trailcurrentoss/TrailCurrentCapstan/CAD/back.jpg

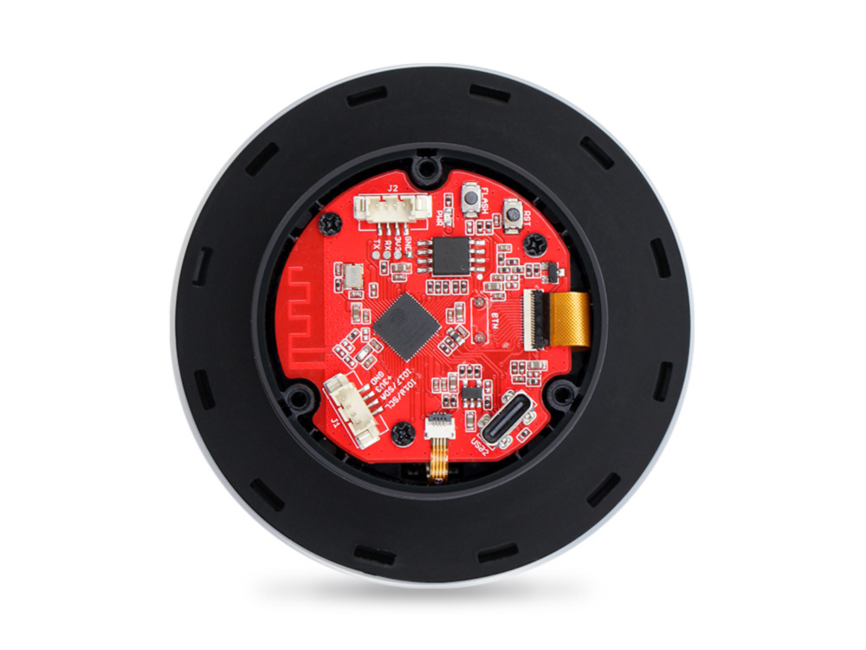
CAD/back.jpg
