trailcurrentoss/TrailCurrentCapstan/CAD/front.jpg

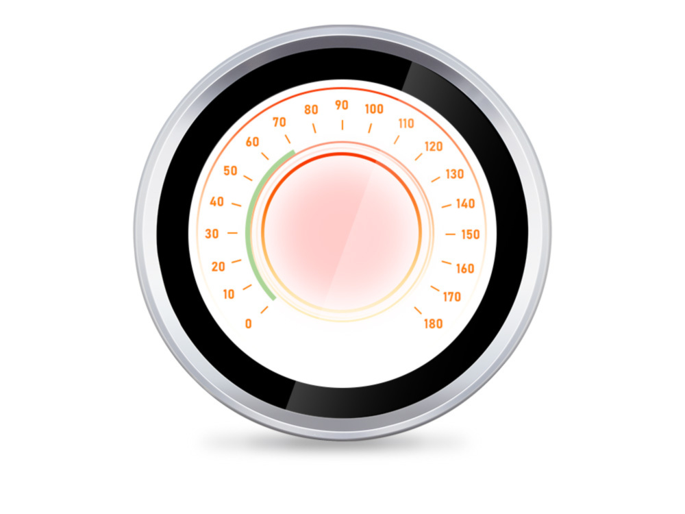
CAD/front.jpg
