trailcurrentoss/TrailCurrentCapstan/CAD/side.jpg

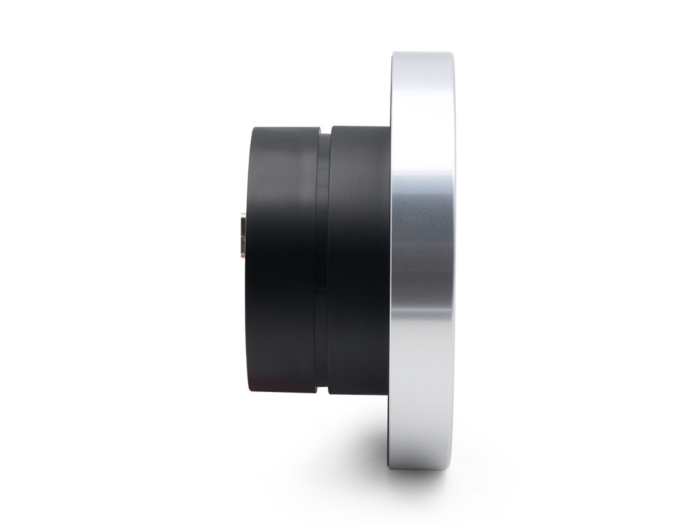
CAD/side.jpg
