trailcurrentoss/TrailCurrentCapstan/DOCS/CrowPanel1_46_in/1.46_Rotary_Display_asm_1_asm.stp

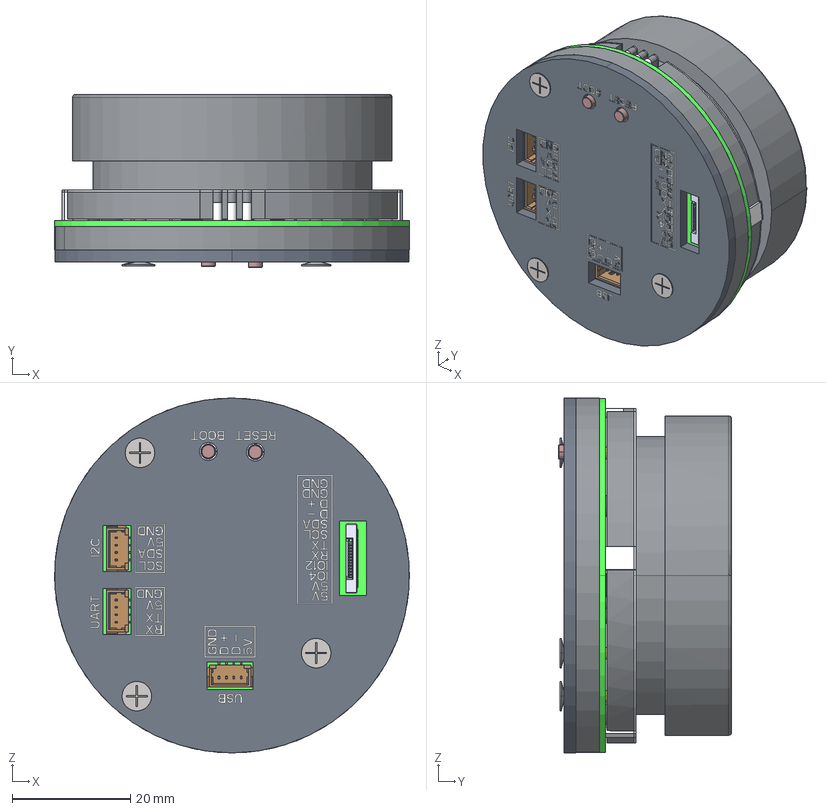
[picture p4: CAD file, 2026-09-28]
DOCS/CrowPanel1_46_in/1.46_Rotary_Display_asm_1_asm.stp
60.0 x 29.3 x 60.0 mm
DIGAI-001_1
LED-SMD_WS2812B-4020_LED-SMD_WS x 8
SW-SMD_HX-4_5X4_5X5_0H-B3JTP__1 x 2
SW-SMD_HX-4_5X4_5X5_0H-B3JTP__2 x 2
FPC-SMD_12P-P0_50_X05C2012TZ__1
FPC-SMD_12P-P0_50_X05C2012TZ__2
FPC-SMD_12P-P0_50_X05C2012TZ__3
FPC-SMD_12P-P0_50_X05C2012TZ__4
FPC-SMD_12P-P0_50_X05C2012TZ__5
FPC-SMD_12P-P0_50_X05C2012TZ__6
FPC-SMD_12P-P0_50_X05C2012TZ__7
FPC-SMD_12P-P0_50_X05C2012TZ__8
FPC-SMD_12P-P0_50_X05C2012TZ__9
FPC-SMD_12P-P0_50_X05C2012TZ_10
FPC-SMD_12P-P0_50_X05C2012TZ_11
FPC-SMD_12P-P0_50_X05C2012TZ_13
FPC-SMD_12P-P0_50_X05C2012TZ_14
FPC-SMD_12P-P0_50_X05C2012TZ_12
CONN-SMD_4P-P1_25_MEGASTAR_ZX_1 x 2
CONN-SMD_4P-P1_25_MEGASTAR_ZX_2 x 2
CONN-SMD_4P-P1_25_MEGASTAR_ZX_3 x 2
P146B001-IPS_1
PRT0008_1_1
PRT0008_1_2
PRT0008_1_3
PRT0008_1_4
PRT0012_1
PRT0013_1
FPC-SMD_14P-P0_50_HC-FPC-05-2_1
FPC-SMD_14P-P0_50_HC-FPC-05-2_2
FPC-SMD_14P-P0_50_HC-FPC-05-2_3
FPC-SMD_14P-P0_50_HC-FPC-05-2_4
FPC-SMD_14P-P0_50_HC-FPC-05-2_5
FPC-SMD_14P-P0_50_HC-FPC-05-2_6
FPC-SMD_14P-P0_50_HC-FPC-05-2_7
FPC-SMD_14P-P0_50_HC-FPC-05-2_8
FPC-SMD_14P-P0_50_HC-FPC-05-2_9
FPC-SMD_14P-P0_50_HC-FPC-05-_10
FPC-SMD_14P-P0_50_HC-FPC-05-_11
FPC-SMD_14P-P0_50_HC-FPC-05-_12
FPC-SMD_14P-P0_50_HC-FPC-05-_13
FPC-SMD_14P-P0_50_HC-FPC-05-_14
FPC-SMD_14P-P0_50_HC-FPC-05-_15
FPC-SMD_14P-P0_50_HC-FPC-05-_16
FPC-SMD_14P-P0_50_HC-FPC-05-_17
FPC-SMD_14P-P0_50_HC-FPC-05-_18
FPC-SMD_14P-P0_50_HC-FPC-05-_19
FPC-SMD_14P-P0_50_HC-FPC-05-_20
FPC-SMD_14P-P0_50_HC-FPC-05-_21
FPC-SMD_14P-P0_50_HC-FPC-05-_22
FPC-SMD_14P-P0_50_HC-FPC-05-_23
FPC-SMD_14P-P0_50_HC-FPC-05-_24
FPC-SMD_14P-P0_50_HC-FPC-05-_25
FPC-SMD_14P-P0_50_HC-FPC-05-_26
FPC-SMD_14P-P0_50_HC-FPC-05-_27
FPC-SMD_14P-P0_50_HC-FPC-05-_28
FPC-SMD_14P-P0_50_HC-FPC-05-_29
FPC-SMD_14P-P0_50_HC-FPC-05-_30
FPC-SMD_14P-P0_50_HC-FPC-05-_31
ABF24D66-D606-482B-91E4-7AD95_1 x 3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
