trailcurrentoss/TrailCurrentCapstan/CAD/elecrow-crowpanel-1_28-case.FCStd

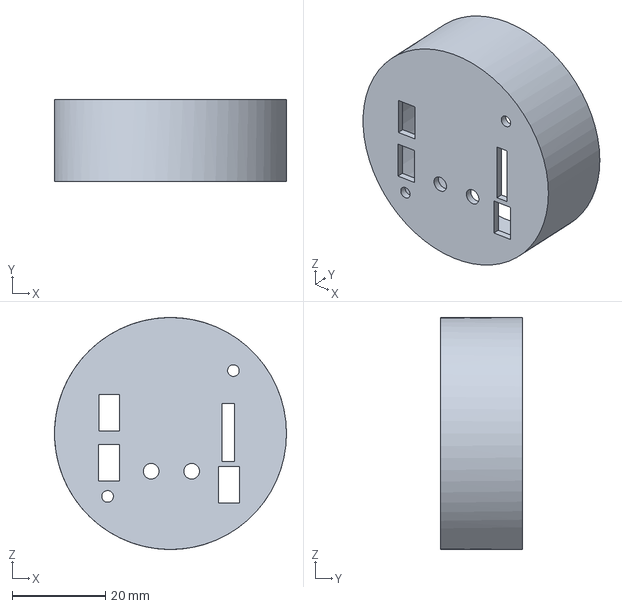
[picture p5: CAD file, 2026-10-01]
CAD/elecrow-crowpanel-1_28-case.FCStd
49.8 x 17.7 x 49.8 mm
