trailcurrentoss/TrailCurrentCapstan/CAD/makerfabs-matouch-2_1-case-desktop.FCStd

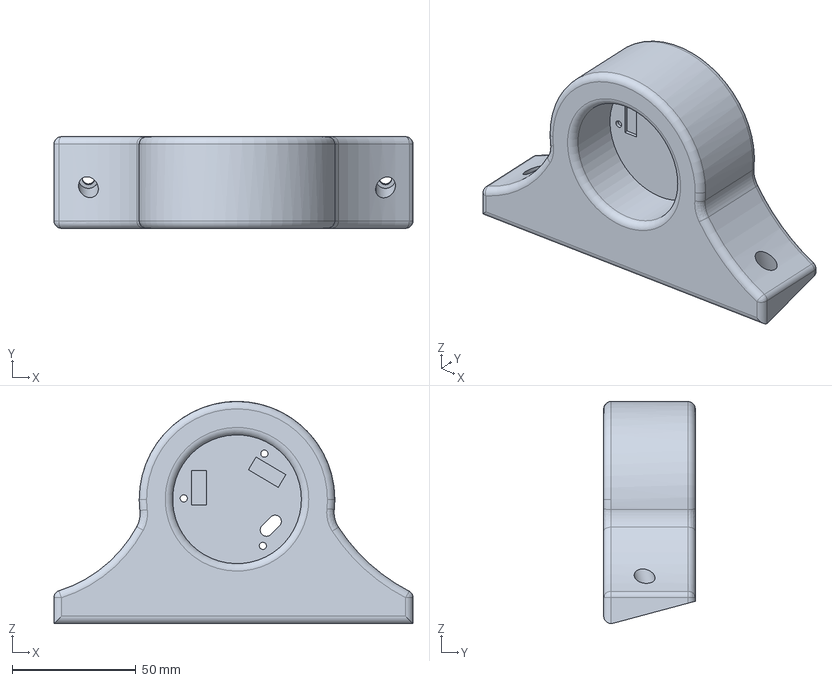
[picture p7: CAD file, 2026-10-01]
CAD/makerfabs-matouch-2_1-case-desktop.FCStd
145.0 x 37.0 x 89.7 mm
