trailcurrentoss/TrailCurrentCapstan/CAD/makerfabs-matouch-2_1-case.FCStd

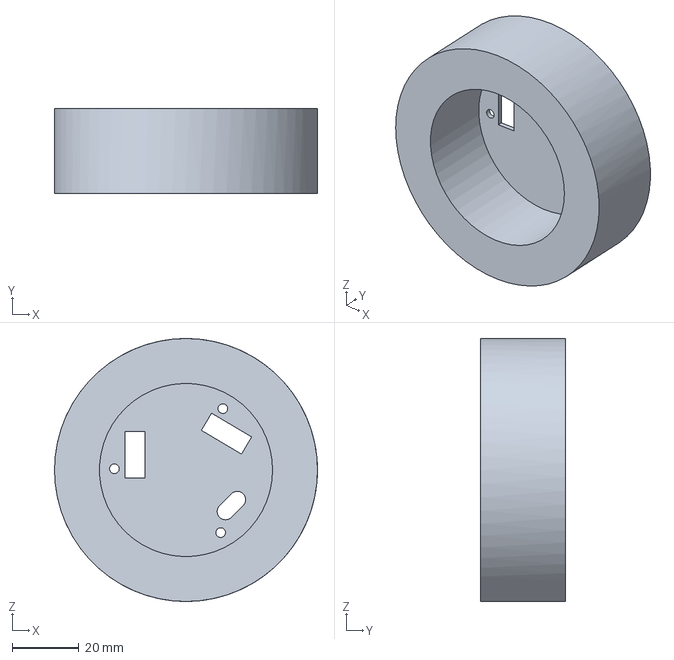
[picture p8: CAD file, 2026-10-01]
CAD/makerfabs-matouch-2_1-case.FCStd
79.0 x 25.5 x 79.0 mm
