trailcurrentoss/TrailCurrentCapstan/main/ui/240/screens.c

#include <string.h>

#include "screens.h"
#include "images.h"
#include "fonts.h"
#include "actions.h"
#include "vars.h"
#include "styles.h"
#include "ui.h"

#include <string.h>

objects_t objects;

screen_page_idle_state_t screen_page_idle_state;
screen_page_climate_state_t screen_page_climate_state;
screen_page_clock_face_state_t screen_page_clock_face_state;

//
// Event handlers
//

lv_obj_t *tick_value_change_obj;

//
// Screens
//

void create_screen_page_idle() {
    screen_page_idle_state_t *state = &screen_page_idle_state;
    (void)state;
    lv_obj_t *obj = lv_obj_create(0);
    objects.page_idle = obj;
    lv_obj_set_pos(obj, 0, 0);
    lv_obj_set_size(obj, 240, 240);
    add_style_screen_root(obj);
    {
        lv_obj_t *parent_obj = obj;
        {
            // idle_cl
            lv_obj_t *obj = lv_obj_create(parent_obj);
            objects.idle_cl = obj;
            lv_obj_set_pos(obj, LV_PCT(0), LV_PCT(0));
            lv_obj_set_size(obj, LV_PCT(100), LV_PCT(100));
            add_style_plain(obj);
            {
                lv_obj_t *parent_obj = obj;
                {
                    // idle_cl_ticks
                    lv_obj_t *obj = lv_scale_create(parent_obj);
                    objects.idle_cl_ticks = obj;
                    lv_obj_set_pos(obj, 5, 5);
                    lv_obj_set_size(obj, 230, 230);
                    lv_scale_set_mode(obj, LV_SCALE_MODE_ROUND_INNER);
                    lv_scale_set_range(obj, 0, 59);
                    lv_scale_set_angle_range(obj, 354);
                    lv_scale_set_rotation(obj, 270);
                    lv_scale_set_total_tick_count(obj, 60);
                    lv_scale_set_major_tick_every(obj, 5);
                    lv_scale_set_label_show(obj, false);
                    add_style_face_ticks(obj);
                }
                {
                    // idle_cl_day
                    lv_obj_t *obj = lv_label_create(parent_obj);
                    objects.idle_cl_day = obj;
                    lv_obj_set_pos(obj, LV_PCT(15), LV_PCT(16));
                    lv_obj_set_size(obj, LV_PCT(70), LV_SIZE_CONTENT);
                    lv_label_set_long_mode(obj, LV_LABEL_LONG_DOT);
                    add_style_face_text_lg(obj);
                    lv_obj_set_style_text_align(obj, LV_TEXT_ALIGN_CENTER, LV_PART_MAIN | LV_STATE_DEFAULT);
                    lv_label_set_text(obj, "Tuesday");
                }
                {
                    // idle_cl_date
                    lv_obj_t *obj = lv_label_create(parent_obj);
                    objects.idle_cl_date = obj;
                    lv_obj_set_pos(obj, LV_PCT(15), LV_PCT(24));
                    lv_obj_set_size(obj, LV_PCT(70), LV_SIZE_CONTENT);
                    lv_label_set_long_mode(obj, LV_LABEL_LONG_DOT);
                    add_style_face_text_md(obj);
                    lv_obj_set_style_text_align(obj, LV_TEXT_ALIGN_CENTER, LV_PART_MAIN | LV_STATE_DEFAULT);
                    lv_label_set_text(obj, "September 29, 2026");
                }
                {
                    // idle_cl_inside
                    lv_obj_t *obj = lv_label_create(parent_obj);
                    objects.idle_cl_inside = obj;
                    lv_obj_set_pos(obj, LV_PCT(15), LV_PCT(59));
                    lv_obj_set_size(obj, LV_PCT(70), LV_SIZE_CONTENT);
                    lv_label_set_long_mode(obj, LV_LABEL_LONG_DOT);
                    add_style_face_text_lg(obj);
                    lv_obj_set_style_text_align(obj, LV_TEXT_ALIGN_CENTER, LV_PART_MAIN | LV_STATE_DEFAULT);
                    lv_label_set_text(obj, "Inside 67°");
                }
                {
                    // idle_cl_moderow
                    lv_obj_t *obj = lv_obj_create(parent_obj);
                    objects.idle_cl_moderow = obj;
                    lv_obj_set_pos(obj, LV_PCT(10), LV_PCT(68));
                    lv_obj_set_size(obj, LV_PCT(80), LV_SIZE_CONTENT);
                    add_style_plain(obj);
                    lv_obj_set_style_layout(obj, LV_LAYOUT_FLEX, LV_PART_MAIN | LV_STATE_DEFAULT);
                    lv_obj_set_style_flex_flow(obj, LV_FLEX_FLOW_ROW, LV_PART_MAIN | LV_STATE_DEFAULT);
                    lv_obj_set_style_flex_main_place(obj, LV_FLEX_ALIGN_CENTER, LV_PART_MAIN | LV_STATE_DEFAULT);
                    lv_obj_set_style_flex_cross_place(obj, LV_FLEX_ALIGN_CENTER, LV_PART_MAIN | LV_STATE_DEFAULT);
                    lv_obj_set_style_flex_track_place(obj, LV_FLEX_ALIGN_CENTER, LV_PART_MAIN | LV_STATE_DEFAULT);
                    lv_obj_set_style_pad_column(obj, 0, LV_PART_MAIN | LV_STATE_DEFAULT);
                    {
                        lv_obj_t *parent_obj = obj;
                        {
                            // idle_cl_mode
                            lv_obj_t *obj = lv_obj_create(parent_obj);
                            objects.idle_cl_mode = obj;
                            lv_obj_set_pos(obj, LV_PCT(0), LV_PCT(0));
                            lv_obj_set_size(obj, LV_SIZE_CONTENT, LV_SIZE_CONTENT);
                            add_style_plain(obj);
                            lv_obj_set_style_layout(obj, LV_LAYOUT_FLEX, LV_PART_MAIN | LV_STATE_DEFAULT);
                            lv_obj_set_style_flex_flow(obj, LV_FLEX_FLOW_ROW, LV_PART_MAIN | LV_STATE_DEFAULT);
                            lv_obj_set_style_flex_main_place(obj, LV_FLEX_ALIGN_CENTER, LV_PART_MAIN | LV_STATE_DEFAULT);
                            lv_obj_set_style_flex_cross_place(obj, LV_FLEX_ALIGN_CENTER, LV_PART_MAIN | LV_STATE_DEFAULT);
                            lv_obj_set_style_flex_track_place(obj, LV_FLEX_ALIGN_CENTER, LV_PART_MAIN | LV_STATE_DEFAULT);
                            lv_obj_set_style_pad_column(obj, 4, LV_PART_MAIN | LV_STATE_DEFAULT);
                            {
                                lv_obj_t *parent_obj = obj;
                                {
                                    // idle_cl_mode_icon
                                    lv_obj_t *obj = lv_label_create(parent_obj);
                                    objects.idle_cl_mode_icon = obj;
                                    lv_obj_set_pos(obj, LV_PCT(0), LV_PCT(0));
                                    lv_obj_set_size(obj, LV_SIZE_CONTENT, LV_SIZE_CONTENT);
                                    lv_label_set_long_mode(obj, LV_LABEL_LONG_CLIP);
                                    add_style_face_mode_icon(obj);
                                    lv_label_set_text_static(obj, "");
                                }
                                {
                                    // idle_cl_mode_text
                                    lv_obj_t *obj = lv_label_create(parent_obj);
                                    objects.idle_cl_mode_text = obj;
                                    lv_obj_set_pos(obj, LV_PCT(0), LV_PCT(0));
                                    lv_obj_set_size(obj, LV_SIZE_CONTENT, LV_SIZE_CONTENT);
                                    lv_label_set_long_mode(obj, LV_LABEL_LONG_DOT);
                                    add_style_face_mode(obj);
                                    lv_label_set_text(obj, "Heating to 72°");
                                }
                            }
                        }
                    }
                }
                {
                    // idle_cl_stats
                    lv_obj_t *obj = lv_obj_create(parent_obj);
                    objects.idle_cl_stats = obj;
                    lv_obj_set_pos(obj, LV_PCT(10), LV_PCT(78));
                    lv_obj_set_size(obj, LV_PCT(80), LV_SIZE_CONTENT);
                    add_style_plain(obj);
                    lv_obj_set_style_layout(obj, LV_LAYOUT_FLEX, LV_PART_MAIN | LV_STATE_DEFAULT);
                    lv_obj_set_style_flex_flow(obj, LV_FLEX_FLOW_ROW, LV_PART_MAIN | LV_STATE_DEFAULT);
                    lv_obj_set_style_flex_main_place(obj, LV_FLEX_ALIGN_CENTER, LV_PART_MAIN | LV_STATE_DEFAULT);
                    lv_obj_set_style_flex_cross_place(obj, LV_FLEX_ALIGN_CENTER, LV_PART_MAIN | LV_STATE_DEFAULT);
                    lv_obj_set_style_flex_track_place(obj, LV_FLEX_ALIGN_CENTER, LV_PART_MAIN | LV_STATE_DEFAULT);
                    lv_obj_set_style_pad_column(obj, 10, LV_PART_MAIN | LV_STATE_DEFAULT);
                    {
                        lv_obj_t *parent_obj = obj;
                        {
                            // idle_cl_batt
                            lv_obj_t *obj = lv_obj_create(parent_obj);
                            objects.idle_cl_batt = obj;
                            lv_obj_set_pos(obj, LV_PCT(0), LV_PCT(0));
                            lv_obj_set_size(obj, LV_SIZE_CONTENT, LV_SIZE_CONTENT);
                            add_style_plain(obj);
                            lv_obj_set_style_layout(obj, LV_LAYOUT_FLEX, LV_PART_MAIN | LV_STATE_DEFAULT);
                            lv_obj_set_style_flex_flow(obj, LV_FLEX_FLOW_ROW, LV_PART_MAIN | LV_STATE_DEFAULT);
                            lv_obj_set_style_flex_main_place(obj, LV_FLEX_ALIGN_CENTER, LV_PART_MAIN | LV_STATE_DEFAULT);
                            lv_obj_set_style_flex_cross_place(obj, LV_FLEX_ALIGN_CENTER, LV_PART_MAIN | LV_STATE_DEFAULT);
                            lv_obj_set_style_flex_track_place(obj, LV_FLEX_ALIGN_CENTER, LV_PART_MAIN | LV_STATE_DEFAULT);
                            lv_obj_set_style_pad_column(obj, 3, LV_PART_MAIN | LV_STATE_DEFAULT);
                            {
                                lv_obj_t *parent_obj = obj;
                                {
                                    // idle_cl_batt_icon
                                    lv_obj_t *obj = lv_label_create(parent_obj);
                                    objects.idle_cl_batt_icon = obj;
                                    lv_obj_set_pos(obj, LV_PCT(0), LV_PCT(0));
                                    lv_obj_set_size(obj, LV_SIZE_CONTENT, LV_SIZE_CONTENT);
                                    lv_label_set_long_mode(obj, LV_LABEL_LONG_CLIP);
                                    add_style_face_stat_icon(obj);
                                    lv_label_set_text_static(obj, "");
                                }
                                {
                                    // idle_cl_batt_value
                                    lv_obj_t *obj = lv_label_create(parent_obj);
                                    objects.idle_cl_batt_value = obj;
                                    lv_obj_set_pos(obj, LV_PCT(0), LV_PCT(0));
                                    lv_obj_set_size(obj, LV_SIZE_CONTENT, LV_SIZE_CONTENT);
                                    lv_label_set_long_mode(obj, LV_LABEL_LONG_DOT);
                                    add_style_face_stat(obj);
                                    lv_label_set_text(obj, "82%");
                                }
                            }
                        }
                        {
                            // idle_cl_water
                            lv_obj_t *obj = lv_obj_create(parent_obj);
                            objects.idle_cl_water = obj;
                            lv_obj_set_pos(obj, LV_PCT(0), LV_PCT(0));
                            lv_obj_set_size(obj, LV_SIZE_CONTENT, LV_SIZE_CONTENT);
                            add_style_plain(obj);
                            lv_obj_set_style_layout(obj, LV_LAYOUT_FLEX, LV_PART_MAIN | LV_STATE_DEFAULT);
                            lv_obj_set_style_flex_flow(obj, LV_FLEX_FLOW_ROW, LV_PART_MAIN | LV_STATE_DEFAULT);
                            lv_obj_set_style_flex_main_place(obj, LV_FLEX_ALIGN_CENTER, LV_PART_MAIN | LV_STATE_DEFAULT);
                            lv_obj_set_style_flex_cross_place(obj, LV_FLEX_ALIGN_CENTER, LV_PART_MAIN | LV_STATE_DEFAULT);
                            lv_obj_set_style_flex_track_place(obj, LV_FLEX_ALIGN_CENTER, LV_PART_MAIN | LV_STATE_DEFAULT);
                            lv_obj_set_style_pad_column(obj, 3, LV_PART_MAIN | LV_STATE_DEFAULT);
                            {
                                lv_obj_t *parent_obj = obj;
                                {
                                    // idle_cl_water_icon
                                    lv_obj_t *obj = lv_label_create(parent_obj);
                                    objects.idle_cl_water_icon = obj;
                                    lv_obj_set_pos(obj, LV_PCT(0), LV_PCT(0));
                                    lv_obj_set_size(obj, LV_SIZE_CONTENT, LV_SIZE_CONTENT);
                                    lv_label_set_long_mode(obj, LV_LABEL_LONG_CLIP);
                                    add_style_face_stat_icon(obj);
                                    lv_label_set_text_static(obj, "");
                                }
                                {
                                    // idle_cl_water_value
                                    lv_obj_t *obj = lv_label_create(parent_obj);
                                    objects.idle_cl_water_value = obj;
                                    lv_obj_set_pos(obj, LV_PCT(0), LV_PCT(0));
                                    lv_obj_set_size(obj, LV_SIZE_CONTENT, LV_SIZE_CONTENT);
                                    lv_label_set_long_mode(obj, LV_LABEL_LONG_DOT);
                                    add_style_face_stat(obj);
                                    lv_label_set_text(obj, "72%");
                                }
                            }
                        }
                    }
                }
                {
                    // idle_cl_hand_h
                    lv_obj_t *obj = lv_line_create(parent_obj);
                    objects.idle_cl_hand_h = obj;
                    lv_obj_set_pos(obj, LV_PCT(0), LV_PCT(0));
                    lv_obj_set_size(obj, LV_PCT(100), LV_PCT(100));
                    static lv_point_precise_t line_points[] = {
                        { 120, 120 },
                        { 120, 65 }
                    };
                    lv_line_set_points(obj, line_points, 2);
                    add_style_face_hand_h(obj);
                }
                {
                    // idle_cl_hand_m
                    lv_obj_t *obj = lv_line_create(parent_obj);
                    objects.idle_cl_hand_m = obj;
                    lv_obj_set_pos(obj, LV_PCT(0), LV_PCT(0));
                    lv_obj_set_size(obj, LV_PCT(100), LV_PCT(100));
                    static lv_point_precise_t line_points[] = {
                        { 120, 120 },
                        { 120, 35 }
                    };
                    lv_line_set_points(obj, line_points, 2);
                    add_style_face_hand_m(obj);
                }
                {
                    // idle_cl_hand_s
                    lv_obj_t *obj = lv_line_create(parent_obj);
                    objects.idle_cl_hand_s = obj;
                    lv_obj_set_pos(obj, LV_PCT(0), LV_PCT(0));
                    lv_obj_set_size(obj, LV_PCT(100), LV_PCT(100));
                    static lv_point_precise_t line_points[] = {
                        { 120, 135 },
                        { 120, 25 }
                    };
                    lv_line_set_points(obj, line_points, 2);
                    add_style_face_hand_s(obj);
                }
                {
                    // idle_cl_cap
                    lv_obj_t *obj = lv_obj_create(parent_obj);
                    objects.idle_cl_cap = obj;
                    lv_obj_set_pos(obj, LV_PCT(48), LV_PCT(48));
                    lv_obj_set_size(obj, LV_PCT(4), LV_PCT(4));
                    add_style_face_cap(obj);
                }
                {
                    // idle_cl_cap_in
                    lv_obj_t *obj = lv_obj_create(parent_obj);
                    objects.idle_cl_cap_in = obj;
                    lv_obj_set_pos(obj, LV_PCT(49), LV_PCT(49));
                    lv_obj_set_size(obj, LV_PCT(1), LV_PCT(1));
                    add_style_face_cap_in(obj);
                }
            }
        }
        {
            // idle_dg
            lv_obj_t *obj = lv_obj_create(parent_obj);
            objects.idle_dg = obj;
            lv_obj_set_pos(obj, LV_PCT(0), LV_PCT(0));
            lv_obj_set_size(obj, LV_PCT(100), LV_PCT(100));
            lv_obj_add_flag(obj, LV_OBJ_FLAG_HIDDEN);
            add_style_plain(obj);
            {
                lv_obj_t *parent_obj = obj;
                {
                    // idle_dg_ticks
                    lv_obj_t *obj = lv_scale_create(parent_obj);
                    objects.idle_dg_ticks = obj;
                    lv_obj_set_pos(obj, 5, 5);
                    lv_obj_set_size(obj, 230, 230);
                    lv_scale_set_mode(obj, LV_SCALE_MODE_ROUND_INNER);
                    lv_scale_set_range(obj, 0, 59);
                    lv_scale_set_angle_range(obj, 354);
                    lv_scale_set_rotation(obj, 270);
                    lv_scale_set_total_tick_count(obj, 60);
                    lv_scale_set_major_tick_every(obj, 5);
                    lv_scale_set_label_show(obj, false);
                    {
                        state->scale_section = lv_scale_add_section(obj);
                        lv_scale_section_set_style(state->scale_section, LV_PART_MAIN, get_style_face_sec_on_MAIN_DEFAULT());
                        lv_scale_section_set_style(state->scale_section, LV_PART_INDICATOR, get_style_face_sec_on_INDICATOR_DEFAULT());
                        lv_scale_section_set_style(state->scale_section, LV_PART_ITEMS, get_style_face_sec_on_ITEMS_DEFAULT());
                    }
                    add_style_face_sec_ticks(obj);
                }
                {
                    // idle_dg_date
                    lv_obj_t *obj = lv_label_create(parent_obj);
                    objects.idle_dg_date = obj;
                    lv_obj_set_pos(obj, LV_PCT(15), LV_PCT(20));
                    lv_obj_set_size(obj, LV_PCT(70), LV_SIZE_CONTENT);
                    lv_label_set_long_mode(obj, LV_LABEL_LONG_DOT);
                    add_style_face_text_lg(obj);
                    lv_obj_set_style_text_align(obj, LV_TEXT_ALIGN_CENTER, LV_PART_MAIN | LV_STATE_DEFAULT);
                    lv_label_set_text(obj, "Tuesday · September 29");
                }
                {
                    // idle_dg_timerow
                    lv_obj_t *obj = lv_obj_create(parent_obj);
                    objects.idle_dg_timerow = obj;
                    lv_obj_set_pos(obj, LV_PCT(10), LV_PCT(27));
                    lv_obj_set_size(obj, LV_PCT(80), LV_SIZE_CONTENT);
                    add_style_plain(obj);
                    lv_obj_set_style_layout(obj, LV_LAYOUT_FLEX, LV_PART_MAIN | LV_STATE_DEFAULT);
                    lv_obj_set_style_flex_flow(obj, LV_FLEX_FLOW_ROW, LV_PART_MAIN | LV_STATE_DEFAULT);
                    lv_obj_set_style_flex_main_place(obj, LV_FLEX_ALIGN_CENTER, LV_PART_MAIN | LV_STATE_DEFAULT);
                    lv_obj_set_style_flex_cross_place(obj, LV_FLEX_ALIGN_START, LV_PART_MAIN | LV_STATE_DEFAULT);
                    lv_obj_set_style_flex_track_place(obj, LV_FLEX_ALIGN_CENTER, LV_PART_MAIN | LV_STATE_DEFAULT);
                    lv_obj_set_style_pad_column(obj, 4, LV_PART_MAIN | LV_STATE_DEFAULT);
                    {
                        lv_obj_t *parent_obj = obj;
                        {
                            // idle_dg_time
                            lv_obj_t *obj = lv_label_create(parent_obj);
                            objects.idle_dg_time = obj;
                            lv_obj_set_pos(obj, LV_PCT(0), LV_PCT(0));
                            lv_obj_set_size(obj, LV_SIZE_CONTENT, LV_SIZE_CONTENT);
                            lv_label_set_long_mode(obj, LV_LABEL_LONG_DOT);
                            add_style_face_time(obj);
                            lv_label_set_text(obj, "7:42");
                        }
                        {
                            // idle_dg_ampm
                            lv_obj_t *obj = lv_label_create(parent_obj);
                            objects.idle_dg_ampm = obj;
                            lv_obj_set_pos(obj, LV_PCT(0), LV_PCT(0));
                            lv_obj_set_size(obj, LV_SIZE_CONTENT, LV_SIZE_CONTENT);
                            lv_label_set_long_mode(obj, LV_LABEL_LONG_DOT);
                            add_style_face_am_pm(obj);
                            lv_label_set_text(obj, "PM");
                        }
                    }
                }
                {
                    // idle_dg_inside
                    lv_obj_t *obj = lv_label_create(parent_obj);
                    objects.idle_dg_inside = obj;
                    lv_obj_set_pos(obj, LV_PCT(15), LV_PCT(63));
                    lv_obj_set_size(obj, LV_PCT(70), LV_SIZE_CONTENT);
                    lv_label_set_long_mode(obj, LV_LABEL_LONG_DOT);
                    add_style_face_text_lg(obj);
                    lv_obj_set_style_text_align(obj, LV_TEXT_ALIGN_CENTER, LV_PART_MAIN | LV_STATE_DEFAULT);
                    lv_label_set_text(obj, "Inside 67°");
                }
                {
                    // idle_dg_moderow
                    lv_obj_t *obj = lv_obj_create(parent_obj);
                    objects.idle_dg_moderow = obj;
                    lv_obj_set_pos(obj, LV_PCT(10), LV_PCT(71));
                    lv_obj_set_size(obj, LV_PCT(80), LV_SIZE_CONTENT);
                    add_style_plain(obj);
                    lv_obj_set_style_layout(obj, LV_LAYOUT_FLEX, LV_PART_MAIN | LV_STATE_DEFAULT);
                    lv_obj_set_style_flex_flow(obj, LV_FLEX_FLOW_ROW, LV_PART_MAIN | LV_STATE_DEFAULT);
                    lv_obj_set_style_flex_main_place(obj, LV_FLEX_ALIGN_CENTER, LV_PART_MAIN | LV_STATE_DEFAULT);
                    lv_obj_set_style_flex_cross_place(obj, LV_FLEX_ALIGN_CENTER, LV_PART_MAIN | LV_STATE_DEFAULT);
                    lv_obj_set_style_flex_track_place(obj, LV_FLEX_ALIGN_CENTER, LV_PART_MAIN | LV_STATE_DEFAULT);
                    lv_obj_set_style_pad_column(obj, 0, LV_PART_MAIN | LV_STATE_DEFAULT);
                    {
                        lv_obj_t *parent_obj = obj;
                        {
                            // idle_dg_mode
                            lv_obj_t *obj = lv_obj_create(parent_obj);
                            objects.idle_dg_mode = obj;
                            lv_obj_set_pos(obj, LV_PCT(0), LV_PCT(0));
                            lv_obj_set_size(obj, LV_SIZE_CONTENT, LV_SIZE_CONTENT);
                            add_style_plain(obj);
                            lv_obj_set_style_layout(obj, LV_LAYOUT_FLEX, LV_PART_MAIN | LV_STATE_DEFAULT);
                            lv_obj_set_style_flex_flow(obj, LV_FLEX_FLOW_ROW, LV_PART_MAIN | LV_STATE_DEFAULT);
                            lv_obj_set_style_flex_main_place(obj, LV_FLEX_ALIGN_CENTER, LV_PART_MAIN | LV_STATE_DEFAULT);
                            lv_obj_set_style_flex_cross_place(obj, LV_FLEX_ALIGN_CENTER, LV_PART_MAIN | LV_STATE_DEFAULT);
                            lv_obj_set_style_flex_track_place(obj, LV_FLEX_ALIGN_CENTER, LV_PART_MAIN | LV_STATE_DEFAULT);
                            lv_obj_set_style_pad_column(obj, 4, LV_PART_MAIN | LV_STATE_DEFAULT);
                            {
                                lv_obj_t *parent_obj = obj;
                                {
                                    // idle_dg_mode_icon
                                    lv_obj_t *obj = lv_label_create(parent_obj);
                                    objects.idle_dg_mode_icon = obj;
                                    lv_obj_set_pos(obj, LV_PCT(0), LV_PCT(0));
                                    lv_obj_set_size(obj, LV_SIZE_CONTENT, LV_SIZE_CONTENT);
                                    lv_label_set_long_mode(obj, LV_LABEL_LONG_CLIP);
                                    add_style_face_mode_icon(obj);
                                    lv_label_set_text_static(obj, "");
                                }
                                {
                                    // idle_dg_mode_text
                                    lv_obj_t *obj = lv_label_create(parent_obj);
                                    objects.idle_dg_mode_text = obj;
                                    lv_obj_set_pos(obj, LV_PCT(0), LV_PCT(0));
                                    lv_obj_set_size(obj, LV_SIZE_CONTENT, LV_SIZE_CONTENT);
                                    lv_label_set_long_mode(obj, LV_LABEL_LONG_DOT);
                                    add_style_face_mode(obj);
                                    lv_label_set_text(obj, "Heating to 72°");
                                }
                            }
                        }
                    }
                }
            }
        }
        {
            // idle_br
            lv_obj_t *obj = lv_obj_create(parent_obj);
            objects.idle_br = obj;
            lv_obj_set_pos(obj, LV_PCT(0), LV_PCT(0));
            lv_obj_set_size(obj, LV_PCT(100), LV_PCT(100));
            lv_obj_add_flag(obj, LV_OBJ_FLAG_HIDDEN);
            add_style_plain(obj);
            {
                lv_obj_t *parent_obj = obj;
                {
                    // idle_br_arc
                    lv_obj_t *obj = lv_arc_create(parent_obj);
                    objects.idle_br_arc = obj;
                    lv_obj_set_pos(obj, 5, 5);
                    lv_obj_set_size(obj, 230, 230);
                    lv_arc_set_range(obj, 0, 3600);
                    lv_arc_set_value(obj, 2520);
                    lv_arc_set_bg_start_angle(obj, 0);
                    lv_arc_set_bg_end_angle(obj, 360);
                    lv_arc_set_rotation(obj, 270);
                    lv_obj_remove_flag(obj, LV_OBJ_FLAG_CLICKABLE);
                    add_style_face_min_arc(obj);
                }
                {
                    // idle_br_logo
                    lv_obj_t *obj = lv_image_create(parent_obj);
                    objects.idle_br_logo = obj;
                    lv_obj_set_pos(obj, LV_PCT(42), LV_PCT(14));
                    lv_obj_set_size(obj, 38, 38);
                    lv_image_set_src(obj, &img_tc_logo);
                    lv_obj_remove_flag(obj, LV_OBJ_FLAG_ADV_HITTEST|LV_OBJ_FLAG_CLICK_FOCUSABLE|LV_OBJ_FLAG_GESTURE_BUBBLE|LV_OBJ_FLAG_PRESS_LOCK|LV_OBJ_FLAG_SCROLLABLE|LV_OBJ_FLAG_SCROLL_CHAIN_HOR|LV_OBJ_FLAG_SCROLL_CHAIN_VER|LV_OBJ_FLAG_SCROLL_ELASTIC|LV_OBJ_FLAG_SCROLL_MOMENTUM|LV_OBJ_FLAG_SCROLL_WITH_ARROW|LV_OBJ_FLAG_SNAPPABLE);
                }
                {
                    // idle_br_name
                    lv_obj_t *obj = lv_label_create(parent_obj);
                    objects.idle_br_name = obj;
                    lv_obj_set_pos(obj, LV_PCT(15), LV_PCT(32));
                    lv_obj_set_size(obj, LV_PCT(70), LV_SIZE_CONTENT);
                    lv_label_set_long_mode(obj, LV_LABEL_LONG_DOT);
                    add_style_face_brand_name(obj);
                    lv_obj_set_style_text_align(obj, LV_TEXT_ALIGN_CENTER, LV_PART_MAIN | LV_STATE_DEFAULT);
                    lv_label_set_text(obj, "TrailCurrent");
                }
                {
                    // idle_br_timerow
                    lv_obj_t *obj = lv_obj_create(parent_obj);
                    objects.idle_br_timerow = obj;
                    lv_obj_set_pos(obj, LV_PCT(10), LV_PCT(38));
                    lv_obj_set_size(obj, LV_PCT(80), LV_SIZE_CONTENT);
                    add_style_plain(obj);
                    lv_obj_set_style_layout(obj, LV_LAYOUT_FLEX, LV_PART_MAIN | LV_STATE_DEFAULT);
                    lv_obj_set_style_flex_flow(obj, LV_FLEX_FLOW_ROW, LV_PART_MAIN | LV_STATE_DEFAULT);
                    lv_obj_set_style_flex_main_place(obj, LV_FLEX_ALIGN_CENTER, LV_PART_MAIN | LV_STATE_DEFAULT);
                    lv_obj_set_style_flex_cross_place(obj, LV_FLEX_ALIGN_START, LV_PART_MAIN | LV_STATE_DEFAULT);
                    lv_obj_set_style_flex_track_place(obj, LV_FLEX_ALIGN_CENTER, LV_PART_MAIN | LV_STATE_DEFAULT);
                    lv_obj_set_style_pad_column(obj, 3, LV_PART_MAIN | LV_STATE_DEFAULT);
                    {
                        lv_obj_t *parent_obj = obj;
                        {
                            // idle_br_time
                            lv_obj_t *obj = lv_label_create(parent_obj);
                            objects.idle_br_time = obj;
                            lv_obj_set_pos(obj, LV_PCT(0), LV_PCT(0));
                            lv_obj_set_size(obj, LV_SIZE_CONTENT, LV_SIZE_CONTENT);
                            lv_label_set_long_mode(obj, LV_LABEL_LONG_DOT);
                            add_style_face_time_sm(obj);
                            lv_label_set_text(obj, "7:42");
                        }
                        {
                            // idle_br_ampm
                            lv_obj_t *obj = lv_label_create(parent_obj);
                            objects.idle_br_ampm = obj;
                            lv_obj_set_pos(obj, LV_PCT(0), LV_PCT(0));
                            lv_obj_set_size(obj, LV_SIZE_CONTENT, LV_SIZE_CONTENT);
                            lv_label_set_long_mode(obj, LV_LABEL_LONG_DOT);
                            add_style_face_am_pm_sm(obj);
                            lv_label_set_text(obj, "PM");
                        }
                    }
                }
                {
                    // idle_br_date
                    lv_obj_t *obj = lv_label_create(parent_obj);
                    objects.idle_br_date = obj;
                    lv_obj_set_pos(obj, LV_PCT(15), LV_PCT(65));
                    lv_obj_set_size(obj, LV_PCT(70), LV_SIZE_CONTENT);
                    lv_label_set_long_mode(obj, LV_LABEL_LONG_DOT);
                    add_style_face_text_muted(obj);
                    lv_obj_set_style_text_align(obj, LV_TEXT_ALIGN_CENTER, LV_PART_MAIN | LV_STATE_DEFAULT);
                    lv_label_set_text(obj, "Tuesday · September 29");
                }
                {
                    // idle_br_bottom
                    lv_obj_t *obj = lv_obj_create(parent_obj);
                    objects.idle_br_bottom = obj;
                    lv_obj_set_pos(obj, LV_PCT(10), LV_PCT(72));
                    lv_obj_set_size(obj, LV_PCT(80), LV_SIZE_CONTENT);
                    add_style_plain(obj);
                    lv_obj_set_style_layout(obj, LV_LAYOUT_FLEX, LV_PART_MAIN | LV_STATE_DEFAULT);
                    lv_obj_set_style_flex_flow(obj, LV_FLEX_FLOW_ROW, LV_PART_MAIN | LV_STATE_DEFAULT);
                    lv_obj_set_style_flex_main_place(obj, LV_FLEX_ALIGN_CENTER, LV_PART_MAIN | LV_STATE_DEFAULT);
                    lv_obj_set_style_flex_cross_place(obj, LV_FLEX_ALIGN_CENTER, LV_PART_MAIN | LV_STATE_DEFAULT);
                    lv_obj_set_style_flex_track_place(obj, LV_FLEX_ALIGN_CENTER, LV_PART_MAIN | LV_STATE_DEFAULT);
                    lv_obj_set_style_pad_column(obj, 5, LV_PART_MAIN | LV_STATE_DEFAULT);
                    {
                        lv_obj_t *parent_obj = obj;
                        {
                            // idle_br_inside
                            lv_obj_t *obj = lv_label_create(parent_obj);
                            objects.idle_br_inside = obj;
                            lv_obj_set_pos(obj, LV_PCT(0), LV_PCT(0));
                            lv_obj_set_size(obj, LV_SIZE_CONTENT, LV_SIZE_CONTENT);
                            lv_label_set_long_mode(obj, LV_LABEL_LONG_DOT);
                            add_style_label_body(obj);
                            lv_label_set_text(obj, "Inside 67°");
                        }
                        {
                            // idle_br_mode
                            lv_obj_t *obj = lv_obj_create(parent_obj);
                            objects.idle_br_mode = obj;
                            lv_obj_set_pos(obj, LV_PCT(0), LV_PCT(0));
                            lv_obj_set_size(obj, LV_SIZE_CONTENT, LV_SIZE_CONTENT);
                            add_style_plain(obj);
                            lv_obj_set_style_layout(obj, LV_LAYOUT_FLEX, LV_PART_MAIN | LV_STATE_DEFAULT);
                            lv_obj_set_style_flex_flow(obj, LV_FLEX_FLOW_ROW, LV_PART_MAIN | LV_STATE_DEFAULT);
                            lv_obj_set_style_flex_main_place(obj, LV_FLEX_ALIGN_CENTER, LV_PART_MAIN | LV_STATE_DEFAULT);
                            lv_obj_set_style_flex_cross_place(obj, LV_FLEX_ALIGN_CENTER, LV_PART_MAIN | LV_STATE_DEFAULT);
                            lv_obj_set_style_flex_track_place(obj, LV_FLEX_ALIGN_CENTER, LV_PART_MAIN | LV_STATE_DEFAULT);
                            lv_obj_set_style_pad_column(obj, 4, LV_PART_MAIN | LV_STATE_DEFAULT);
                            {
                                lv_obj_t *parent_obj = obj;
                                {
                                    // idle_br_mode_icon
                                    lv_obj_t *obj = lv_label_create(parent_obj);
                                    objects.idle_br_mode_icon = obj;
                                    lv_obj_set_pos(obj, LV_PCT(0), LV_PCT(0));
                                    lv_obj_set_size(obj, LV_SIZE_CONTENT, LV_SIZE_CONTENT);
                                    lv_label_set_long_mode(obj, LV_LABEL_LONG_CLIP);
                                    add_style_face_mode_icon(obj);
                                    lv_label_set_text_static(obj, "");
                                }
                                {
                                    // idle_br_mode_text
                                    lv_obj_t *obj = lv_label_create(parent_obj);
                                    objects.idle_br_mode_text = obj;
                                    lv_obj_set_pos(obj, LV_PCT(0), LV_PCT(0));
                                    lv_obj_set_size(obj, LV_SIZE_CONTENT, LV_SIZE_CONTENT);
                                    lv_label_set_long_mode(obj, LV_LABEL_LONG_DOT);
                                    add_style_face_mode(obj);
                                    lv_label_set_text(obj, "Heating to 72°");
                                }
                            }
                        }
                    }
                }
            }
        }
        {
            // idle_rg
            lv_obj_t *obj = lv_obj_create(parent_obj);
            objects.idle_rg = obj;
            lv_obj_set_pos(obj, LV_PCT(0), LV_PCT(0));
            lv_obj_set_size(obj, LV_PCT(100), LV_PCT(100));
            lv_obj_add_flag(obj, LV_OBJ_FLAG_HIDDEN);
            add_style_plain(obj);
            {
                lv_obj_t *parent_obj = obj;
                {
                    // idle_rg_arc
                    lv_obj_t *obj = lv_arc_create(parent_obj);
                    objects.idle_rg_arc = obj;
                    lv_obj_set_pos(obj, 5, 5);
                    lv_obj_set_size(obj, 230, 230);
                    lv_arc_set_range(obj, 0, 3600);
                    lv_arc_set_value(obj, 2520);
                    lv_arc_set_bg_start_angle(obj, 0);
                    lv_arc_set_bg_end_angle(obj, 360);
                    lv_arc_set_rotation(obj, 270);
                    lv_obj_remove_flag(obj, LV_OBJ_FLAG_CLICKABLE);
                    add_style_face_ring_arc(obj);
                }
                {
                    // idle_rg_h1
                    lv_obj_t *obj = lv_label_create(parent_obj);
                    objects.idle_rg_h1 = obj;
                    lv_obj_set_pos(obj, LV_PCT(64), LV_PCT(13));
                    lv_obj_set_size(obj, LV_PCT(10), LV_SIZE_CONTENT);
                    lv_label_set_long_mode(obj, LV_LABEL_LONG_CLIP);
                    add_style_face_hour_num(obj);
                    lv_obj_set_style_text_align(obj, LV_TEXT_ALIGN_CENTER, LV_PART_MAIN | LV_STATE_DEFAULT);
                    lv_label_set_text_static(obj, "1");
                }
                {
                    // idle_rg_h2
                    lv_obj_t *obj = lv_label_create(parent_obj);
                    objects.idle_rg_h2 = obj;
                    lv_obj_set_pos(obj, LV_PCT(79), LV_PCT(27));
                    lv_obj_set_size(obj, LV_PCT(10), LV_SIZE_CONTENT);
                    lv_label_set_long_mode(obj, LV_LABEL_LONG_CLIP);
                    add_style_face_hour_num(obj);
                    lv_obj_set_style_text_align(obj, LV_TEXT_ALIGN_CENTER, LV_PART_MAIN | LV_STATE_DEFAULT);
                    lv_label_set_text_static(obj, "2");
                }
                {
                    // idle_rg_h3
                    lv_obj_t *obj = lv_label_create(parent_obj);
                    objects.idle_rg_h3 = obj;
                    lv_obj_set_pos(obj, LV_PCT(84), LV_PCT(46));
                    lv_obj_set_size(obj, LV_PCT(10), LV_SIZE_CONTENT);
                    lv_label_set_long_mode(obj, LV_LABEL_LONG_CLIP);
                    add_style_face_hour_num(obj);
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
                    add_style_face_hour_num(obj);
                    lv_obj_set_style_text_align(obj, LV_TEXT_ALIGN_CENTER, LV_PART_MAIN | LV_STATE_DEFAULT);
                    lv_label_set_text_static(obj, "10");
                }
                {
                    // idle_rg_h11
                    lv_obj_t *obj = lv_label_create(parent_obj);
                    objects.idle_rg_h11 = obj;
                    lv_obj_set_pos(obj, LV_PCT(26), LV_PCT(13));
                    lv_obj_set_size(obj, LV_PCT(10), LV_SIZE_CONTENT);
                    lv_label_set_long_mode(obj, LV_LABEL_LONG_CLIP);
                    add_style_face_hour_num(obj);
                    lv_obj_set_style_text_align(obj, LV_TEXT_ALIGN_CENTER, LV_PART_MAIN | LV_STATE_DEFAULT);
                    lv_label_set_text_static(obj, "11");
                }
                {
                    // idle_rg_h12
                    lv_obj_t *obj = lv_label_create(parent_obj);
                    objects.idle_rg_h12 = obj;
                    lv_obj_set_pos(obj, LV_PCT(45), LV_PCT(8));
                    lv_obj_set_size(obj, LV_PCT(10), LV_SIZE_CONTENT);
                    lv_label_set_long_mode(obj, LV_LABEL_LONG_CLIP);
                    add_style_face_hour_num(obj);
                    lv_obj_set_style_text_align(obj, LV_TEXT_ALIGN_CENTER, LV_PART_MAIN | LV_STATE_DEFAULT);
                    lv_label_set_text_static(obj, "12");
                }
                {
                    // idle_rg_col
                    lv_obj_t *obj = lv_obj_create(parent_obj);
                    objects.idle_rg_col = obj;
                    lv_obj_set_pos(obj, LV_PCT(0), LV_PCT(0));
                    lv_obj_set_size(obj, LV_PCT(100), LV_PCT(100));
                    add_style_plain(obj);
                    lv_obj_set_style_layout(obj, LV_LAYOUT_FLEX, LV_PART_MAIN | LV_STATE_DEFAULT);
                    lv_obj_set_style_flex_flow(obj, LV_FLEX_FLOW_COLUMN, LV_PART_MAIN | LV_STATE_DEFAULT);
                    lv_obj_set_style_flex_main_place(obj, LV_FLEX_ALIGN_CENTER, LV_PART_MAIN | LV_STATE_DEFAULT);
                    lv_obj_set_style_flex_cross_place(obj, LV_FLEX_ALIGN_CENTER, LV_PART_MAIN | LV_STATE_DEFAULT);
                    lv_obj_set_style_flex_track_place(obj, LV_FLEX_ALIGN_CENTER, LV_PART_MAIN | LV_STATE_DEFAULT);
                    lv_obj_set_style_pad_row(obj, 2, LV_PART_MAIN | LV_STATE_DEFAULT);
                    {
                        lv_obj_t *parent_obj = obj;
                        {
                            // idle_rg_eyebrow
                            lv_obj_t *obj = lv_label_create(parent_obj);
                            objects.idle_rg_eyebrow = obj;
                            lv_obj_set_pos(obj, LV_PCT(0), LV_PCT(0));
                            lv_obj_set_size(obj, LV_SIZE_CONTENT, LV_SIZE_CONTENT);
                            lv_label_set_long_mode(obj, LV_LABEL_LONG_DOT);
                            add_style_label_eyebrow(obj);
                            lv_label_set_text(obj, "INSIDE");
                        }
                        {
                            // idle_rg_temp
                            lv_obj_t *obj = lv_label_create(parent_obj);
                            objects.idle_rg_temp = obj;
                            lv_obj_set_pos(obj, LV_PCT(0), LV_PCT(0));
                            lv_obj_set_size(obj, LV_SIZE_CONTENT, LV_SIZE_CONTENT);
                            lv_label_set_long_mode(obj, LV_LABEL_LONG_DOT);
                            add_style_face_time_sm(obj);
                            lv_label_set_text(obj, "67°");
                        }
                        {
                            // idle_rg_time
                            lv_obj_t *obj = lv_label_create(parent_obj);
                            objects.idle_rg_time = obj;
                            lv_obj_set_pos(obj, LV_PCT(0), LV_PCT(0));
                            lv_obj_set_size(obj, LV_SIZE_CONTENT, LV_SIZE_CONTENT);
                            lv_label_set_long_mode(obj, LV_LABEL_LONG_DOT);
                            add_style_face_ring_time(obj);
                            lv_label_set_text(obj, "7:42 PM");
                        }
                        {
                            // idle_rg_mode
                            lv_obj_t *obj = lv_obj_create(parent_obj);
                            objects.idle_rg_mode = obj;
                            lv_obj_set_pos(obj, LV_PCT(0), LV_PCT(0));
                            lv_obj_set_size(obj, LV_SIZE_CONTENT, LV_SIZE_CONTENT);
                            add_style_plain(obj);
                            lv_obj_set_style_layout(obj, LV_LAYOUT_FLEX, LV_PART_MAIN | LV_STATE_DEFAULT);
                            lv_obj_set_style_flex_flow(obj, LV_FLEX_FLOW_ROW, LV_PART_MAIN | LV_STATE_DEFAULT);
                            lv_obj_set_style_flex_main_place(obj, LV_FLEX_ALIGN_CENTER, LV_PART_MAIN | LV_STATE_DEFAULT);
                            lv_obj_set_style_flex_cross_place(obj, LV_FLEX_ALIGN_CENTER, LV_PART_MAIN | LV_STATE_DEFAULT);
                            lv_obj_set_style_flex_track_place(obj, LV_FLEX_ALIGN_CENTER, LV_PART_MAIN | LV_STATE_DEFAULT);
                            lv_obj_set_style_pad_column(obj, 4, LV_PART_MAIN | LV_STATE_DEFAULT);
                            {
                                lv_obj_t *parent_obj = obj;
                                {
                                    // idle_rg_mode_icon
                                    lv_obj_t *obj = lv_label_create(parent_obj);
                                    objects.idle_rg_mode_icon = obj;
                                    lv_obj_set_pos(obj, LV_PCT(0), LV_PCT(0));
                                    lv_obj_set_size(obj, LV_SIZE_CONTENT, LV_SIZE_CONTENT);
                                    lv_label_set_long_mode(obj, LV_LABEL_LONG_CLIP);
                                    add_style_face_mode_icon(obj);
                                    lv_label_set_text_static(obj, "");
                                }
                                {
                                    // idle_rg_mode_text
                                    lv_obj_t *obj = lv_label_create(parent_obj);
                                    objects.idle_rg_mode_text = obj;
                                    lv_obj_set_pos(obj, LV_PCT(0), LV_PCT(0));
                                    lv_obj_set_size(obj, LV_SIZE_CONTENT, LV_SIZE_CONTENT);
                                    lv_label_set_long_mode(obj, LV_LABEL_LONG_DOT);
                                    add_style_face_mode(obj);
                                    lv_label_set_text(obj, "Heating to 72°");
                                }
                            }
                        }
                    }
                }
            }
        }
    }
    
    tick_screen_page_idle();
}

void tick_screen_page_idle() {
    screen_page_idle_state_t *state = &screen_page_idle_state;
    (void)state;
    {
        int32_t new_min_val = get_var_clock_sec_min();
        int32_t new_max_val = get_var_clock_sec_max();
        lv_scale_section_set_range(state->scale_section, new_min_val, new_max_val);
    }
}

void create_screen_page_menu() {
    lv_obj_t *obj = lv_obj_create(0);
    objects.page_menu = obj;
    lv_obj_set_pos(obj, 0, 0);
    lv_obj_set_size(obj, 240, 240);
    add_style_screen_root(obj);
    {
        lv_obj_t *parent_obj = obj;
        {
            // menu_hero
            lv_obj_t *obj = lv_obj_create(parent_obj);
            objects.menu_hero = obj;
            lv_obj_set_pos(obj, LV_PCT(36), LV_PCT(26));
            lv_obj_set_size(obj, LV_PCT(29), LV_PCT(29));
            add_style_hero_tile(obj);
            lv_obj_set_style_radius(obj, 1000, LV_PART_MAIN | LV_STATE_DEFAULT);
            {
                lv_obj_t *parent_obj = obj;
                {
                    // menu_hero_icon
                    lv_obj_t *obj = lv_label_create(parent_obj);
                    objects.menu_hero_icon = obj;
                    lv_obj_set_pos(obj, LV_PCT(0), LV_PCT(0));
                    lv_obj_set_size(obj, LV_SIZE_CONTENT, LV_SIZE_CONTENT);
                    lv_label_set_long_mode(obj, LV_LABEL_LONG_CLIP);
                    add_style_hero_icon(obj);
                    lv_obj_set_style_align(obj, LV_ALIGN_CENTER, LV_PART_MAIN | LV_STATE_DEFAULT);
                    lv_label_set_text_static(obj, "");
                }
            }
        }
        {
            // menu_prev
            lv_obj_t *obj = lv_obj_create(parent_obj);
            objects.menu_prev = obj;
            lv_obj_set_pos(obj, LV_PCT(5), LV_PCT(42));
            lv_obj_set_size(obj, LV_PCT(14), LV_PCT(14));
            add_style_plain(obj);
            {
                lv_obj_t *parent_obj = obj;
                {
                    // menu_prev_icon
                    lv_obj_t *obj = lv_label_create(parent_obj);
                    objects.menu_prev_icon = obj;
                    lv_obj_set_pos(obj, LV_PCT(0), LV_PCT(0));
                    lv_obj_set_size(obj, LV_SIZE_CONTENT, LV_SIZE_CONTENT);
                    lv_label_set_long_mode(obj, LV_LABEL_LONG_CLIP);
                    add_style_neighbour_icon(obj);
                    lv_obj_set_style_align(obj, LV_ALIGN_CENTER, LV_PART_MAIN | LV_STATE_DEFAULT);
                    lv_label_set_text_static(obj, "");
                }
            }
        }
        {
            // menu_next
            lv_obj_t *obj = lv_obj_create(parent_obj);
            objects.menu_next = obj;
            lv_obj_set_pos(obj, LV_PCT(81), LV_PCT(42));
            lv_obj_set_size(obj, LV_PCT(14), LV_PCT(14));
            add_style_plain(obj);
            {
                lv_obj_t *parent_obj = obj;
                {
                    // menu_next_icon
                    lv_obj_t *obj = lv_label_create(parent_obj);
                    objects.menu_next_icon = obj;
                    lv_obj_set_pos(obj, LV_PCT(0), LV_PCT(0));
                    lv_obj_set_size(obj, LV_SIZE_CONTENT, LV_SIZE_CONTENT);
                    lv_label_set_long_mode(obj, LV_LABEL_LONG_CLIP);
                    add_style_neighbour_icon(obj);
                    lv_obj_set_style_align(obj, LV_ALIGN_CENTER, LV_PART_MAIN | LV_STATE_DEFAULT);
                    lv_label_set_text_static(obj, "");
                }
            }
        }
        {
            // menu_title
            lv_obj_t *obj = lv_label_create(parent_obj);
            objects.menu_title = obj;
            lv_obj_set_pos(obj, LV_PCT(22), LV_PCT(59));
            lv_obj_set_size(obj, LV_PCT(56), LV_SIZE_CONTENT);
            lv_label_set_long_mode(obj, LV_LABEL_LONG_DOT);
            add_style_menu_name(obj);
            lv_obj_set_style_text_align(obj, LV_TEXT_ALIGN_CENTER, LV_PART_MAIN | LV_STATE_DEFAULT);
            lv_label_set_text(obj, "Climate");
        }
        {
            // menu_summary
            lv_obj_t *obj = lv_label_create(parent_obj);
            objects.menu_summary = obj;
            lv_obj_set_pos(obj, LV_PCT(22), LV_PCT(69));
            lv_obj_set_size(obj, LV_PCT(56), LV_SIZE_CONTENT);
            lv_label_set_long_mode(obj, LV_LABEL_LONG_DOT);
            add_style_menu_summary(obj);
            lv_obj_set_style_text_align(obj, LV_TEXT_ALIGN_CENTER, LV_PART_MAIN | LV_STATE_DEFAULT);
            lv_label_set_text(obj, "Heating · 72°");
        }
        {
            // menu_dot0
            lv_obj_t *obj = lv_obj_create(parent_obj);
            objects.menu_dot0 = obj;
            lv_obj_set_pos(obj, 161, 215);
            lv_obj_set_size(obj, 5, 5);
            add_style_dot(obj);
            lv_obj_set_style_radius(obj, 1000, LV_PART_MAIN | LV_STATE_DEFAULT);
        }
        {
            // menu_dot1
            lv_obj_t *obj = lv_obj_create(parent_obj);
            objects.menu_dot1 = obj;
            lv_obj_set_pos(obj, 156, 217);
            lv_obj_set_size(obj, 5, 5);
            lv_obj_add_flag(obj, LV_OBJ_FLAG_HIDDEN);
            add_style_dot(obj);
            lv_obj_set_style_radius(obj, 1000, LV_PART_MAIN | LV_STATE_DEFAULT);
        }
        {
            // menu_dot2
            lv_obj_t *obj = lv_obj_create(parent_obj);
            objects.menu_dot2 = obj;
            lv_obj_set_pos(obj, 151, 219);
            lv_obj_set_size(obj, 5, 5);
            add_style_dot(obj);
            lv_obj_set_style_radius(obj, 1000, LV_PART_MAIN | LV_STATE_DEFAULT);
        }
        {
            // menu_dot3
            lv_obj_t *obj = lv_obj_create(parent_obj);
            objects.menu_dot3 = obj;
            lv_obj_set_pos(obj, 145, 221);
            lv_obj_set_size(obj, 5, 5);
            lv_obj_add_flag(obj, LV_OBJ_FLAG_HIDDEN);
            add_style_dot(obj);
            lv_obj_set_style_radius(obj, 1000, LV_PART_MAIN | LV_STATE_DEFAULT);
        }
        {
            // menu_dot4
            lv_obj_t *obj = lv_obj_create(parent_obj);
            objects.menu_dot4 = obj;
            lv_obj_set_pos(obj, 140, 222);
            lv_obj_set_size(obj, 5, 5);
            add_style_dot(obj);
            lv_obj_set_style_radius(obj, 1000, LV_PART_MAIN | LV_STATE_DEFAULT);
        }
        {
            // menu_dot5
            lv_obj_t *obj = lv_obj_create(parent_obj);
            objects.menu_dot5 = obj;
            lv_obj_set_pos(obj, 134, 223);
            lv_obj_set_size(obj, 5, 5);
            lv_obj_add_flag(obj, LV_OBJ_FLAG_HIDDEN);
            add_style_dot(obj);
            lv_obj_set_style_radius(obj, 1000, LV_PART_MAIN | LV_STATE_DEFAULT);
        }
        {
            // menu_dot6
            lv_obj_t *obj = lv_obj_create(parent_obj);
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
            lv_obj_set_pos(obj, 74, 215);
            lv_obj_set_size(obj, 5, 5);
            add_style_dot(obj);
            lv_obj_set_style_radius(obj, 1000, LV_PART_MAIN | LV_STATE_DEFAULT);
        }
    }
    
    tick_screen_page_menu();
}

void tick_screen_page_menu() {
}

void create_screen_page_climate() {
    screen_page_climate_state_t *state = &screen_page_climate_state;
    (void)state;
    lv_obj_t *obj = lv_obj_create(0);
    objects.page_climate = obj;
    lv_obj_set_pos(obj, 0, 0);
    lv_obj_set_size(obj, 240, 240);
    add_style_screen_root(obj);
    {
        lv_obj_t *parent_obj = obj;
        {
            // climate_ticks
            lv_obj_t *obj = lv_scale_create(parent_obj);
            objects.climate_ticks = obj;
            lv_obj_set_pos(obj, 9, 9);
            lv_obj_set_size(obj, 222, 222);
            lv_scale_set_mode(obj, LV_SCALE_MODE_ROUND_INNER);
            lv_scale_set_range(obj, 0, 80);
            lv_scale_set_angle_range(obj, 270);
            lv_scale_set_rotation(obj, 135);
            lv_scale_set_total_tick_count(obj, 81);
            lv_scale_set_major_tick_every(obj, 1);
            lv_scale_set_label_show(obj, false);
            {
                state->scale_section = lv_scale_add_section(obj);
                lv_scale_section_set_style(state->scale_section, LV_PART_MAIN, get_style_climate_section_heat_MAIN_DEFAULT());
                lv_scale_section_set_style(state->scale_section, LV_PART_INDICATOR, get_style_climate_section_heat_INDICATOR_DEFAULT());
            }
            {
                state->scale_section1 = lv_scale_add_section(obj);
                lv_scale_section_set_style(state->scale_section1, LV_PART_MAIN, get_style_climate_section_cool_MAIN_DEFAULT());
                lv_scale_section_set_style(state->scale_section1, LV_PART_INDICATOR, get_style_climate_section_cool_INDICATOR_DEFAULT());
            }
            {
                state->scale_section2 = lv_scale_add_section(obj);
                lv_scale_section_set_style(state->scale_section2, LV_PART_MAIN, get_style_climate_section_hold_MAIN_DEFAULT());
                lv_scale_section_set_style(state->scale_section2, LV_PART_INDICATOR, get_style_climate_section_hold_INDICATOR_DEFAULT());
            }
            add_style_climate_ticks(obj);
        }
        {
            // climate_needle_inside
            lv_obj_t *obj = lv_line_create(parent_obj);
            objects.climate_needle_inside = obj;
            lv_obj_set_pos(obj, LV_PCT(0), LV_PCT(0));
            lv_obj_set_size(obj, LV_PCT(100), LV_PCT(100));
            static lv_point_precise_t line_points[] = {
                { 91, 29 },
                { 86, 14 }
            };
            lv_line_set_points(obj, line_points, 2);
            add_style_climate_needle_inside(obj);
        }
        {
            // climate_needle_target
            lv_obj_t *obj = lv_line_create(parent_obj);
            objects.climate_needle_target = obj;
            lv_obj_set_pos(obj, LV_PCT(0), LV_PCT(0));
            lv_obj_set_size(obj, LV_PCT(100), LV_PCT(100));
            static lv_point_precise_t line_points[] = {
                { 140, 34 },
                { 146, 10 }
            };
            lv_line_set_points(obj, line_points, 2);
            add_style_climate_needle_target(obj);
        }
        {
            // climate_mode_row
            lv_obj_t *obj = lv_obj_create(parent_obj);
            objects.climate_mode_row = obj;
            lv_obj_set_pos(obj, LV_PCT(15), LV_PCT(29));
            lv_obj_set_size(obj, LV_PCT(70), LV_PCT(8));
            add_style_plain(obj);
            lv_obj_set_style_layout(obj, LV_LAYOUT_FLEX, LV_PART_MAIN | LV_STATE_DEFAULT);
            lv_obj_set_style_flex_flow(obj, LV_FLEX_FLOW_ROW, LV_PART_MAIN | LV_STATE_DEFAULT);
            lv_obj_set_style_flex_main_place(obj, LV_FLEX_ALIGN_CENTER, LV_PART_MAIN | LV_STATE_DEFAULT);
            lv_obj_set_style_flex_cross_place(obj, LV_FLEX_ALIGN_CENTER, LV_PART_MAIN | LV_STATE_DEFAULT);
            lv_obj_set_style_flex_track_place(obj, LV_FLEX_ALIGN_CENTER, LV_PART_MAIN | LV_STATE_DEFAULT);
            lv_obj_set_style_pad_column(obj, 4, LV_PART_MAIN | LV_STATE_DEFAULT);
            {
                lv_obj_t *parent_obj = obj;
                {
                    // climate_mode_icon
                    lv_obj_t *obj = lv_label_create(parent_obj);
                    objects.climate_mode_icon = obj;
                    lv_obj_set_pos(obj, LV_PCT(0), LV_PCT(0));
                    lv_obj_set_size(obj, LV_SIZE_CONTENT, LV_SIZE_CONTENT);
                    lv_label_set_long_mode(obj, LV_LABEL_LONG_CLIP);
                    add_style_climate_mode_icon(obj);
                    lv_label_set_text_static(obj, "");
                }
                {
                    // climate_mode
                    lv_obj_t *obj = lv_label_create(parent_obj);
                    objects.climate_mode = obj;
                    lv_obj_set_pos(obj, LV_PCT(0), LV_PCT(0));
                    lv_obj_set_size(obj, LV_SIZE_CONTENT, LV_SIZE_CONTENT);
                    lv_label_set_long_mode(obj, LV_LABEL_LONG_DOT);
                    add_style_climate_mode_text(obj);
                    lv_label_set_text(obj, "HEATING");
                }
            }
        }
        {
            // climate_setpoint
            lv_obj_t *obj = lv_label_create(parent_obj);
            objects.climate_setpoint = obj;
            lv_obj_set_pos(obj, LV_PCT(10), LV_PCT(38));
            lv_obj_set_size(obj, LV_PCT(80), LV_PCT(23));
            lv_label_set_long_mode(obj, LV_LABEL_LONG_CLIP);
            add_style_climate_num(obj);
            lv_obj_set_style_text_align(obj, LV_TEXT_ALIGN_CENTER, LV_PART_MAIN | LV_STATE_DEFAULT);
            lv_label_set_text_static(obj, "72");
        }
        {
            // climate_info_row
            lv_obj_t *obj = lv_obj_create(parent_obj);
            objects.climate_info_row = obj;
            lv_obj_set_pos(obj, LV_PCT(15), LV_PCT(62));
            lv_obj_set_size(obj, LV_PCT(70), LV_PCT(8));
            add_style_plain(obj);
            lv_obj_set_style_layout(obj, LV_LAYOUT_FLEX, LV_PART_MAIN | LV_STATE_DEFAULT);
            lv_obj_set_style_flex_flow(obj, LV_FLEX_FLOW_ROW, LV_PART_MAIN | LV_STATE_DEFAULT);
            lv_obj_set_style_flex_main_place(obj, LV_FLEX_ALIGN_CENTER, LV_PART_MAIN | LV_STATE_DEFAULT);
            lv_obj_set_style_flex_cross_place(obj, LV_FLEX_ALIGN_CENTER, LV_PART_MAIN | LV_STATE_DEFAULT);
            lv_obj_set_style_flex_track_place(obj, LV_FLEX_ALIGN_CENTER, LV_PART_MAIN | LV_STATE_DEFAULT);
            lv_obj_set_style_pad_column(obj, 9, LV_PART_MAIN | LV_STATE_DEFAULT);
            {
                lv_obj_t *parent_obj = obj;
                {
                    // climate_inside
                    lv_obj_t *obj = lv_label_create(parent_obj);
                    objects.climate_inside = obj;
                    lv_obj_set_pos(obj, LV_PCT(0), LV_PCT(0));
                    lv_obj_set_size(obj, LV_SIZE_CONTENT, LV_SIZE_CONTENT);
                    lv_label_set_long_mode(obj, LV_LABEL_LONG_DOT);
                    add_style_label_body(obj);
                    lv_label_set_text(obj, "Inside 67°");
                }
                {
                    // climate_eta_group
                    lv_obj_t *obj = lv_obj_create(parent_obj);
                    objects.climate_eta_group = obj;
                    lv_obj_set_pos(obj, LV_PCT(0), LV_PCT(0));
                    lv_obj_set_size(obj, LV_SIZE_CONTENT, LV_SIZE_CONTENT);
                    add_style_plain(obj);
                    lv_obj_set_style_layout(obj, LV_LAYOUT_FLEX, LV_PART_MAIN | LV_STATE_DEFAULT);
                    lv_obj_set_style_flex_flow(obj, LV_FLEX_FLOW_ROW, LV_PART_MAIN | LV_STATE_DEFAULT);
                    lv_obj_set_style_flex_main_place(obj, LV_FLEX_ALIGN_CENTER, LV_PART_MAIN | LV_STATE_DEFAULT);
                    lv_obj_set_style_flex_cross_place(obj, LV_FLEX_ALIGN_CENTER, LV_PART_MAIN | LV_STATE_DEFAULT);
                    lv_obj_set_style_pad_column(obj, 2, LV_PART_MAIN | LV_STATE_DEFAULT);
                    {
                        lv_obj_t *parent_obj = obj;
                        {
                            // climate_eta_icon
                            lv_obj_t *obj = lv_label_create(parent_obj);
                            objects.climate_eta_icon = obj;
                            lv_obj_set_pos(obj, LV_PCT(0), LV_PCT(0));
                            lv_obj_set_size(obj, LV_SIZE_CONTENT, LV_SIZE_CONTENT);
                            lv_label_set_long_mode(obj, LV_LABEL_LONG_CLIP);
                            add_style_label_icon_sm(obj);
                            lv_label_set_text_static(obj, "");
                        }
                        {
                            // climate_eta
                            lv_obj_t *obj = lv_label_create(parent_obj);
                            objects.climate_eta = obj;
                            lv_obj_set_pos(obj, LV_PCT(0), LV_PCT(0));
                            lv_obj_set_size(obj, LV_SIZE_CONTENT, LV_SIZE_CONTENT);
                            lv_label_set_long_mode(obj, LV_LABEL_LONG_DOT);
                            add_style_label_body(obj);
                            lv_label_set_text(obj, "28 min");
                        }
                    }
                }
            }
        }
    }
    
    tick_screen_page_climate();
}

void tick_screen_page_climate() {
    screen_page_climate_state_t *state = &screen_page_climate_state;
    (void)state;
    {
        int32_t new_min_val = get_var_climate_heat_min();
        int32_t new_max_val = get_var_climate_heat_max();
        lv_scale_section_set_range(state->scale_section, new_min_val, new_max_val);
    }
    {
        int32_t new_min_val = get_var_climate_cool_min();
        int32_t new_max_val = get_var_climate_cool_max();
        lv_scale_section_set_range(state->scale_section1, new_min_val, new_max_val);
    }
    {
        int32_t new_min_val = get_var_climate_hold_min();
        int32_t new_max_val = get_var_climate_hold_max();
        lv_scale_section_set_range(state->scale_section2, new_min_val, new_max_val);
    }
}

void create_screen_page_climate_mode() {
    lv_obj_t *obj = lv_obj_create(0);
    objects.page_climate_mode = obj;
    lv_obj_set_pos(obj, 0, 0);
    lv_obj_set_size(obj, 240, 240);
    add_style_screen_root(obj);
    {
        lv_obj_t *parent_obj = obj;
        {
            // cmode_title
            lv_obj_t *obj = lv_label_create(parent_obj);
            objects.cmode_title = obj;
            lv_obj_set_pos(obj, LV_PCT(20), LV_PCT(18));
            lv_obj_set_size(obj, LV_PCT(60), LV_PCT(8));
            lv_label_set_long_mode(obj, LV_LABEL_LONG_DOT);
            add_style_label_eyebrow(obj);
            lv_obj_set_style_text_align(obj, LV_TEXT_ALIGN_CENTER, LV_PART_MAIN | LV_STATE_DEFAULT);
            lv_label_set_text(obj, "MODE");
        }
        {
            // cmode_list
            lv_obj_t *obj = lv_obj_create(parent_obj);
            objects.cmode_list = obj;
            lv_obj_set_pos(obj, LV_PCT(25), LV_PCT(25));
            lv_obj_set_size(obj, LV_PCT(50), LV_PCT(56));
            add_style_plain(obj);
            {
                lv_obj_t *parent_obj = obj;
                {
                    // cmode_item0
                    lv_obj_t *obj = lv_obj_create(parent_obj);
                    objects.cmode_item0 = obj;
                    lv_obj_set_pos(obj, LV_PCT(0), LV_PCT(0));
                    lv_obj_set_size(obj, LV_PCT(100), LV_PCT(22));
                    add_style_mode_row_heat(obj);
                    {
                        lv_obj_t *parent_obj = obj;
                        {
                            // cmode_item0_icon
                            lv_obj_t *obj = lv_label_create(parent_obj);
                            objects.cmode_item0_icon = obj;
                            lv_obj_set_pos(obj, LV_PCT(8), LV_PCT(0));
                            lv_obj_set_size(obj, LV_PCT(10), LV_SIZE_CONTENT);
                            lv_label_set_long_mode(obj, LV_LABEL_LONG_CLIP);
                            add_style_mode_row_icon(obj);
                            lv_obj_set_style_align(obj, LV_ALIGN_LEFT_MID, LV_PART_MAIN | LV_STATE_DEFAULT);
                            lv_obj_set_style_text_align(obj, LV_TEXT_ALIGN_CENTER, LV_PART_MAIN | LV_STATE_DEFAULT);
                            lv_label_set_text_static(obj, "");
                        }
                        {
                            // cmode_item0_title
                            lv_obj_t *obj = lv_label_create(parent_obj);
                            objects.cmode_item0_title = obj;
                            lv_obj_set_pos(obj, LV_PCT(24), LV_PCT(0));
                            lv_obj_set_size(obj, LV_PCT(68), LV_SIZE_CONTENT);
                            lv_label_set_long_mode(obj, LV_LABEL_LONG_DOT);
                            add_style_mode_row_text(obj);
                            lv_obj_set_style_align(obj, LV_ALIGN_LEFT_MID, LV_PART_MAIN | LV_STATE_DEFAULT);
                            lv_obj_set_style_text_align(obj, LV_TEXT_ALIGN_LEFT, LV_PART_MAIN | LV_STATE_DEFAULT);
                            lv_label_set_text(obj, "Heat");
                        }
                    }
                }
                {
                    // cmode_item1
                    lv_obj_t *obj = lv_obj_create(parent_obj);
                    objects.cmode_item1 = obj;
                    lv_obj_set_pos(obj, LV_PCT(0), LV_PCT(26));
                    lv_obj_set_size(obj, LV_PCT(100), LV_PCT(22));
                    add_style_mode_row_cool(obj);
                    {
                        lv_obj_t *parent_obj = obj;
                        {
                            // cmode_item1_icon
                            lv_obj_t *obj = lv_label_create(parent_obj);
                            objects.cmode_item1_icon = obj;
                            lv_obj_set_pos(obj, LV_PCT(8), LV_PCT(0));
                            lv_obj_set_size(obj, LV_PCT(10), LV_SIZE_CONTENT);
                            lv_label_set_long_mode(obj, LV_LABEL_LONG_CLIP);
                            add_style_mode_row_icon(obj);
                            lv_obj_set_style_align(obj, LV_ALIGN_LEFT_MID, LV_PART_MAIN | LV_STATE_DEFAULT);
                            lv_obj_set_style_text_align(obj, LV_TEXT_ALIGN_CENTER, LV_PART_MAIN | LV_STATE_DEFAULT);
                            lv_label_set_text_static(obj, "");
                        }
                        {
                            // cmode_item1_title
                            lv_obj_t *obj = lv_label_create(parent_obj);
                            objects.cmode_item1_title = obj;
                            lv_obj_set_pos(obj, LV_PCT(24), LV_PCT(0));
                            lv_obj_set_size(obj, LV_PCT(68), LV_SIZE_CONTENT);
                            lv_label_set_long_mode(obj, LV_LABEL_LONG_DOT);
                            add_style_mode_row_text(obj);
                            lv_obj_set_style_align(obj, LV_ALIGN_LEFT_MID, LV_PART_MAIN | LV_STATE_DEFAULT);
                            lv_obj_set_style_text_align(obj, LV_TEXT_ALIGN_LEFT, LV_PART_MAIN | LV_STATE_DEFAULT);
                            lv_label_set_text(obj, "Cool");
                        }
                    }
                }
                {
                    // cmode_item2
                    lv_obj_t *obj = lv_obj_create(parent_obj);
                    objects.cmode_item2 = obj;
                    lv_obj_set_pos(obj, LV_PCT(0), LV_PCT(52));
                    lv_obj_set_size(obj, LV_PCT(100), LV_PCT(22));
                    add_style_mode_row_auto(obj);
                    {
                        lv_obj_t *parent_obj = obj;
                        {
                            // cmode_item2_icon
                            lv_obj_t *obj = lv_label_create(parent_obj);
                            objects.cmode_item2_icon = obj;
                            lv_obj_set_pos(obj, LV_PCT(8), LV_PCT(0));
                            lv_obj_set_size(obj, LV_PCT(10), LV_SIZE_CONTENT);
                            lv_label_set_long_mode(obj, LV_LABEL_LONG_CLIP);
                            add_style_mode_row_icon(obj);
                            lv_obj_set_style_align(obj, LV_ALIGN_LEFT_MID, LV_PART_MAIN | LV_STATE_DEFAULT);
                            lv_obj_set_style_text_align(obj, LV_TEXT_ALIGN_CENTER, LV_PART_MAIN | LV_STATE_DEFAULT);
                            lv_label_set_text_static(obj, "");
                        }
                        {
                            // cmode_item2_title
                            lv_obj_t *obj = lv_label_create(parent_obj);
                            objects.cmode_item2_title = obj;
                            lv_obj_set_pos(obj, LV_PCT(24), LV_PCT(0));
                            lv_obj_set_size(obj, LV_PCT(68), LV_SIZE_CONTENT);
                            lv_label_set_long_mode(obj, LV_LABEL_LONG_DOT);
                            add_style_mode_row_text(obj);
                            lv_obj_set_style_align(obj, LV_ALIGN_LEFT_MID, LV_PART_MAIN | LV_STATE_DEFAULT);
                            lv_obj_set_style_text_align(obj, LV_TEXT_ALIGN_LEFT, LV_PART_MAIN | LV_STATE_DEFAULT);
                            lv_label_set_text(obj, "Auto");
                        }
                    }
                }
                {
                    // cmode_item3
                    lv_obj_t *obj = lv_obj_create(parent_obj);
                    objects.cmode_item3 = obj;
                    lv_obj_set_pos(obj, LV_PCT(0), LV_PCT(78));
                    lv_obj_set_size(obj, LV_PCT(100), LV_PCT(22));
                    add_style_mode_row_off(obj);
                    {
                        lv_obj_t *parent_obj = obj;
                        {
                            // cmode_item3_icon
                            lv_obj_t *obj = lv_label_create(parent_obj);
                            objects.cmode_item3_icon = obj;
                            lv_obj_set_pos(obj, LV_PCT(8), LV_PCT(0));
                            lv_obj_set_size(obj, LV_PCT(10), LV_SIZE_CONTENT);
                            lv_label_set_long_mode(obj, LV_LABEL_LONG_CLIP);
                            add_style_mode_row_icon(obj);
                            lv_obj_set_style_align(obj, LV_ALIGN_LEFT_MID, LV_PART_MAIN | LV_STATE_DEFAULT);
                            lv_obj_set_style_text_align(obj, LV_TEXT_ALIGN_CENTER, LV_PART_MAIN | LV_STATE_DEFAULT);
                            lv_label_set_text_static(obj, "");
                        }
                        {
                            // cmode_item3_title
                            lv_obj_t *obj = lv_label_create(parent_obj);
                            objects.cmode_item3_title = obj;
                            lv_obj_set_pos(obj, LV_PCT(24), LV_PCT(0));
                            lv_obj_set_size(obj, LV_PCT(68), LV_SIZE_CONTENT);
                            lv_label_set_long_mode(obj, LV_LABEL_LONG_DOT);
                            add_style_mode_row_text(obj);
                            lv_obj_set_style_align(obj, LV_ALIGN_LEFT_MID, LV_PART_MAIN | LV_STATE_DEFAULT);
                            lv_obj_set_style_text_align(obj, LV_TEXT_ALIGN_LEFT, LV_PART_MAIN | LV_STATE_DEFAULT);
                            lv_label_set_text(obj, "Off");
                        }
                    }
                }
            }
        }
    }
    
    tick_screen_page_climate_mode();
}

void tick_screen_page_climate_mode() {
}

void create_screen_page_devices() {
    lv_obj_t *obj = lv_obj_create(0);
    objects.page_devices = obj;
    lv_obj_set_pos(obj, 0, 0);
    lv_obj_set_size(obj, 240, 240);
    add_style_screen_root(obj);
    {
        lv_obj_t *parent_obj = obj;
        {
            // devices_hero
            lv_obj_t *obj = lv_obj_create(parent_obj);
            objects.devices_hero = obj;
            lv_obj_set_pos(obj, LV_PCT(34), LV_PCT(25));
            lv_obj_set_size(obj, LV_PCT(31), LV_PCT(31));
            add_style_device_tile(obj);
            lv_obj_set_style_radius(obj, 1000, LV_PART_MAIN | LV_STATE_DEFAULT);
            {
                lv_obj_t *parent_obj = obj;
                {
                    // devices_hero_icon
                    lv_obj_t *obj = lv_label_create(parent_obj);
                    objects.devices_hero_icon = obj;
                    lv_obj_set_pos(obj, LV_PCT(0), LV_PCT(0));
                    lv_obj_set_size(obj, LV_SIZE_CONTENT, LV_SIZE_CONTENT);
                    lv_label_set_long_mode(obj, LV_LABEL_LONG_CLIP);
                    add_style_device_icon(obj);
                    lv_obj_set_style_align(obj, LV_ALIGN_CENTER, LV_PART_MAIN | LV_STATE_DEFAULT);
                    lv_label_set_text_static(obj, "");
                }
            }
        }
        {
            // devices_prev
            lv_obj_t *obj = lv_obj_create(parent_obj);
            objects.devices_prev = obj;
            lv_obj_set_pos(obj, LV_PCT(5), LV_PCT(42));
            lv_obj_set_size(obj, LV_PCT(14), LV_PCT(14));
            add_style_plain(obj);
            {
                lv_obj_t *parent_obj = obj;
                {
                    // devices_prev_icon
                    lv_obj_t *obj = lv_label_create(parent_obj);
                    objects.devices_prev_icon = obj;
                    lv_obj_set_pos(obj, LV_PCT(0), LV_PCT(0));
                    lv_obj_set_size(obj, LV_SIZE_CONTENT, LV_SIZE_CONTENT);
                    lv_label_set_long_mode(obj, LV_LABEL_LONG_CLIP);
                    add_style_device_neighbour_icon(obj);
                    lv_obj_set_style_align(obj, LV_ALIGN_CENTER, LV_PART_MAIN | LV_STATE_DEFAULT);
                    lv_label_set_text_static(obj, "");
                }
            }
        }
        {
            // devices_next
            lv_obj_t *obj = lv_obj_create(parent_obj);
            objects.devices_next = obj;
            lv_obj_set_pos(obj, LV_PCT(81), LV_PCT(42));
            lv_obj_set_size(obj, LV_PCT(14), LV_PCT(14));
            add_style_plain(obj);
            {
                lv_obj_t *parent_obj = obj;
                {
                    // devices_next_icon
                    lv_obj_t *obj = lv_label_create(parent_obj);
                    objects.devices_next_icon = obj;
                    lv_obj_set_pos(obj, LV_PCT(0), LV_PCT(0));
                    lv_obj_set_size(obj, LV_SIZE_CONTENT, LV_SIZE_CONTENT);
                    lv_label_set_long_mode(obj, LV_LABEL_LONG_CLIP);
                    add_style_device_neighbour_icon(obj);
                    lv_obj_set_style_align(obj, LV_ALIGN_CENTER, LV_PART_MAIN | LV_STATE_DEFAULT);
                    lv_label_set_text_static(obj, "");
                }
            }
        }
        {
            // devices_name
            lv_obj_t *obj = lv_label_create(parent_obj);
            objects.devices_name = obj;
            lv_obj_set_pos(obj, LV_PCT(22), LV_PCT(60));
            lv_obj_set_size(obj, LV_PCT(56), LV_SIZE_CONTENT);
            lv_label_set_long_mode(obj, LV_LABEL_LONG_DOT);
            add_style_label_title(obj);
            lv_obj_set_style_text_align(obj, LV_TEXT_ALIGN_CENTER, LV_PART_MAIN | LV_STATE_DEFAULT);
            lv_label_set_text(obj, "Kitchen");
        }
        {
            // devices_value
            lv_obj_t *obj = lv_label_create(parent_obj);
            objects.devices_value = obj;
            lv_obj_set_pos(obj, LV_PCT(22), LV_PCT(70));
            lv_obj_set_size(obj, LV_PCT(56), LV_SIZE_CONTENT);
            lv_label_set_long_mode(obj, LV_LABEL_LONG_DOT);
            add_style_label_body(obj);
            lv_obj_set_style_text_align(obj, LV_TEXT_ALIGN_CENTER, LV_PART_MAIN | LV_STATE_DEFAULT);
            lv_label_set_text(obj, "On");
        }
        {
            // devices_dot0
            lv_obj_t *obj = lv_obj_create(parent_obj);
            objects.devices_dot0 = obj;
            lv_obj_set_pos(obj, 156, 217);
            lv_obj_set_size(obj, 5, 5);
            add_style_dot(obj);
            lv_obj_set_style_radius(obj, 1000, LV_PART_MAIN | LV_STATE_DEFAULT);
        }
        {
            // devices_dot1
            lv_obj_t *obj = lv_obj_create(parent_obj);
            objects.devices_dot1 = obj;
            lv_obj_set_pos(obj, 151, 219);
            lv_obj_set_size(obj, 5, 5);
            lv_obj_add_flag(obj, LV_OBJ_FLAG_HIDDEN);
            add_style_dot(obj);
            lv_obj_set_style_radius(obj, 1000, LV_PART_MAIN | LV_STATE_DEFAULT);
        }
        {
            // devices_dot2
            lv_obj_t *obj = lv_obj_create(parent_obj);
            objects.devices_dot2 = obj;
            lv_obj_set_pos(obj, 145, 221);
            lv_obj_set_size(obj, 5, 5);
            add_style_dot(obj);
            lv_obj_set_style_radius(obj, 1000, LV_PART_MAIN | LV_STATE_DEFAULT);
        }
        {
            // devices_dot3
            lv_obj_t *obj = lv_obj_create(parent_obj);
            objects.devices_dot3 = obj;
            lv_obj_set_pos(obj, 140, 222);
            lv_obj_set_size(obj, 5, 5);
            lv_obj_add_flag(obj, LV_OBJ_FLAG_HIDDEN);
            add_style_dot(obj);
            lv_obj_set_style_radius(obj, 1000, LV_PART_MAIN | LV_STATE_DEFAULT);
        }
        {
            // devices_dot4
            lv_obj_t *obj = lv_obj_create(parent_obj);
            objects.devices_dot4 = obj;
            lv_obj_set_pos(obj, 134, 223);
            lv_obj_set_size(obj, 5, 5);
            add_style_dot(obj);
            lv_obj_set_style_radius(obj, 1000, LV_PART_MAIN | LV_STATE_DEFAULT);
        }
        {
            // devices_dot5
            lv_obj_t *obj = lv_obj_create(parent_obj);
            objects.devices_dot5 = obj;
            lv_obj_set_pos(obj, 129, 224);
            lv_obj_set_size(obj, 5, 5);
            lv_obj_add_flag(obj, LV_OBJ_FLAG_HIDDEN);
            add_style_dot(obj);
            lv_obj_set_style_radius(obj, 1000, LV_PART_MAIN | LV_STATE_DEFAULT);
        }
        {
            // devices_dot6
            lv_obj_t *obj = lv_obj_create(parent_obj);
            objects.devices_dot6 = obj;
            lv_obj_set_pos(obj, 123, 224);
            lv_obj_set_size(obj, 5, 5);
            add_style_dot(obj);
            lv_obj_set_style_radius(obj, 1000, LV_PART_MAIN | LV_STATE_DEFAULT);
        }
        {
            // devices_dot7
            lv_obj_t *obj = lv_obj_create(parent_obj);
            objects.devices_dot7 = obj;
            lv_obj_set_pos(obj, 118, 225);
            lv_obj_set_size(obj, 5, 5);
            lv_obj_add_flag(obj, LV_OBJ_FLAG_HIDDEN);
            add_style_dot(obj);
            lv_obj_set_style_radius(obj, 1000, LV_PART_MAIN | LV_STATE_DEFAULT);
        }
        {
            // devices_dot8
            lv_obj_t *obj = lv_obj_create(parent_obj);
            objects.devices_dot8 = obj;
            lv_obj_set_pos(obj, 112, 224);
            lv_obj_set_size(obj, 5, 5);
            add_style_dot(obj);
            lv_obj_set_style_radius(obj, 1000, LV_PART_MAIN | LV_STATE_DEFAULT);
        }
        {
            // devices_dot9
            lv_obj_t *obj = lv_obj_create(parent_obj);
            objects.devices_dot9 = obj;
            lv_obj_set_pos(obj, 106, 224);
            lv_obj_set_size(obj, 5, 5);
            lv_obj_add_flag(obj, LV_OBJ_FLAG_HIDDEN);
            add_style_dot(obj);
            lv_obj_set_style_radius(obj, 1000, LV_PART_MAIN | LV_STATE_DEFAULT);
        }
        {
            // devices_dot10
            lv_obj_t *obj = lv_obj_create(parent_obj);
            objects.devices_dot10 = obj;
            lv_obj_set_pos(obj, 101, 223);
            lv_obj_set_size(obj, 5, 5);
            add_style_dot(obj);
            lv_obj_set_style_radius(obj, 1000, LV_PART_MAIN | LV_STATE_DEFAULT);
        }
        {
            // devices_dot11
            lv_obj_t *obj = lv_obj_create(parent_obj);
            objects.devices_dot11 = obj;
            lv_obj_set_pos(obj, 95, 222);
            lv_obj_set_size(obj, 5, 5);
            lv_obj_add_flag(obj, LV_OBJ_FLAG_HIDDEN);
            add_style_dot(obj);
            lv_obj_set_style_radius(obj, 1000, LV_PART_MAIN | LV_STATE_DEFAULT);
        }
        {
            // devices_dot12
            lv_obj_t *obj = lv_obj_create(parent_obj);
            objects.devices_dot12 = obj;
            lv_obj_set_pos(obj, 90, 221);
            lv_obj_set_size(obj, 5, 5);
            add_style_dot(obj);
            lv_obj_set_style_radius(obj, 1000, LV_PART_MAIN | LV_STATE_DEFAULT);
        }
        {
            // devices_dot13
            lv_obj_t *obj = lv_obj_create(parent_obj);
            objects.devices_dot13 = obj;
            lv_obj_set_pos(obj, 84, 219);
            lv_obj_set_size(obj, 5, 5);
            lv_obj_add_flag(obj, LV_OBJ_FLAG_HIDDEN);
            add_style_dot(obj);
            lv_obj_set_style_radius(obj, 1000, LV_PART_MAIN | LV_STATE_DEFAULT);
        }
        {
            // devices_dot14
            lv_obj_t *obj = lv_obj_create(parent_obj);
            objects.devices_dot14 = obj;
            lv_obj_set_pos(obj, 79, 217);
            lv_obj_set_size(obj, 5, 5);
            add_style_dot(obj);
            lv_obj_set_style_radius(obj, 1000, LV_PART_MAIN | LV_STATE_DEFAULT);
        }
    }
    
    tick_screen_page_devices();
}

void tick_screen_page_devices() {
}

void create_screen_page_energy() {
    lv_obj_t *obj = lv_obj_create(0);
    objects.page_energy = obj;
    lv_obj_set_pos(obj, 0, 0);
    lv_obj_set_size(obj, 240, 240);
    add_style_screen_root(obj);
    {
        lv_obj_t *parent_obj = obj;
        {
            // energy_arc
            lv_obj_t *obj = lv_arc_create(parent_obj);
            objects.energy_arc = obj;
            lv_obj_set_pos(obj, LV_PCT(4), LV_PCT(4));
            lv_obj_set_size(obj, LV_PCT(92), LV_PCT(92));
            lv_arc_set_value(obj, 82);
            lv_obj_remove_flag(obj, LV_OBJ_FLAG_CLICKABLE);
            add_style_energy_arc(obj);
        }
        {
            // energy_stack
            lv_obj_t *obj = lv_obj_create(parent_obj);
            objects.energy_stack = obj;
            lv_obj_set_pos(obj, LV_PCT(16), LV_PCT(16));
            lv_obj_set_size(obj, LV_PCT(68), LV_PCT(68));
            add_style_plain(obj);
            lv_obj_set_style_layout(obj, LV_LAYOUT_FLEX, LV_PART_MAIN | LV_STATE_DEFAULT);
            lv_obj_set_style_flex_flow(obj, LV_FLEX_FLOW_COLUMN, LV_PART_MAIN | LV_STATE_DEFAULT);
            lv_obj_set_style_flex_main_place(obj, LV_FLEX_ALIGN_CENTER, LV_PART_MAIN | LV_STATE_DEFAULT);
            lv_obj_set_style_flex_cross_place(obj, LV_FLEX_ALIGN_CENTER, LV_PART_MAIN | LV_STATE_DEFAULT);
            lv_obj_set_style_flex_track_place(obj, LV_FLEX_ALIGN_CENTER, LV_PART_MAIN | LV_STATE_DEFAULT);
            lv_obj_set_style_pad_row(obj, 3, LV_PART_MAIN | LV_STATE_DEFAULT);
            {
                lv_obj_t *parent_obj = obj;
                {
                    // energy_head
                    lv_obj_t *obj = lv_obj_create(parent_obj);
                    objects.energy_head = obj;
                    lv_obj_set_pos(obj, LV_PCT(0), LV_PCT(0));
                    lv_obj_set_size(obj, LV_SIZE_CONTENT, LV_SIZE_CONTENT);
                    add_style_plain(obj);
                    lv_obj_set_style_layout(obj, LV_LAYOUT_FLEX, LV_PART_MAIN | LV_STATE_DEFAULT);
                    lv_obj_set_style_flex_flow(obj, LV_FLEX_FLOW_ROW, LV_PART_MAIN | LV_STATE_DEFAULT);
                    lv_obj_set_style_flex_main_place(obj, LV_FLEX_ALIGN_CENTER, LV_PART_MAIN | LV_STATE_DEFAULT);
                    lv_obj_set_style_flex_cross_place(obj, LV_FLEX_ALIGN_CENTER, LV_PART_MAIN | LV_STATE_DEFAULT);
                    lv_obj_set_style_flex_track_place(obj, LV_FLEX_ALIGN_CENTER, LV_PART_MAIN | LV_STATE_DEFAULT);
                    lv_obj_set_style_pad_column(obj, 4, LV_PART_MAIN | LV_STATE_DEFAULT);
                    lv_obj_set_style_pad_row(obj, 4, LV_PART_MAIN | LV_STATE_DEFAULT);
                    {
                        lv_obj_t *parent_obj = obj;
                        {
                            // energy_head_icon
                            lv_obj_t *obj = lv_label_create(parent_obj);
                            objects.energy_head_icon = obj;
                            lv_obj_set_pos(obj, LV_PCT(0), LV_PCT(0));
                            lv_obj_set_size(obj, LV_SIZE_CONTENT, LV_SIZE_CONTENT);
                            lv_label_set_long_mode(obj, LV_LABEL_LONG_CLIP);
                            add_style_energy_head_icon(obj);
                            lv_label_set_text_static(obj, "");
                        }
                        {
                            // energy_title
                            lv_obj_t *obj = lv_label_create(parent_obj);
                            objects.energy_title = obj;
                            lv_obj_set_pos(obj, LV_PCT(0), LV_PCT(0));
                            lv_obj_set_size(obj, LV_SIZE_CONTENT, LV_SIZE_CONTENT);
                            lv_label_set_long_mode(obj, LV_LABEL_LONG_DOT);
                            add_style_energy_head(obj);
                            lv_label_set_text(obj, "BATTERY");
                        }
                    }
                }
                {
                    // energy_value_row
                    lv_obj_t *obj = lv_obj_create(parent_obj);
                    objects.energy_value_row = obj;
                    lv_obj_set_pos(obj, LV_PCT(0), LV_PCT(0));
                    lv_obj_set_size(obj, LV_SIZE_CONTENT, LV_SIZE_CONTENT);
                    add_style_plain(obj);
                    lv_obj_set_style_layout(obj, LV_LAYOUT_FLEX, LV_PART_MAIN | LV_STATE_DEFAULT);
                    lv_obj_set_style_flex_flow(obj, LV_FLEX_FLOW_ROW, LV_PART_MAIN | LV_STATE_DEFAULT);
                    lv_obj_set_style_flex_main_place(obj, LV_FLEX_ALIGN_CENTER, LV_PART_MAIN | LV_STATE_DEFAULT);
                    lv_obj_set_style_flex_cross_place(obj, LV_FLEX_ALIGN_END, LV_PART_MAIN | LV_STATE_DEFAULT);
                    lv_obj_set_style_flex_track_place(obj, LV_FLEX_ALIGN_CENTER, LV_PART_MAIN | LV_STATE_DEFAULT);
                    lv_obj_set_style_pad_column(obj, 2, LV_PART_MAIN | LV_STATE_DEFAULT);
                    lv_obj_set_style_pad_row(obj, 2, LV_PART_MAIN | LV_STATE_DEFAULT);
                    {
                        lv_obj_t *parent_obj = obj;
                        {
                            // energy_value
                            lv_obj_t *obj = lv_label_create(parent_obj);
                            objects.energy_value = obj;
                            lv_obj_set_pos(obj, LV_PCT(0), LV_PCT(0));
                            lv_obj_set_size(obj, LV_SIZE_CONTENT, LV_SIZE_CONTENT);
                            lv_label_set_long_mode(obj, LV_LABEL_LONG_DOT);
                            add_style_label_hero_xl(obj);
                            lv_label_set_text(obj, "82");
                        }
                        {
                            // energy_unit
                            lv_obj_t *obj = lv_label_create(parent_obj);
                            objects.energy_unit = obj;
                            lv_obj_set_pos(obj, LV_PCT(0), LV_PCT(0));
                            lv_obj_set_size(obj, LV_SIZE_CONTENT, LV_SIZE_CONTENT);
                            lv_label_set_long_mode(obj, LV_LABEL_LONG_DOT);
                            add_style_energy_unit(obj);
                            lv_label_set_text(obj, "%");
                        }
                    }
                }
                {
                    // energy_sub1
                    lv_obj_t *obj = lv_label_create(parent_obj);
                    objects.energy_sub1 = obj;
                    lv_obj_set_pos(obj, LV_PCT(0), LV_PCT(0));
                    lv_obj_set_size(obj, LV_SIZE_CONTENT, LV_SIZE_CONTENT);
                    lv_label_set_long_mode(obj, LV_LABEL_LONG_DOT);
                    add_style_label_body(obj);
                    lv_label_set_text(obj, "13.4 V · Float");
                }
                {
                    // energy_sub2
                    lv_obj_t *obj = lv_label_create(parent_obj);
                    objects.energy_sub2 = obj;
                    lv_obj_set_pos(obj, LV_PCT(0), LV_PCT(0));
                    lv_obj_set_size(obj, LV_SIZE_CONTENT, LV_SIZE_CONTENT);
                    lv_label_set_long_mode(obj, LV_LABEL_LONG_DOT);
                    add_style_label_body_muted(obj);
                    lv_label_set_text(obj, "Time Remaining 14h 20m");
                }
            }
        }
        {
            // energy_dot0
            lv_obj_t *obj = lv_obj_create(parent_obj);
            objects.energy_dot0 = obj;
            lv_obj_set_pos(obj, 108, 217);
            lv_obj_set_size(obj, 4, 4);
            add_style_energy_dot(obj);
            lv_obj_set_style_radius(obj, 1000, LV_PART_MAIN | LV_STATE_DEFAULT);
        }
        {
            // energy_dot1
            lv_obj_t *obj = lv_obj_create(parent_obj);
            objects.energy_dot1 = obj;
            lv_obj_set_pos(obj, 118, 218);
            lv_obj_set_size(obj, 4, 4);
            add_style_energy_dot(obj);
            lv_obj_set_style_radius(obj, 1000, LV_PART_MAIN | LV_STATE_DEFAULT);
        }
        {
            // energy_dot2
            lv_obj_t *obj = lv_obj_create(parent_obj);
            objects.energy_dot2 = obj;
            lv_obj_set_pos(obj, 128, 217);
            lv_obj_set_size(obj, 4, 4);
            add_style_energy_dot(obj);
            lv_obj_set_style_radius(obj, 1000, LV_PART_MAIN | LV_STATE_DEFAULT);
        }
    }
    
    tick_screen_page_energy();
}

void tick_screen_page_energy() {
}

void create_screen_page_water() {
    lv_obj_t *obj = lv_obj_create(0);
    objects.page_water = obj;
    lv_obj_set_pos(obj, 0, 0);
    lv_obj_set_size(obj, 240, 240);
    add_style_screen_root(obj);
    {
        lv_obj_t *parent_obj = obj;
        {
            // water_title
            lv_obj_t *obj = lv_label_create(parent_obj);
            objects.water_title = obj;
            lv_obj_set_pos(obj, LV_PCT(20), LV_PCT(15));
            lv_obj_set_size(obj, LV_PCT(60), LV_PCT(8));
            lv_label_set_long_mode(obj, LV_LABEL_LONG_DOT);
            add_style_label_eyebrow(obj);
            lv_obj_set_style_text_align(obj, LV_TEXT_ALIGN_CENTER, LV_PART_MAIN | LV_STATE_DEFAULT);
            lv_label_set_text(obj, "WATER TANKS");
        }
        {
            // water_fresh_value
            lv_obj_t *obj = lv_label_create(parent_obj);
            objects.water_fresh_value = obj;
            lv_obj_set_pos(obj, LV_PCT(17), LV_PCT(25));
            lv_obj_set_size(obj, LV_PCT(22), LV_PCT(8));
            lv_label_set_long_mode(obj, LV_LABEL_LONG_DOT);
            add_style_label_title(obj);
            lv_obj_set_style_text_align(obj, LV_TEXT_ALIGN_CENTER, LV_PART_MAIN | LV_STATE_DEFAULT);
            lv_label_set_text(obj, "--");
        }
        {
            // water_fresh_bar
            lv_obj_t *obj = lv_bar_create(parent_obj);
            objects.water_fresh_bar = obj;
            lv_obj_set_pos(obj, LV_PCT(21), LV_PCT(34));
            lv_obj_set_size(obj, LV_PCT(13), LV_PCT(35));
            add_style_bar_fresh(obj);
        }
        {
            // water_fresh_label
            lv_obj_t *obj = lv_label_create(parent_obj);
            objects.water_fresh_label = obj;
            lv_obj_set_pos(obj, LV_PCT(17), LV_PCT(72));
            lv_obj_set_size(obj, LV_PCT(22), LV_PCT(8));
            lv_label_set_long_mode(obj, LV_LABEL_LONG_DOT);
            add_style_label_body(obj);
            lv_obj_set_style_text_align(obj, LV_TEXT_ALIGN_CENTER, LV_PART_MAIN | LV_STATE_DEFAULT);
            lv_label_set_text(obj, "Fresh");
        }
        {
            // water_grey_value
            lv_obj_t *obj = lv_label_create(parent_obj);
            objects.water_grey_value = obj;
            lv_obj_set_pos(obj, LV_PCT(39), LV_PCT(25));
            lv_obj_set_size(obj, LV_PCT(22), LV_PCT(8));
            lv_label_set_long_mode(obj, LV_LABEL_LONG_DOT);
            add_style_label_title(obj);
            lv_obj_set_style_text_align(obj, LV_TEXT_ALIGN_CENTER, LV_PART_MAIN | LV_STATE_DEFAULT);
            lv_label_set_text(obj, "--");
        }
        {
            // water_grey_bar
            lv_obj_t *obj = lv_bar_create(parent_obj);
            objects.water_grey_bar = obj;
            lv_obj_set_pos(obj, LV_PCT(43), LV_PCT(34));
            lv_obj_set_size(obj, LV_PCT(13), LV_PCT(35));
            add_style_bar_grey(obj);
        }
        {
            // water_grey_label
            lv_obj_t *obj = lv_label_create(parent_obj);
            objects.water_grey_label = obj;
            lv_obj_set_pos(obj, LV_PCT(39), LV_PCT(72));
            lv_obj_set_size(obj, LV_PCT(22), LV_PCT(8));
            lv_label_set_long_mode(obj, LV_LABEL_LONG_DOT);
            add_style_label_body(obj);
            lv_obj_set_style_text_align(obj, LV_TEXT_ALIGN_CENTER, LV_PART_MAIN | LV_STATE_DEFAULT);
            lv_label_set_text(obj, "Grey");
        }
        {
            // water_black_value
            lv_obj_t *obj = lv_label_create(parent_obj);
            objects.water_black_value = obj;
            lv_obj_set_pos(obj, LV_PCT(62), LV_PCT(25));
            lv_obj_set_size(obj, LV_PCT(22), LV_PCT(8));
            lv_label_set_long_mode(obj, LV_LABEL_LONG_DOT);
            add_style_label_title(obj);
            lv_obj_set_style_text_align(obj, LV_TEXT_ALIGN_CENTER, LV_PART_MAIN | LV_STATE_DEFAULT);
            lv_label_set_text(obj, "--");
        }
        {
            // water_black_bar
            lv_obj_t *obj = lv_bar_create(parent_obj);
            objects.water_black_bar = obj;
            lv_obj_set_pos(obj, LV_PCT(66), LV_PCT(34));
            lv_obj_set_size(obj, LV_PCT(13), LV_PCT(35));
            add_style_bar_black(obj);
        }
        {
            // water_black_label
            lv_obj_t *obj = lv_label_create(parent_obj);
            objects.water_black_label = obj;
            lv_obj_set_pos(obj, LV_PCT(62), LV_PCT(72));
            lv_obj_set_size(obj, LV_PCT(22), LV_PCT(8));
            lv_label_set_long_mode(obj, LV_LABEL_LONG_DOT);
            add_style_label_body(obj);
            lv_obj_set_style_text_align(obj, LV_TEXT_ALIGN_CENTER, LV_PART_MAIN | LV_STATE_DEFAULT);
            lv_label_set_text(obj, "Black");
        }
    }
    
    tick_screen_page_water();
}

void tick_screen_page_water() {
}

void create_screen_page_air() {
    lv_obj_t *obj = lv_obj_create(0);
    objects.page_air = obj;
    lv_obj_set_pos(obj, 0, 0);
    lv_obj_set_size(obj, 240, 240);
    add_style_screen_root(obj);
    {
        lv_obj_t *parent_obj = obj;
        {
            // air_arc
            lv_obj_t *obj = lv_arc_create(parent_obj);
            objects.air_arc = obj;
            lv_obj_set_pos(obj, LV_PCT(4), LV_PCT(4));
            lv_obj_set_size(obj, LV_PCT(92), LV_PCT(92));
            lv_arc_set_range(obj, 400, 2000);
            lv_arc_set_value(obj, 640);
            lv_obj_remove_flag(obj, LV_OBJ_FLAG_CLICKABLE);
            add_style_arc_thin(obj);
        }
        {
            // air_title
            lv_obj_t *obj = lv_label_create(parent_obj);
            objects.air_title = obj;
            lv_obj_set_pos(obj, LV_PCT(25), LV_PCT(17));
            lv_obj_set_size(obj, LV_PCT(50), LV_PCT(8));
            lv_label_set_long_mode(obj, LV_LABEL_LONG_DOT);
            add_style_label_eyebrow(obj);
            lv_obj_set_style_text_align(obj, LV_TEXT_ALIGN_CENTER, LV_PART_MAIN | LV_STATE_DEFAULT);
            lv_label_set_text(obj, "AIR QUALITY");
        }
        {
            // air_value
            lv_obj_t *obj = lv_label_create(parent_obj);
            objects.air_value = obj;
            lv_obj_set_pos(obj, LV_PCT(15), LV_PCT(26));
            lv_obj_set_size(obj, LV_PCT(70), LV_PCT(19));
            lv_label_set_long_mode(obj, LV_LABEL_LONG_CLIP);
            add_style_label_hero_xl(obj);
            lv_obj_set_style_text_align(obj, LV_TEXT_ALIGN_CENTER, LV_PART_MAIN | LV_STATE_DEFAULT);
            lv_label_set_text_static(obj, "640");
        }
        {
            // air_unit
            lv_obj_t *obj = lv_label_create(parent_obj);
            objects.air_unit = obj;
            lv_obj_set_pos(obj, LV_PCT(40), LV_PCT(49));
            lv_obj_set_size(obj, LV_PCT(20), LV_PCT(6));
            lv_label_set_long_mode(obj, LV_LABEL_LONG_DOT);
            add_style_label_muted(obj);
            lv_obj_set_style_text_align(obj, LV_TEXT_ALIGN_CENTER, LV_PART_MAIN | LV_STATE_DEFAULT);
            lv_label_set_text(obj, "ppm");
        }
        {
            // air_status
            lv_obj_t *obj = lv_label_create(parent_obj);
            objects.air_status = obj;
            lv_obj_set_pos(obj, LV_PCT(20), LV_PCT(57));
            lv_obj_set_size(obj, LV_PCT(60), LV_PCT(8));
            lv_label_set_long_mode(obj, LV_LABEL_LONG_DOT);
            add_style_label_status(obj);
            lv_obj_set_style_text_align(obj, LV_TEXT_ALIGN_CENTER, LV_PART_MAIN | LV_STATE_DEFAULT);
            lv_label_set_text(obj, "Good");
        }
        {
            // air_metrics
            lv_obj_t *obj = lv_obj_create(parent_obj);
            objects.air_metrics = obj;
            lv_obj_set_pos(obj, LV_PCT(18), LV_PCT(69));
            lv_obj_set_size(obj, LV_PCT(64), LV_PCT(14));
            add_style_plain(obj);
            {
                lv_obj_t *parent_obj = obj;
                {
                    // air_voc_col
                    lv_obj_t *obj = lv_obj_create(parent_obj);
                    objects.air_voc_col = obj;
                    lv_obj_set_pos(obj, LV_PCT(0), LV_PCT(0));
                    lv_obj_set_size(obj, LV_PCT(33), LV_PCT(100));
                    add_style_plain(obj);
                    {
                        lv_obj_t *parent_obj = obj;
                        {
                            // air_voc_label
                            lv_obj_t *obj = lv_label_create(parent_obj);
                            objects.air_voc_label = obj;
                            lv_obj_set_pos(obj, LV_PCT(0), LV_PCT(0));
                            lv_obj_set_size(obj, LV_PCT(100), LV_PCT(45));
                            lv_label_set_long_mode(obj, LV_LABEL_LONG_CLIP);
                            add_style_label_muted(obj);
                            lv_obj_set_style_text_align(obj, LV_TEXT_ALIGN_CENTER, LV_PART_MAIN | LV_STATE_DEFAULT);
                            lv_label_set_text_static(obj, "VOC");
                        }
                        {
                            // air_voc
                            lv_obj_t *obj = lv_label_create(parent_obj);
                            objects.air_voc = obj;
                            lv_obj_set_pos(obj, LV_PCT(0), LV_PCT(45));
                            lv_obj_set_size(obj, LV_PCT(100), LV_PCT(55));
                            lv_label_set_long_mode(obj, LV_LABEL_LONG_CLIP);
                            add_style_label_metric(obj);
                            lv_obj_set_style_text_align(obj, LV_TEXT_ALIGN_CENTER, LV_PART_MAIN | LV_STATE_DEFAULT);
                            lv_label_set_text_static(obj, "120 ppb");
                        }
                    }
                }
                {
                    // air_humidity_col
                    lv_obj_t *obj = lv_obj_create(parent_obj);
                    objects.air_humidity_col = obj;
                    lv_obj_set_pos(obj, LV_PCT(33), LV_PCT(0));
                    lv_obj_set_size(obj, LV_PCT(33), LV_PCT(100));
                    add_style_plain(obj);
                    {
                        lv_obj_t *parent_obj = obj;
                        {
                            // air_humidity_label
                            lv_obj_t *obj = lv_label_create(parent_obj);
                            objects.air_humidity_label = obj;
                            lv_obj_set_pos(obj, LV_PCT(0), LV_PCT(0));
                            lv_obj_set_size(obj, LV_PCT(100), LV_PCT(45));
                            lv_label_set_long_mode(obj, LV_LABEL_LONG_CLIP);
                            add_style_label_muted(obj);
                            lv_obj_set_style_text_align(obj, LV_TEXT_ALIGN_CENTER, LV_PART_MAIN | LV_STATE_DEFAULT);
                            lv_label_set_text_static(obj, "Humidity");
                        }
                        {
                            // air_humidity
                            lv_obj_t *obj = lv_label_create(parent_obj);
                            objects.air_humidity = obj;
                            lv_obj_set_pos(obj, LV_PCT(0), LV_PCT(45));
                            lv_obj_set_size(obj, LV_PCT(100), LV_PCT(55));
                            lv_label_set_long_mode(obj, LV_LABEL_LONG_CLIP);
                            add_style_label_metric(obj);
                            lv_obj_set_style_text_align(obj, LV_TEXT_ALIGN_CENTER, LV_PART_MAIN | LV_STATE_DEFAULT);
                            lv_label_set_text_static(obj, "44%");
                        }
                    }
                }
                {
                    // air_temp_col
                    lv_obj_t *obj = lv_obj_create(parent_obj);
                    objects.air_temp_col = obj;
                    lv_obj_set_pos(obj, LV_PCT(67), LV_PCT(0));
                    lv_obj_set_size(obj, LV_PCT(33), LV_PCT(100));
                    add_style_plain(obj);
                    {
                        lv_obj_t *parent_obj = obj;
                        {
                            // air_temp_label
                            lv_obj_t *obj = lv_label_create(parent_obj);
                            objects.air_temp_label = obj;
                            lv_obj_set_pos(obj, LV_PCT(0), LV_PCT(0));
                            lv_obj_set_size(obj, LV_PCT(100), LV_PCT(45));
                            lv_label_set_long_mode(obj, LV_LABEL_LONG_CLIP);
                            add_style_label_muted(obj);
                            lv_obj_set_style_text_align(obj, LV_TEXT_ALIGN_CENTER, LV_PART_MAIN | LV_STATE_DEFAULT);
                            lv_label_set_text_static(obj, "Temp");
                        }
                        {
                            // air_temp
                            lv_obj_t *obj = lv_label_create(parent_obj);
                            objects.air_temp = obj;
                            lv_obj_set_pos(obj, LV_PCT(0), LV_PCT(45));
                            lv_obj_set_size(obj, LV_PCT(100), LV_PCT(55));
                            lv_label_set_long_mode(obj, LV_LABEL_LONG_CLIP);
                            add_style_label_metric(obj);
                            lv_obj_set_style_text_align(obj, LV_TEXT_ALIGN_CENTER, LV_PART_MAIN | LV_STATE_DEFAULT);
                            lv_label_set_text_static(obj, "70°F");
                        }
                    }
                }
            }
        }
    }
    
    tick_screen_page_air();
}

void tick_screen_page_air() {
}

void create_screen_page_level() {
    lv_obj_t *obj = lv_obj_create(0);
    objects.page_level = obj;
    lv_obj_set_pos(obj, 0, 0);
    lv_obj_set_size(obj, 240, 240);
    add_style_screen_root(obj);
    {
        lv_obj_t *parent_obj = obj;
        {
            // level_title
            lv_obj_t *obj = lv_label_create(parent_obj);
            objects.level_title = obj;
            lv_obj_set_pos(obj, LV_PCT(20), LV_PCT(13));
            lv_obj_set_size(obj, LV_PCT(60), LV_PCT(8));
            lv_label_set_long_mode(obj, LV_LABEL_LONG_DOT);
            add_style_label_eyebrow(obj);
            lv_obj_set_style_text_align(obj, LV_TEXT_ALIGN_CENTER, LV_PART_MAIN | LV_STATE_DEFAULT);
            lv_label_set_text(obj, "LEVELING");
        }
        {
            // level_well
            lv_obj_t *obj = lv_obj_create(parent_obj);
            objects.level_well = obj;
            lv_obj_set_pos(obj, LV_PCT(27), LV_PCT(23));
            lv_obj_set_size(obj, LV_PCT(46), LV_PCT(46));
            add_style_level_well(obj);
            {
                lv_obj_t *parent_obj = obj;
                {
                    // level_cross_v
                    lv_obj_t *obj = lv_line_create(parent_obj);
                    objects.level_cross_v = obj;
                    lv_obj_set_pos(obj, LV_PCT(0), LV_PCT(0));
                    lv_obj_set_size(obj, LV_PCT(100), LV_PCT(100));
                    static lv_point_precise_t line_points[] = {
                        { 53, 0 },
                        { 53, 106 }
                    };
                    lv_line_set_points(obj, line_points, 2);
                    add_style_level_line(obj);
                }
                {
                    // level_cross_h
                    lv_obj_t *obj = lv_line_create(parent_obj);
                    objects.level_cross_h = obj;
                    lv_obj_set_pos(obj, LV_PCT(0), LV_PCT(0));
                    lv_obj_set_size(obj, LV_PCT(100), LV_PCT(100));
                    static lv_point_precise_t line_points[] = {
                        { 0, 53 },
                        { 106, 53 }
                    };
                    lv_line_set_points(obj, line_points, 2);
                    add_style_level_line(obj);
                }
                {
                    // level_ring
                    lv_obj_t *obj = lv_obj_create(parent_obj);
                    objects.level_ring = obj;
                    lv_obj_set_pos(obj, 38, 38);
                    lv_obj_set_size(obj, 30, 30);
                    add_style_level_ring(obj);
                }
                {
                    // level_bubble
                    lv_obj_t *obj = lv_obj_create(parent_obj);
                    objects.level_bubble = obj;
                    lv_obj_set_pos(obj, 42, 42);
                    lv_obj_set_size(obj, 22, 22);
                    add_style_level_bubble(obj);
                }
            }
        }
        {
            // level_status
            lv_obj_t *obj = lv_label_create(parent_obj);
            objects.level_status = obj;
            lv_obj_set_pos(obj, LV_PCT(18), LV_PCT(71));
            lv_obj_set_size(obj, LV_PCT(64), LV_PCT(8));
            lv_label_set_long_mode(obj, LV_LABEL_LONG_DOT);
            add_style_label_status(obj);
            lv_obj_set_style_text_align(obj, LV_TEXT_ALIGN_CENTER, LV_PART_MAIN | LV_STATE_DEFAULT);
            lv_label_set_text(obj, "--");
        }
        {
            // level_detail
            lv_obj_t *obj = lv_label_create(parent_obj);
            objects.level_detail = obj;
            lv_obj_set_pos(obj, LV_PCT(18), LV_PCT(79));
            lv_obj_set_size(obj, LV_PCT(64), LV_PCT(8));
            lv_label_set_long_mode(obj, LV_LABEL_LONG_DOT);
            add_style_label_body(obj);
            lv_obj_set_style_text_align(obj, LV_TEXT_ALIGN_CENTER, LV_PART_MAIN | LV_STATE_DEFAULT);
            lv_label_set_text(obj, "--");
        }
    }
    
    tick_screen_page_level();
}

void tick_screen_page_level() {
}
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
