trailcurrentoss/TrailCurrentCapstan/main/ui/240/styles.c

#include "styles.h"
#include "images.h"
#include "fonts.h"

#include "ui.h"
#include "screens.h"

//
// Style: ScreenRoot
//

void init_style_screen_root_MAIN_DEFAULT(lv_style_t *style) {
    lv_style_set_bg_color(style, lv_color_hex(theme_colors[active_theme_index][1]));
    lv_style_set_bg_opa(style, 255);
    lv_style_set_border_width(style, 0);
    lv_style_set_text_color(style, lv_color_hex(theme_colors[active_theme_index][6]));
    lv_style_set_text_font(style, &ui_font_rr13);
};

lv_style_t *get_style_screen_root_MAIN_DEFAULT() {
    static lv_style_t *style;
    if (!style) {
        style = (lv_style_t *)lv_malloc(sizeof(lv_style_t));
        lv_style_init(style);
        init_style_screen_root_MAIN_DEFAULT(style);
    }
    return style;
};

void add_style_screen_root(lv_obj_t *obj) {
    (void)obj;
    lv_obj_add_style(obj, get_style_screen_root_MAIN_DEFAULT(), LV_PART_MAIN | LV_STATE_DEFAULT);
};

void remove_style_screen_root(lv_obj_t *obj) {
    (void)obj;
    lv_obj_remove_style(obj, get_style_screen_root_MAIN_DEFAULT(), LV_PART_MAIN | LV_STATE_DEFAULT);
};

//
// Style: Card
//

void init_style_card_MAIN_DEFAULT(lv_style_t *style) {
    lv_style_set_bg_color(style, lv_color_hex(theme_colors[active_theme_index][2]));
    lv_style_set_bg_opa(style, 255);
    lv_style_set_border_color(style, lv_color_hex(theme_colors[active_theme_index][5]));
    lv_style_set_border_width(style, 1);
    lv_style_set_border_opa(style, 255);
    lv_style_set_radius(style, 12);
    lv_style_set_pad_top(style, 0);
    lv_style_set_pad_bottom(style, 0);
    lv_style_set_pad_left(style, 0);
    lv_style_set_pad_right(style, 0);
    lv_style_set_text_color(style, lv_color_hex(theme_colors[active_theme_index][6]));
};

lv_style_t *get_style_card_MAIN_DEFAULT() {
    static lv_style_t *style;
    if (!style) {
        style = (lv_style_t *)lv_malloc(sizeof(lv_style_t));
        lv_style_init(style);
        init_style_card_MAIN_DEFAULT(style);
    }
    return style;
};

void init_style_card_MAIN_CHECKED(lv_style_t *style) {
    lv_style_set_bg_color(style, lv_color_hex(theme_colors[active_theme_index][10]));
    lv_style_set_bg_opa(style, 255);
    lv_style_set_border_color(style, lv_color_hex(theme_colors[active_theme_index][9]));
    lv_style_set_border_width(style, 3);
    lv_style_set_border_opa(style, 255);
    lv_style_set_radius(style, 12);
    lv_style_set_pad_top(style, 0);
    lv_style_set_pad_bottom(style, 0);
    lv_style_set_pad_left(style, 0);
    lv_style_set_pad_right(style, 0);
    lv_style_set_text_color(style, lv_color_hex(theme_colors[active_theme_index][6]));
};

lv_style_t *get_style_card_MAIN_CHECKED() {
    static lv_style_t *style;
    if (!style) {
        style = (lv_style_t *)lv_malloc(sizeof(lv_style_t));
        lv_style_init(style);
        init_style_card_MAIN_CHECKED(style);
    }
    return style;
};

void add_style_card(lv_obj_t *obj) {
    (void)obj;
    lv_obj_add_style(obj, get_style_card_MAIN_DEFAULT(), LV_PART_MAIN | LV_STATE_DEFAULT);
    lv_obj_add_style(obj, get_style_card_MAIN_CHECKED(), LV_PART_MAIN | LV_STATE_CHECKED);
};

void remove_style_card(lv_obj_t *obj) {
    (void)obj;
    lv_obj_remove_style(obj, get_style_card_MAIN_DEFAULT(), LV_PART_MAIN | LV_STATE_DEFAULT);
    lv_obj_remove_style(obj, get_style_card_MAIN_CHECKED(), LV_PART_MAIN | LV_STATE_CHECKED);
};

//
// Style: CardSelected
//

void init_style_card_selected_MAIN_DEFAULT(lv_style_t *style) {
    lv_style_set_bg_color(style, lv_color_hex(theme_colors[active_theme_index][10]));
    lv_style_set_bg_opa(style, 255);
    lv_style_set_border_color(style, lv_color_hex(theme_colors[active_theme_index][9]));
    lv_style_set_border_width(style, 2);
    lv_style_set_border_opa(style, 255);
    lv_style_set_radius(style, 12);
    lv_style_set_pad_top(style, 0);
    lv_style_set_pad_bottom(style, 0);
    lv_style_set_pad_left(style, 0);
    lv_style_set_pad_right(style, 0);
    lv_style_set_text_color(style, lv_color_hex(theme_colors[active_theme_index][6]));
};

lv_style_t *get_style_card_selected_MAIN_DEFAULT() {
    static lv_style_t *style;
    if (!style) {
        style = (lv_style_t *)lv_malloc(sizeof(lv_style_t));
        lv_style_init(style);
        init_style_card_selected_MAIN_DEFAULT(style);
    }
    return style;
};

void add_style_card_selected(lv_obj_t *obj) {
    (void)obj;
    lv_obj_add_style(obj, get_style_card_selected_MAIN_DEFAULT(), LV_PART_MAIN | LV_STATE_DEFAULT);
};

void remove_style_card_selected(lv_obj_t *obj) {
    (void)obj;
    lv_obj_remove_style(obj, get_style_card_selected_MAIN_DEFAULT(), LV_PART_MAIN | LV_STATE_DEFAULT);
};

//
// Style: LabelTitle
//

void init_style_label_title_MAIN_DEFAULT(lv_style_t *style) {
    lv_style_set_text_color(style, lv_color_hex(theme_colors[active_theme_index][6]));
    lv_style_set_text_font(style, &ui_font_rm15);
};

lv_style_t *get_style_label_title_MAIN_DEFAULT() {
    static lv_style_t *style;
    if (!style) {
        style = (lv_style_t *)lv_malloc(sizeof(lv_style_t));
        lv_style_init(style);
        init_style_label_title_MAIN_DEFAULT(style);
    }
    return style;
};

void add_style_label_title(lv_obj_t *obj) {
    (void)obj;
    lv_obj_add_style(obj, get_style_label_title_MAIN_DEFAULT(), LV_PART_MAIN | LV_STATE_DEFAULT);
};

void remove_style_label_title(lv_obj_t *obj) {
    (void)obj;
    lv_obj_remove_style(obj, get_style_label_title_MAIN_DEFAULT(), LV_PART_MAIN | LV_STATE_DEFAULT);
};

//
// Style: LabelBody
//

void init_style_label_body_MAIN_DEFAULT(lv_style_t *style) {
    lv_style_set_text_color(style, lv_color_hex(theme_colors[active_theme_index][7]));
    lv_style_set_text_font(style, &ui_font_rr13);
};

lv_style_t *get_style_label_body_MAIN_DEFAULT() {
    static lv_style_t *style;
    if (!style) {
        style = (lv_style_t *)lv_malloc(sizeof(lv_style_t));
        lv_style_init(style);
        init_style_label_body_MAIN_DEFAULT(style);
    }
    return style;
};

void add_style_label_body(lv_obj_t *obj) {
    (void)obj;
    lv_obj_add_style(obj, get_style_label_body_MAIN_DEFAULT(), LV_PART_MAIN | LV_STATE_DEFAULT);
};

void remove_style_label_body(lv_obj_t *obj) {
    (void)obj;
    lv_obj_remove_style(obj, get_style_label_body_MAIN_DEFAULT(), LV_PART_MAIN | LV_STATE_DEFAULT);
};

//
// Style: LabelMuted
//

void init_style_label_muted_MAIN_DEFAULT(lv_style_t *style) {
    lv_style_set_text_color(style, lv_color_hex(theme_colors[active_theme_index][8]));
    lv_style_set_text_font(style, &ui_font_rr11);
};

lv_style_t *get_style_label_muted_MAIN_DEFAULT() {
    static lv_style_t *style;
    if (!style) {
        style = (lv_style_t *)lv_malloc(sizeof(lv_style_t));
        lv_style_init(style);
        init_style_label_muted_MAIN_DEFAULT(style);
    }
    return style;
};

void add_style_label_muted(lv_obj_t *obj) {
    (void)obj;
    lv_obj_add_style(obj, get_style_label_muted_MAIN_DEFAULT(), LV_PART_MAIN | LV_STATE_DEFAULT);
};

void remove_style_label_muted(lv_obj_t *obj) {
    (void)obj;
    lv_obj_remove_style(obj, get_style_label_muted_MAIN_DEFAULT(), LV_PART_MAIN | LV_STATE_DEFAULT);
};

//
// Style: LabelHero
//

void init_style_label_hero_MAIN_DEFAULT(lv_style_t *style) {
    lv_style_set_text_color(style, lv_color_hex(theme_colors[active_theme_index][6]));
    lv_style_set_text_font(style, &ui_font_rl40);
};

lv_style_t *get_style_label_hero_MAIN_DEFAULT() {
    static lv_style_t *style;
    if (!style) {
        style = (lv_style_t *)lv_malloc(sizeof(lv_style_t));
        lv_style_init(style);
        init_style_label_hero_MAIN_DEFAULT(style);
    }
    return style;
};

void add_style_label_hero(lv_obj_t *obj) {
    (void)obj;
    lv_obj_add_style(obj, get_style_label_hero_MAIN_DEFAULT(), LV_PART_MAIN | LV_STATE_DEFAULT);
};

void remove_style_label_hero(lv_obj_t *obj) {
    (void)obj;
    lv_obj_remove_style(obj, get_style_label_hero_MAIN_DEFAULT(), LV_PART_MAIN | LV_STATE_DEFAULT);
};

//
// Style: ButtonPrimary
//

void init_style_button_primary_MAIN_DEFAULT(lv_style_t *style) {
    lv_style_set_bg_color(style, lv_color_hex(theme_colors[active_theme_index][9]));
    lv_style_set_bg_opa(style, 255);
    lv_style_set_radius(style, 8);
    lv_style_set_border_width(style, 0);
    lv_style_set_pad_top(style, 0);
    lv_style_set_pad_bottom(style, 0);
    lv_style_set_pad_left(style, 0);
    lv_style_set_pad_right(style, 0);
    lv_style_set_text_color(style, lv_color_hex(theme_colors[active_theme_index][27]));
    lv_style_set_text_font(style, &ui_font_rr13);
};

lv_style_t *get_style_button_primary_MAIN_DEFAULT() {
    static lv_style_t *style;
    if (!style) {
        style = (lv_style_t *)lv_malloc(sizeof(lv_style_t));
        lv_style_init(style);
        init_style_button_primary_MAIN_DEFAULT(style);
    }
    return style;
};

void add_style_button_primary(lv_obj_t *obj) {
    (void)obj;
    lv_obj_add_style(obj, get_style_button_primary_MAIN_DEFAULT(), LV_PART_MAIN | LV_STATE_DEFAULT);
};

void remove_style_button_primary(lv_obj_t *obj) {
    (void)obj;
    lv_obj_remove_style(obj, get_style_button_primary_MAIN_DEFAULT(), LV_PART_MAIN | LV_STATE_DEFAULT);
};

//
// Style: ButtonNeutral
//

void init_style_button_neutral_MAIN_DEFAULT(lv_style_t *style) {
    lv_style_set_bg_color(style, lv_color_hex(theme_colors[active_theme_index][2]));
    lv_style_set_bg_opa(style, 255);
    lv_style_set_border_color(style, lv_color_hex(theme_colors[active_theme_index][5]));
    lv_style_set_border_width(style, 1);
    lv_style_set_border_opa(style, 255);
    lv_style_set_radius(style, 8);
    lv_style_set_pad_top(style, 0);
    lv_style_set_pad_bottom(style, 0);
    lv_style_set_pad_left(style, 0);
    lv_style_set_pad_right(style, 0);
    lv_style_set_text_color(style, lv_color_hex(theme_colors[active_theme_index][6]));
    lv_style_set_text_font(style, &ui_font_rr13);
};

lv_style_t *get_style_button_neutral_MAIN_DEFAULT() {
    static lv_style_t *style;
    if (!style) {
        style = (lv_style_t *)lv_malloc(sizeof(lv_style_t));
        lv_style_init(style);
        init_style_button_neutral_MAIN_DEFAULT(style);
    }
    return style;
};

void add_style_button_neutral(lv_obj_t *obj) {
    (void)obj;
    lv_obj_add_style(obj, get_style_button_neutral_MAIN_DEFAULT(), LV_PART_MAIN | LV_STATE_DEFAULT);
};

void remove_style_button_neutral(lv_obj_t *obj) {
    (void)obj;
    lv_obj_remove_style(obj, get_style_button_neutral_MAIN_DEFAULT(), LV_PART_MAIN | LV_STATE_DEFAULT);
};

//
// Style: ScaleRing
//

void init_style_scale_ring_MAIN_DEFAULT(lv_style_t *style) {
    lv_style_set_line_color(style, lv_color_hex(theme_colors[active_theme_index][25]));
    lv_style_set_line_width(style, 2);
    lv_style_set_line_opa(style, 255);
};

lv_style_t *get_style_scale_ring_MAIN_DEFAULT() {
    static lv_style_t *style;
    if (!style) {
        style = (lv_style_t *)lv_malloc(sizeof(lv_style_t));
        lv_style_init(style);
        init_style_scale_ring_MAIN_DEFAULT(style);
    }
    return style;
};

void init_style_scale_ring_ITEMS_DEFAULT(lv_style_t *style) {
    lv_style_set_line_color(style, lv_color_hex(theme_colors[active_theme_index][25]));
    lv_style_set_line_width(style, 2);
    lv_style_set_line_opa(style, 255);
};

lv_style_t *get_style_scale_ring_ITEMS_DEFAULT() {
    static lv_style_t *style;
    if (!style) {
        style = (lv_style_t *)lv_malloc(sizeof(lv_style_t));
        lv_style_init(style);
        init_style_scale_ring_ITEMS_DEFAULT(style);
    }
    return style;
};

void init_style_scale_ring_INDICATOR_DEFAULT(lv_style_t *style) {
    lv_style_set_line_color(style, lv_color_hex(theme_colors[active_theme_index][16]));
    lv_style_set_line_width(style, 3);
    lv_style_set_line_opa(style, 255);
    lv_style_set_text_color(style, lv_color_hex(theme_colors[active_theme_index][16]));
    lv_style_set_text_font(style, &ui_font_rr11);
};

lv_style_t *get_style_scale_ring_INDICATOR_DEFAULT() {
    static lv_style_t *style;
    if (!style) {
        style = (lv_style_t *)lv_malloc(sizeof(lv_style_t));
        lv_style_init(style);
        init_style_scale_ring_INDICATOR_DEFAULT(style);
    }
    return style;
};

void add_style_scale_ring(lv_obj_t *obj) {
    (void)obj;
    lv_obj_add_style(obj, get_style_scale_ring_MAIN_DEFAULT(), LV_PART_MAIN | LV_STATE_DEFAULT);
    lv_obj_add_style(obj, get_style_scale_ring_ITEMS_DEFAULT(), LV_PART_ITEMS | LV_STATE_DEFAULT);
    lv_obj_add_style(obj, get_style_scale_ring_INDICATOR_DEFAULT(), LV_PART_INDICATOR | LV_STATE_DEFAULT);
};

void remove_style_scale_ring(lv_obj_t *obj) {
    (void)obj;
    lv_obj_remove_style(obj, get_style_scale_ring_MAIN_DEFAULT(), LV_PART_MAIN | LV_STATE_DEFAULT);
    lv_obj_remove_style(obj, get_style_scale_ring_ITEMS_DEFAULT(), LV_PART_ITEMS | LV_STATE_DEFAULT);
    lv_obj_remove_style(obj, get_style_scale_ring_INDICATOR_DEFAULT(), LV_PART_INDICATOR | LV_STATE_DEFAULT);
};

//
// Style: LabelIcon
//

void init_style_label_icon_MAIN_DEFAULT(lv_style_t *style) {
    lv_style_set_text_color(style, lv_color_hex(theme_colors[active_theme_index][6]));
    lv_style_set_text_font(style, &ui_font_fa16);
    lv_style_set_text_align(style, LV_TEXT_ALIGN_CENTER);
};

lv_style_t *get_style_label_icon_MAIN_DEFAULT() {
    static lv_style_t *style;
    if (!style) {
        style = (lv_style_t *)lv_malloc(sizeof(lv_style_t));
        lv_style_init(style);
        init_style_label_icon_MAIN_DEFAULT(style);
    }
    return style;
};

void add_style_label_icon(lv_obj_t *obj) {
    (void)obj;
    lv_obj_add_style(obj, get_style_label_icon_MAIN_DEFAULT(), LV_PART_MAIN | LV_STATE_DEFAULT);
};

void remove_style_label_icon(lv_obj_t *obj) {
    (void)obj;
    lv_obj_remove_style(obj, get_style_label_icon_MAIN_DEFAULT(), LV_PART_MAIN | LV_STATE_DEFAULT);
};

//
// Style: LabelIconSm
//

void init_style_label_icon_sm_MAIN_DEFAULT(lv_style_t *style) {
    lv_style_set_text_color(style, lv_color_hex(theme_colors[active_theme_index][7]));
    lv_style_set_text_font(style, &ui_font_fa13);
    lv_style_set_text_align(style, LV_TEXT_ALIGN_CENTER);
};

lv_style_t *get_style_label_icon_sm_MAIN_DEFAULT() {
    static lv_style_t *style;
    if (!style) {
        style = (lv_style_t *)lv_malloc(sizeof(lv_style_t));
        lv_style_init(style);
        init_style_label_icon_sm_MAIN_DEFAULT(style);
    }
    return style;
};

void add_style_label_icon_sm(lv_obj_t *obj) {
    (void)obj;
    lv_obj_add_style(obj, get_style_label_icon_sm_MAIN_DEFAULT(), LV_PART_MAIN | LV_STATE_DEFAULT);
};

void remove_style_label_icon_sm(lv_obj_t *obj) {
    (void)obj;
    lv_obj_remove_style(obj, get_style_label_icon_sm_MAIN_DEFAULT(), LV_PART_MAIN | LV_STATE_DEFAULT);
};

//
// Style: HeroTile
//

void init_style_hero_tile_MAIN_DEFAULT(lv_style_t *style) {
    lv_style_set_bg_color(style, lv_color_hex(theme_colors[active_theme_index][2]));
    lv_style_set_bg_opa(style, 255);
    lv_style_set_border_color(style, lv_color_hex(theme_colors[active_theme_index][9]));
    lv_style_set_border_width(style, 2);
    lv_style_set_border_opa(style, 255);
    lv_style_set_shadow_color(style, lv_color_hex(theme_colors[active_theme_index][9]));
    lv_style_set_shadow_opa(style, 128);
    lv_style_set_shadow_width(style, 10);
    lv_style_set_shadow_spread(style, 0);
    lv_style_set_radius(style, 1000);
    lv_style_set_pad_top(style, 0);
    lv_style_set_pad_bottom(style, 0);
    lv_style_set_pad_left(style, 0);
    lv_style_set_pad_right(style, 0);
};

lv_style_t *get_style_hero_tile_MAIN_DEFAULT() {
    static lv_style_t *style;
    if (!style) {
        style = (lv_style_t *)lv_malloc(sizeof(lv_style_t));
        lv_style_init(style);
        init_style_hero_tile_MAIN_DEFAULT(style);
    }
    return style;
};

void add_style_hero_tile(lv_obj_t *obj) {
    (void)obj;
    lv_obj_add_style(obj, get_style_hero_tile_MAIN_DEFAULT(), LV_PART_MAIN | LV_STATE_DEFAULT);
};

void remove_style_hero_tile(lv_obj_t *obj) {
    (void)obj;
    lv_obj_remove_style(obj, get_style_hero_tile_MAIN_DEFAULT(), LV_PART_MAIN | LV_STATE_DEFAULT);
};

//
// Style: HeroIcon
//

void init_style_hero_icon_MAIN_DEFAULT(lv_style_t *style) {
    lv_style_set_text_color(style, lv_color_hex(theme_colors[active_theme_index][9]));
    lv_style_set_text_font(style, &ui_font_fh34);
    lv_style_set_text_align(style, LV_TEXT_ALIGN_CENTER);
};

lv_style_t *get_style_hero_icon_MAIN_DEFAULT() {
    static lv_style_t *style;
    if (!style) {
        style = (lv_style_t *)lv_malloc(sizeof(lv_style_t));
        lv_style_init(style);
        init_style_hero_icon_MAIN_DEFAULT(style);
    }
    return style;
};

void add_style_hero_icon(lv_obj_t *obj) {
    (void)obj;
    lv_obj_add_style(obj, get_style_hero_icon_MAIN_DEFAULT(), LV_PART_MAIN | LV_STATE_DEFAULT);
};

void remove_style_hero_icon(lv_obj_t *obj) {
    (void)obj;
    lv_obj_remove_style(obj, get_style_hero_icon_MAIN_DEFAULT(), LV_PART_MAIN | LV_STATE_DEFAULT);
};

//
// Style: NeighbourIcon
//

void init_style_neighbour_icon_MAIN_DEFAULT(lv_style_t *style) {
    lv_style_set_text_color(style, lv_color_hex(theme_colors[active_theme_index][8]));
    lv_style_set_text_font(style, &ui_font_fh22);
    lv_style_set_text_align(style, LV_TEXT_ALIGN_CENTER);
};

lv_style_t *get_style_neighbour_icon_MAIN_DEFAULT() {
    static lv_style_t *style;
    if (!style) {
        style = (lv_style_t *)lv_malloc(sizeof(lv_style_t));
        lv_style_init(style);
        init_style_neighbour_icon_MAIN_DEFAULT(style);
    }
    return style;
};

void add_style_neighbour_icon(lv_obj_t *obj) {
    (void)obj;
    lv_obj_add_style(obj, get_style_neighbour_icon_MAIN_DEFAULT(), LV_PART_MAIN | LV_STATE_DEFAULT);
};

void remove_style_neighbour_icon(lv_obj_t *obj) {
    (void)obj;
    lv_obj_remove_style(obj, get_style_neighbour_icon_MAIN_DEFAULT(), LV_PART_MAIN | LV_STATE_DEFAULT);
};

//
// Style: DeviceTile
//

void init_style_device_tile_MAIN_DEFAULT(lv_style_t *style) {
    lv_style_set_bg_color(style, lv_color_hex(theme_colors[active_theme_index][2]));
    lv_style_set_bg_opa(style, 255);
    lv_style_set_border_color(style, lv_color_hex(theme_colors[active_theme_index][5]));
    lv_style_set_border_width(style, 2);
    lv_style_set_border_opa(style, 255);
    lv_style_set_shadow_opa(style, 0);
    lv_style_set_radius(style, 1000);
    lv_style_set_pad_top(style, 0);
    lv_style_set_pad_bottom(style, 0);
    lv_style_set_pad_left(style, 0);
    lv_style_set_pad_right(style, 0);
};

lv_style_t *get_style_device_tile_MAIN_DEFAULT() {
    static lv_style_t *style;
    if (!style) {
        style = (lv_style_t *)lv_malloc(sizeof(lv_style_t));
        lv_style_init(style);
        init_style_device_tile_MAIN_DEFAULT(style);
    }
    return style;
};

void init_style_device_tile_MAIN_CHECKED(lv_style_t *style) {
    lv_style_set_bg_color(style, lv_color_hex(theme_colors[active_theme_index][10]));
    lv_style_set_bg_opa(style, 255);
    lv_style_set_border_color(style, lv_color_hex(theme_colors[active_theme_index][9]));
    lv_style_set_border_width(style, 2);
    lv_style_set_border_opa(style, 255);
    lv_style_set_shadow_color(style, lv_color_hex(theme_colors[active_theme_index][9]));
    lv_style_set_shadow_opa(style, 128);
    lv_style_set_shadow_width(style, 10);
    lv_style_set_shadow_spread(style, 0);
    lv_style_set_radius(style, 1000);
    lv_style_set_pad_top(style, 0);
    lv_style_set_pad_bottom(style, 0);
    lv_style_set_pad_left(style, 0);
    lv_style_set_pad_right(style, 0);
};

lv_style_t *get_style_device_tile_MAIN_CHECKED() {
    static lv_style_t *style;
    if (!style) {
        style = (lv_style_t *)lv_malloc(sizeof(lv_style_t));
        lv_style_init(style);
        init_style_device_tile_MAIN_CHECKED(style);
    }
    return style;
};

void add_style_device_tile(lv_obj_t *obj) {
    (void)obj;
    lv_obj_add_style(obj, get_style_device_tile_MAIN_DEFAULT(), LV_PART_MAIN | LV_STATE_DEFAULT);
    lv_obj_add_style(obj, get_style_device_tile_MAIN_CHECKED(), LV_PART_MAIN | LV_STATE_CHECKED);
};

void remove_style_device_tile(lv_obj_t *obj) {
    (void)obj;
    lv_obj_remove_style(obj, get_style_device_tile_MAIN_DEFAULT(), LV_PART_MAIN | LV_STATE_DEFAULT);
    lv_obj_remove_style(obj, get_style_device_tile_MAIN_CHECKED(), LV_PART_MAIN | LV_STATE_CHECKED);
};

//
// Style: DeviceIcon
//

void init_style_device_icon_MAIN_DEFAULT(lv_style_t *style) {
    lv_style_set_text_color(style, lv_color_hex(theme_colors[active_theme_index][8]));
    lv_style_set_text_font(style, &ui_font_fa30);
    lv_style_set_text_align(style, LV_TEXT_ALIGN_CENTER);
};

lv_style_t *get_style_device_icon_MAIN_DEFAULT() {
    static lv_style_t *style;
    if (!style) {
        style = (lv_style_t *)lv_malloc(sizeof(lv_style_t));
        lv_style_init(style);
        init_style_device_icon_MAIN_DEFAULT(style);
    }
    return style;
};

void init_style_device_icon_MAIN_CHECKED(lv_style_t *style) {
    lv_style_set_text_color(style, lv_color_hex(theme_colors[active_theme_index][9]));
    lv_style_set_text_font(style, &ui_font_fa30);
    lv_style_set_text_align(style, LV_TEXT_ALIGN_CENTER);
};

lv_style_t *get_style_device_icon_MAIN_CHECKED() {
    static lv_style_t *style;
    if (!style) {
        style = (lv_style_t *)lv_malloc(sizeof(lv_style_t));
        lv_style_init(style);
        init_style_device_icon_MAIN_CHECKED(style);
    }
    return style;
};

void add_style_device_icon(lv_obj_t *obj) {
    (void)obj;
    lv_obj_add_style(obj, get_style_device_icon_MAIN_DEFAULT(), LV_PART_MAIN | LV_STATE_DEFAULT);
    lv_obj_add_style(obj, get_style_device_icon_MAIN_CHECKED(), LV_PART_MAIN | LV_STATE_CHECKED);
};

void remove_style_device_icon(lv_obj_t *obj) {
    (void)obj;
    lv_obj_remove_style(obj, get_style_device_icon_MAIN_DEFAULT(), LV_PART_MAIN | LV_STATE_DEFAULT);
    lv_obj_remove_style(obj, get_style_device_icon_MAIN_CHECKED(), LV_PART_MAIN | LV_STATE_CHECKED);
};

//
// Style: DeviceNeighbourIcon
//

void init_style_device_neighbour_icon_MAIN_DEFAULT(lv_style_t *style) {
    lv_style_set_text_color(style, lv_color_hex(theme_colors[active_theme_index][8]));
    lv_style_set_text_font(style, &ui_font_fa20);
    lv_style_set_text_align(style, LV_TEXT_ALIGN_CENTER);
};

lv_style_t *get_style_device_neighbour_icon_MAIN_DEFAULT() {
    static lv_style_t *style;
    if (!style) {
        style = (lv_style_t *)lv_malloc(sizeof(lv_style_t));
        lv_style_init(style);
        init_style_device_neighbour_icon_MAIN_DEFAULT(style);
    }
    return style;
};

void add_style_device_neighbour_icon(lv_obj_t *obj) {
    (void)obj;
    lv_obj_add_style(obj, get_style_device_neighbour_icon_MAIN_DEFAULT(), LV_PART_MAIN | LV_STATE_DEFAULT);
};

void remove_style_device_neighbour_icon(lv_obj_t *obj) {
    (void)obj;
    lv_obj_remove_style(obj, get_style_device_neighbour_icon_MAIN_DEFAULT(), LV_PART_MAIN | LV_STATE_DEFAULT);
};

//
// Style: AlertRing
//

void init_style_alert_ring_MAIN_DEFAULT(lv_style_t *style) {
    lv_style_set_bg_color(style, lv_color_hex(theme_colors[active_theme_index][1]));
    lv_style_set_bg_opa(style, 255);
    lv_style_set_border_color(style, lv_color_hex(theme_colors[active_theme_index][14]));
    lv_style_set_border_width(style, 4);
    lv_style_set_border_opa(style, 255);
    lv_style_set_radius(style, 9999);
    lv_style_set_pad_top(style, 0);
    lv_style_set_pad_bottom(style, 0);
    lv_style_set_pad_left(style, 0);
    lv_style_set_pad_right(style, 0);
    lv_style_set_text_color(style, lv_color_hex(theme_colors[active_theme_index][6]));
};

lv_style_t *get_style_alert_ring_MAIN_DEFAULT() {
    static lv_style_t *style;
    if (!style) {
        style = (lv_style_t *)lv_malloc(sizeof(lv_style_t));
        lv_style_init(style);
        init_style_alert_ring_MAIN_DEFAULT(style);
    }
    return style;
};

void add_style_alert_ring(lv_obj_t *obj) {
    (void)obj;
    lv_obj_add_style(obj, get_style_alert_ring_MAIN_DEFAULT(), LV_PART_MAIN | LV_STATE_DEFAULT);
};

void remove_style_alert_ring(lv_obj_t *obj) {
    (void)obj;
    lv_obj_remove_style(obj, get_style_alert_ring_MAIN_DEFAULT(), LV_PART_MAIN | LV_STATE_DEFAULT);
};

//
// Style: LevelWell
//

void init_style_level_well_MAIN_DEFAULT(lv_style_t *style) {
    lv_style_set_bg_color(style, lv_color_hex(theme_colors[active_theme_index][27]));
    lv_style_set_bg_opa(style, 255);
    lv_style_set_border_color(style, lv_color_hex(theme_colors[active_theme_index][5]));
    lv_style_set_border_width(style, 2);
    lv_style_set_border_opa(style, 255);
    lv_style_set_radius(style, 9999);
    lv_style_set_pad_top(style, 0);
    lv_style_set_pad_bottom(style, 0);
    lv_style_set_pad_left(style, 0);
    lv_style_set_pad_right(style, 0);
};

lv_style_t *get_style_level_well_MAIN_DEFAULT() {
    static lv_style_t *style;
    if (!style) {
        style = (lv_style_t *)lv_malloc(sizeof(lv_style_t));
        lv_style_init(style);
        init_style_level_well_MAIN_DEFAULT(style);
    }
    return style;
};

void add_style_level_well(lv_obj_t *obj) {
    (void)obj;
    lv_obj_add_style(obj, get_style_level_well_MAIN_DEFAULT(), LV_PART_MAIN | LV_STATE_DEFAULT);
};

void remove_style_level_well(lv_obj_t *obj) {
    (void)obj;
    lv_obj_remove_style(obj, get_style_level_well_MAIN_DEFAULT(), LV_PART_MAIN | LV_STATE_DEFAULT);
};

//
// Style: LevelRing
//

void init_style_level_ring_MAIN_DEFAULT(lv_style_t *style) {
    lv_style_set_bg_opa(style, 0);
    lv_style_set_border_color(style, lv_color_hex(theme_colors[active_theme_index][5]));
    lv_style_set_border_width(style, 1);
    lv_style_set_border_opa(style, 255);
    lv_style_set_radius(style, 9999);
    lv_style_set_pad_top(style, 0);
    lv_style_set_pad_bottom(style, 0);
    lv_style_set_pad_left(style, 0);
    lv_style_set_pad_right(style, 0);
};

lv_style_t *get_style_level_ring_MAIN_DEFAULT() {
    static lv_style_t *style;
    if (!style) {
        style = (lv_style_t *)lv_malloc(sizeof(lv_style_t));
        lv_style_init(style);
        init_style_level_ring_MAIN_DEFAULT(style);
    }
    return style;
};

void add_style_level_ring(lv_obj_t *obj) {
    (void)obj;
    lv_obj_add_style(obj, get_style_level_ring_MAIN_DEFAULT(), LV_PART_MAIN | LV_STATE_DEFAULT);
};

void remove_style_level_ring(lv_obj_t *obj) {
    (void)obj;
    lv_obj_remove_style(obj, get_style_level_ring_MAIN_DEFAULT(), LV_PART_MAIN | LV_STATE_DEFAULT);
};

//
// Style: LevelLine
//

void init_style_level_line_MAIN_DEFAULT(lv_style_t *style) {
    lv_style_set_line_color(style, lv_color_hex(theme_colors[active_theme_index][5]));
    lv_style_set_line_width(style, 1);
    lv_style_set_line_opa(style, 255);
};

lv_style_t *get_style_level_line_MAIN_DEFAULT() {
    static lv_style_t *style;
    if (!style) {
        style = (lv_style_t *)lv_malloc(sizeof(lv_style_t));
        lv_style_init(style);
        init_style_level_line_MAIN_DEFAULT(style);
    }
    return style;
};

void add_style_level_line(lv_obj_t *obj) {
    (void)obj;
    lv_obj_add_style(obj, get_style_level_line_MAIN_DEFAULT(), LV_PART_MAIN | LV_STATE_DEFAULT);
};

void remove_style_level_line(lv_obj_t *obj) {
    (void)obj;
    lv_obj_remove_style(obj, get_style_level_line_MAIN_DEFAULT(), LV_PART_MAIN | LV_STATE_DEFAULT);
};

//
// Style: LevelBubble
//

void init_style_level_bubble_MAIN_DEFAULT(lv_style_t *style) {
    lv_style_set_bg_color(style, lv_color_hex(theme_colors[active_theme_index][11]));
    lv_style_set_bg_opa(style, 255);
    lv_style_set_border_width(style, 0);
    lv_style_set_radius(style, 9999);
    lv_style_set_shadow_color(style, lv_color_hex(theme_colors[active_theme_index][11]));
    lv_style_set_shadow_opa(style, 128);
    lv_style_set_shadow_width(style, 10);
    lv_style_set_shadow_spread(style, 0);
    lv_style_set_pad_top(style, 0);
    lv_style_set_pad_bottom(style, 0);
    lv_style_set_pad_left(style, 0);
    lv_style_set_pad_right(style, 0);
};

lv_style_t *get_style_level_bubble_MAIN_DEFAULT() {
    static lv_style_t *style;
    if (!style) {
        style = (lv_style_t *)lv_malloc(sizeof(lv_style_t));
        lv_style_init(style);
        init_style_level_bubble_MAIN_DEFAULT(style);
    }
    return style;
};

void add_style_level_bubble(lv_obj_t *obj) {
    (void)obj;
    lv_obj_add_style(obj, get_style_level_bubble_MAIN_DEFAULT(), LV_PART_MAIN | LV_STATE_DEFAULT);
};

void remove_style_level_bubble(lv_obj_t *obj) {
    (void)obj;
    lv_obj_remove_style(obj, get_style_level_bubble_MAIN_DEFAULT(), LV_PART_MAIN | LV_STATE_DEFAULT);
};

//
// Style: ClimateTicks
//

void init_style_climate_ticks_MAIN_DEFAULT(lv_style_t *style) {
    lv_style_set_arc_width(style, 0);
    lv_style_set_arc_opa(style, 0);
    lv_style_set_line_width(style, 0);
    lv_style_set_line_opa(style, 0);
    lv_style_set_bg_opa(style, 0);
    lv_style_set_border_width(style, 0);
    lv_style_set_pad_top(style, 0);
    lv_style_set_pad_bottom(style, 0);
    lv_style_set_pad_left(style, 0);
    lv_style_set_pad_right(style, 0);
};

lv_style_t *get_style_climate_ticks_MAIN_DEFAULT() {
    static lv_style_t *style;
    if (!style) {
        style = (lv_style_t *)lv_malloc(sizeof(lv_style_t));
        lv_style_init(style);
        init_style_climate_ticks_MAIN_DEFAULT(style);
    }
    return style;
};

void init_style_climate_ticks_INDICATOR_DEFAULT(lv_style_t *style) {
    lv_style_set_line_color(style, lv_color_hex(theme_colors[active_theme_index][5]));
    lv_style_set_line_width(style, 2);
    lv_style_set_line_opa(style, 255);
    lv_style_set_line_rounded(style, true);
    lv_style_set_length(style, 13);
};

lv_style_t *get_style_climate_ticks_INDICATOR_DEFAULT() {
    static lv_style_t *style;
    if (!style) {
        style = (lv_style_t *)lv_malloc(sizeof(lv_style_t));
        lv_style_init(style);
        init_style_climate_ticks_INDICATOR_DEFAULT(style);
    }
    return style;
};

void init_style_climate_ticks_ITEMS_DEFAULT(lv_style_t *style) {
    lv_style_set_line_width(style, 0);
    lv_style_set_line_opa(style, 0);
    lv_style_set_length(style, 0);
};

lv_style_t *get_style_climate_ticks_ITEMS_DEFAULT() {
    static lv_style_t *style;
    if (!style) {
        style = (lv_style_t *)lv_malloc(sizeof(lv_style_t));
        lv_style_init(style);
        init_style_climate_ticks_ITEMS_DEFAULT(style);
    }
    return style;
};

void add_style_climate_ticks(lv_obj_t *obj) {
    (void)obj;
    lv_obj_add_style(obj, get_style_climate_ticks_MAIN_DEFAULT(), LV_PART_MAIN | LV_STATE_DEFAULT);
    lv_obj_add_style(obj, get_style_climate_ticks_INDICATOR_DEFAULT(), LV_PART_INDICATOR | LV_STATE_DEFAULT);
    lv_obj_add_style(obj, get_style_climate_ticks_ITEMS_DEFAULT(), LV_PART_ITEMS | LV_STATE_DEFAULT);
};

void remove_style_climate_ticks(lv_obj_t *obj) {
    (void)obj;
    lv_obj_remove_style(obj, get_style_climate_ticks_MAIN_DEFAULT(), LV_PART_MAIN | LV_STATE_DEFAULT);
    lv_obj_remove_style(obj, get_style_climate_ticks_INDICATOR_DEFAULT(), LV_PART_INDICATOR | LV_STATE_DEFAULT);
    lv_obj_remove_style(obj, get_style_climate_ticks_ITEMS_DEFAULT(), LV_PART_ITEMS | LV_STATE_DEFAULT);
};

//
// Style: ClimateSectionHeat
//

void init_style_climate_section_heat_MAIN_DEFAULT(lv_style_t *style) {
};

lv_style_t *get_style_climate_section_heat_MAIN_DEFAULT() {
    static lv_style_t *style;
    if (!style) {
        style = (lv_style_t *)lv_malloc(sizeof(lv_style_t));
        lv_style_init(style);
        init_style_climate_section_heat_MAIN_DEFAULT(style);
    }
    return style;
};

void init_style_climate_section_heat_INDICATOR_DEFAULT(lv_style_t *style) {
    lv_style_set_line_color(style, lv_color_hex(theme_colors[active_theme_index][14]));
    lv_style_set_line_width(style, 2);
    lv_style_set_line_opa(style, 255);
};

lv_style_t *get_style_climate_section_heat_INDICATOR_DEFAULT() {
    static lv_style_t *style;
    if (!style) {
        style = (lv_style_t *)lv_malloc(sizeof(lv_style_t));
        lv_style_init(style);
        init_style_climate_section_heat_INDICATOR_DEFAULT(style);
    }
    return style;
};

void add_style_climate_section_heat(lv_obj_t *obj) {
    (void)obj;
    lv_obj_add_style(obj, get_style_climate_section_heat_MAIN_DEFAULT(), LV_PART_MAIN | LV_STATE_DEFAULT);
    lv_obj_add_style(obj, get_style_climate_section_heat_INDICATOR_DEFAULT(), LV_PART_INDICATOR | LV_STATE_DEFAULT);
};

void remove_style_climate_section_heat(lv_obj_t *obj) {
    (void)obj;
    lv_obj_remove_style(obj, get_style_climate_section_heat_MAIN_DEFAULT(), LV_PART_MAIN | LV_STATE_DEFAULT);
    lv_obj_remove_style(obj, get_style_climate_section_heat_INDICATOR_DEFAULT(), LV_PART_INDICATOR | LV_STATE_DEFAULT);
};

//
// Style: ClimateSectionCool
//

void init_style_climate_section_cool_MAIN_DEFAULT(lv_style_t *style) {
};

lv_style_t *get_style_climate_section_cool_MAIN_DEFAULT() {
    static lv_style_t *style;
    if (!style) {
        style = (lv_style_t *)lv_malloc(sizeof(lv_style_t));
        lv_style_init(style);
        init_style_climate_section_cool_MAIN_DEFAULT(style);
    }
    return style;
};

void init_style_climate_section_cool_INDICATOR_DEFAULT(lv_style_t *style) {
    lv_style_set_line_color(style, lv_color_hex(theme_colors[active_theme_index][13]));
    lv_style_set_line_width(style, 2);
    lv_style_set_line_opa(style, 255);
};

lv_style_t *get_style_climate_section_cool_INDICATOR_DEFAULT() {
    static lv_style_t *style;
    if (!style) {
        style = (lv_style_t *)lv_malloc(sizeof(lv_style_t));
        lv_style_init(style);
        init_style_climate_section_cool_INDICATOR_DEFAULT(style);
    }
    return style;
};

void add_style_climate_section_cool(lv_obj_t *obj) {
    (void)obj;
    lv_obj_add_style(obj, get_style_climate_section_cool_MAIN_DEFAULT(), LV_PART_MAIN | LV_STATE_DEFAULT);
    lv_obj_add_style(obj, get_style_climate_section_cool_INDICATOR_DEFAULT(), LV_PART_INDICATOR | LV_STATE_DEFAULT);
};

void remove_style_climate_section_cool(lv_obj_t *obj) {
    (void)obj;
    lv_obj_remove_style(obj, get_style_climate_section_cool_MAIN_DEFAULT(), LV_PART_MAIN | LV_STATE_DEFAULT);
    lv_obj_remove_style(obj, get_style_climate_section_cool_INDICATOR_DEFAULT(), LV_PART_INDICATOR | LV_STATE_DEFAULT);
};

//
// Style: ClimateSectionHold
//

void init_style_climate_section_hold_MAIN_DEFAULT(lv_style_t *style) {
};

lv_style_t *get_style_climate_section_hold_MAIN_DEFAULT() {
    static lv_style_t *style;
    if (!style) {
        style = (lv_style_t *)lv_malloc(sizeof(lv_style_t));
        lv_style_init(style);
        init_style_climate_section_hold_MAIN_DEFAULT(style);
    }
    return style;
};

void init_style_climate_section_hold_INDICATOR_DEFAULT(lv_style_t *style) {
    lv_style_set_line_color(style, lv_color_hex(theme_colors[active_theme_index][9]));
    lv_style_set_line_width(style, 2);
    lv_style_set_line_opa(style, 255);
};

lv_style_t *get_style_climate_section_hold_INDICATOR_DEFAULT() {
    static lv_style_t *style;
    if (!style) {
        style = (lv_style_t *)lv_malloc(sizeof(lv_style_t));
        lv_style_init(style);
        init_style_climate_section_hold_INDICATOR_DEFAULT(style);
    }
    return style;
};

void add_style_climate_section_hold(lv_obj_t *obj) {
    (void)obj;
    lv_obj_add_style(obj, get_style_climate_section_hold_MAIN_DEFAULT(), LV_PART_MAIN | LV_STATE_DEFAULT);
    lv_obj_add_style(obj, get_style_climate_section_hold_INDICATOR_DEFAULT(), LV_PART_INDICATOR | LV_STATE_DEFAULT);
};

void remove_style_climate_section_hold(lv_obj_t *obj) {
    (void)obj;
    lv_obj_remove_style(obj, get_style_climate_section_hold_MAIN_DEFAULT(), LV_PART_MAIN | LV_STATE_DEFAULT);
    lv_obj_remove_style(obj, get_style_climate_section_hold_INDICATOR_DEFAULT(), LV_PART_INDICATOR | LV_STATE_DEFAULT);
};

//
// Style: ClimateNeedleInside
//

void init_style_climate_needle_inside_MAIN_DEFAULT(lv_style_t *style) {
    lv_style_set_line_color(style, lv_color_hex(theme_colors[active_theme_index][7]));
    lv_style_set_line_width(style, 2);
    lv_style_set_line_opa(style, 255);
    lv_style_set_line_rounded(style, true);
};

lv_style_t *get_style_climate_needle_inside_MAIN_DEFAULT() {
    static lv_style_t *style;
    if (!style) {
        style = (lv_style_t *)lv_malloc(sizeof(lv_style_t));
        lv_style_init(style);
        init_style_climate_needle_inside_MAIN_DEFAULT(style);
    }
    return style;
};

void add_style_climate_needle_inside(lv_obj_t *obj) {
    (void)obj;
    lv_obj_add_style(obj, get_style_climate_needle_inside_MAIN_DEFAULT(), LV_PART_MAIN | LV_STATE_DEFAULT);
};

void remove_style_climate_needle_inside(lv_obj_t *obj) {
    (void)obj;
    lv_obj_remove_style(obj, get_style_climate_needle_inside_MAIN_DEFAULT(), LV_PART_MAIN | LV_STATE_DEFAULT);
};

//
// Style: ClimateNeedleTarget
//

void init_style_climate_needle_target_MAIN_DEFAULT(lv_style_t *style) {
    lv_style_set_line_color(style, lv_color_hex(theme_colors[active_theme_index][6]));
    lv_style_set_line_width(style, 3);
    lv_style_set_line_opa(style, 255);
    lv_style_set_line_rounded(style, true);
};

lv_style_t *get_style_climate_needle_target_MAIN_DEFAULT() {
    static lv_style_t *style;
    if (!style) {
        style = (lv_style_t *)lv_malloc(sizeof(lv_style_t));
        lv_style_init(style);
        init_style_climate_needle_target_MAIN_DEFAULT(style);
    }
    return style;
};

void add_style_climate_needle_target(lv_obj_t *obj) {
    (void)obj;
    lv_obj_add_style(obj, get_style_climate_needle_target_MAIN_DEFAULT(), LV_PART_MAIN | LV_STATE_DEFAULT);
};

void remove_style_climate_needle_target(lv_obj_t *obj) {
    (void)obj;
    lv_obj_remove_style(obj, get_style_climate_needle_target_MAIN_DEFAULT(), LV_PART_MAIN | LV_STATE_DEFAULT);
};

//
// Style: ClimateNum
//

void init_style_climate_num_MAIN_DEFAULT(lv_style_t *style) {
    lv_style_set_text_color(style, lv_color_hex(theme_colors[active_theme_index][6]));
    lv_style_set_text_font(style, &ui_font_rn75);
    lv_style_set_text_letter_space(style, -2);
    lv_style_set_text_align(style, LV_TEXT_ALIGN_CENTER);
};

lv_style_t *get_style_climate_num_MAIN_DEFAULT() {
    static lv_style_t *style;
    if (!style) {
        style = (lv_style_t *)lv_malloc(sizeof(lv_style_t));
        lv_style_init(style);
        init_style_climate_num_MAIN_DEFAULT(style);
    }
    return style;
};

void add_style_climate_num(lv_obj_t *obj) {
    (void)obj;
    lv_obj_add_style(obj, get_style_climate_num_MAIN_DEFAULT(), LV_PART_MAIN | LV_STATE_DEFAULT);
};

void remove_style_climate_num(lv_obj_t *obj) {
    (void)obj;
    lv_obj_remove_style(obj, get_style_climate_num_MAIN_DEFAULT(), LV_PART_MAIN | LV_STATE_DEFAULT);
};

//
// Style: ClimateModeText
//

void init_style_climate_mode_text_MAIN_DEFAULT(lv_style_t *style) {
    lv_style_set_text_color(style, lv_color_hex(theme_colors[active_theme_index][28]));
    lv_style_set_text_font(style, &ui_font_rr13);
    lv_style_set_text_letter_space(style, 1);
};

lv_style_t *get_style_climate_mode_text_MAIN_DEFAULT() {
    static lv_style_t *style;
    if (!style) {
        style = (lv_style_t *)lv_malloc(sizeof(lv_style_t));
        lv_style_init(style);
        init_style_climate_mode_text_MAIN_DEFAULT(style);
    }
    return style;
};

void init_style_climate_mode_text_MAIN_CHECKED(lv_style_t *style) {
    lv_style_set_text_color(style, lv_color_hex(theme_colors[active_theme_index][31]));
};

lv_style_t *get_style_climate_mode_text_MAIN_CHECKED() {
    static lv_style_t *style;
    if (!style) {
        style = (lv_style_t *)lv_malloc(sizeof(lv_style_t));
        lv_style_init(style);
        init_style_climate_mode_text_MAIN_CHECKED(style);
    }
    return style;
};

void init_style_climate_mode_text_MAIN_PRESSED(lv_style_t *style) {
    lv_style_set_text_color(style, lv_color_hex(theme_colors[active_theme_index][30]));
};

lv_style_t *get_style_climate_mode_text_MAIN_PRESSED() {
    static lv_style_t *style;
    if (!style) {
        style = (lv_style_t *)lv_malloc(sizeof(lv_style_t));
        lv_style_init(style);
        init_style_climate_mode_text_MAIN_PRESSED(style);
    }
    return style;
};

void init_style_climate_mode_text_MAIN_DISABLED(lv_style_t *style) {
    lv_style_set_text_color(style, lv_color_hex(theme_colors[active_theme_index][8]));
};

lv_style_t *get_style_climate_mode_text_MAIN_DISABLED() {
    static lv_style_t *style;
    if (!style) {
        style = (lv_style_t *)lv_malloc(sizeof(lv_style_t));
        lv_style_init(style);
        init_style_climate_mode_text_MAIN_DISABLED(style);
    }
    return style;
};

void add_style_climate_mode_text(lv_obj_t *obj) {
    (void)obj;
    lv_obj_add_style(obj, get_style_climate_mode_text_MAIN_DEFAULT(), LV_PART_MAIN | LV_STATE_DEFAULT);
    lv_obj_add_style(obj, get_style_climate_mode_text_MAIN_CHECKED(), LV_PART_MAIN | LV_STATE_CHECKED);
    lv_obj_add_style(obj, get_style_climate_mode_text_MAIN_PRESSED(), LV_PART_MAIN | LV_STATE_PRESSED);
    lv_obj_add_style(obj, get_style_climate_mode_text_MAIN_DISABLED(), LV_PART_MAIN | LV_STATE_DISABLED);
};

void remove_style_climate_mode_text(lv_obj_t *obj) {
    (void)obj;
    lv_obj_remove_style(obj, get_style_climate_mode_text_MAIN_DEFAULT(), LV_PART_MAIN | LV_STATE_DEFAULT);
    lv_obj_remove_style(obj, get_style_climate_mode_text_MAIN_CHECKED(), LV_PART_MAIN | LV_STATE_CHECKED);
    lv_obj_remove_style(obj, get_style_climate_mode_text_MAIN_PRESSED(), LV_PART_MAIN | LV_STATE_PRESSED);
    lv_obj_remove_style(obj, get_style_climate_mode_text_MAIN_DISABLED(), LV_PART_MAIN | LV_STATE_DISABLED);
};

//
// Style: ClimateModeIcon
//

void init_style_climate_mode_icon_MAIN_DEFAULT(lv_style_t *style) {
    lv_style_set_text_color(style, lv_color_hex(theme_colors[active_theme_index][28]));
    lv_style_set_text_font(style, &ui_font_fa13);
};

lv_style_t *get_style_climate_mode_icon_MAIN_DEFAULT() {
    static lv_style_t *style;
    if (!style) {
        style = (lv_style_t *)lv_malloc(sizeof(lv_style_t));
        lv_style_init(style);
        init_style_climate_mode_icon_MAIN_DEFAULT(style);
    }
    return style;
};

void init_style_climate_mode_icon_MAIN_CHECKED(lv_style_t *style) {
    lv_style_set_text_color(style, lv_color_hex(theme_colors[active_theme_index][31]));
};

lv_style_t *get_style_climate_mode_icon_MAIN_CHECKED() {
    static lv_style_t *style;
    if (!style) {
        style = (lv_style_t *)lv_malloc(sizeof(lv_style_t));
        lv_style_init(style);
        init_style_climate_mode_icon_MAIN_CHECKED(style);
    }
    return style;
};

void init_style_climate_mode_icon_MAIN_PRESSED(lv_style_t *style) {
    lv_style_set_text_color(style, lv_color_hex(theme_colors[active_theme_index][30]));
};

lv_style_t *get_style_climate_mode_icon_MAIN_PRESSED() {
    static lv_style_t *style;
    if (!style) {
        style = (lv_style_t *)lv_malloc(sizeof(lv_style_t));
        lv_style_init(style);
        init_style_climate_mode_icon_MAIN_PRESSED(style);
    }
    return style;
};

void init_style_climate_mode_icon_MAIN_DISABLED(lv_style_t *style) {
    lv_style_set_text_color(style, lv_color_hex(theme_colors[active_theme_index][8]));
};

lv_style_t *get_style_climate_mode_icon_MAIN_DISABLED() {
    static lv_style_t *style;
    if (!style) {
        style = (lv_style_t *)lv_malloc(sizeof(lv_style_t));
        lv_style_init(style);
        init_style_climate_mode_icon_MAIN_DISABLED(style);
    }
    return style;
};

void add_style_climate_mode_icon(lv_obj_t *obj) {
    (void)obj;
    lv_obj_add_style(obj, get_style_climate_mode_icon_MAIN_DEFAULT(), LV_PART_MAIN | LV_STATE_DEFAULT);
    lv_obj_add_style(obj, get_style_climate_mode_icon_MAIN_CHECKED(), LV_PART_MAIN | LV_STATE_CHECKED);
    lv_obj_add_style(obj, get_style_climate_mode_icon_MAIN_PRESSED(), LV_PART_MAIN | LV_STATE_PRESSED);
    lv_obj_add_style(obj, get_style_climate_mode_icon_MAIN_DISABLED(), LV_PART_MAIN | LV_STATE_DISABLED);
};

void remove_style_climate_mode_icon(lv_obj_t *obj) {
    (void)obj;
    lv_obj_remove_style(obj, get_style_climate_mode_icon_MAIN_DEFAULT(), LV_PART_MAIN | LV_STATE_DEFAULT);
    lv_obj_remove_style(obj, get_style_climate_mode_icon_MAIN_CHECKED(), LV_PART_MAIN | LV_STATE_CHECKED);
    lv_obj_remove_style(obj, get_style_climate_mode_icon_MAIN_PRESSED(), LV_PART_MAIN | LV_STATE_PRESSED);
    lv_obj_remove_style(obj, get_style_climate_mode_icon_MAIN_DISABLED(), LV_PART_MAIN | LV_STATE_DISABLED);
};

//
// Style: EnergyArc
//

void init_style_energy_arc_MAIN_DEFAULT(lv_style_t *style) {
    lv_style_set_arc_color(style, lv_color_hex(theme_colors[active_theme_index][5]));
    lv_style_set_arc_width(style, 7);
    lv_style_set_arc_opa(style, 255);
    lv_style_set_arc_rounded(style, true);
    lv_style_set_bg_opa(style, 0);
    lv_style_set_border_width(style, 0);
    lv_style_set_pad_top(style, 0);
    lv_style_set_pad_bottom(style, 0);
    lv_style_set_pad_left(style, 0);
    lv_style_set_pad_right(style, 0);
};

lv_style_t *get_style_energy_arc_MAIN_DEFAULT() {
    static lv_style_t *style;
    if (!style) {
        style = (lv_style_t *)lv_malloc(sizeof(lv_style_t));
        lv_style_init(style);
        init_style_energy_arc_MAIN_DEFAULT(style);
    }
    return style;
};

void init_style_energy_arc_INDICATOR_DEFAULT(lv_style_t *style) {
    lv_style_set_arc_color(style, lv_color_hex(theme_colors[active_theme_index][9]));
    lv_style_set_arc_width(style, 7);
    lv_style_set_arc_opa(style, 255);
    lv_style_set_arc_rounded(style, true);
};

lv_style_t *get_style_energy_arc_INDICATOR_DEFAULT() {
    static lv_style_t *style;
    if (!style) {
        style = (lv_style_t *)lv_malloc(sizeof(lv_style_t));
        lv_style_init(style);
        init_style_energy_arc_INDICATOR_DEFAULT(style);
    }
    return style;
};

void init_style_energy_arc_INDICATOR_CHECKED(lv_style_t *style) {
    lv_style_set_arc_color(style, lv_color_hex(theme_colors[active_theme_index][11]));
    lv_style_set_arc_width(style, 7);
    lv_style_set_arc_opa(style, 255);
    lv_style_set_arc_rounded(style, true);
};

lv_style_t *get_style_energy_arc_INDICATOR_CHECKED() {
    static lv_style_t *style;
    if (!style) {
        style = (lv_style_t *)lv_malloc(sizeof(lv_style_t));
        lv_style_init(style);
        init_style_energy_arc_INDICATOR_CHECKED(style);
    }
    return style;
};

void init_style_energy_arc_INDICATOR_PRESSED(lv_style_t *style) {
    lv_style_set_arc_color(style, lv_color_hex(theme_colors[active_theme_index][13]));
    lv_style_set_arc_width(style, 7);
    lv_style_set_arc_opa(style, 255);
    lv_style_set_arc_rounded(style, true);
};

lv_style_t *get_style_energy_arc_INDICATOR_PRESSED() {
    static lv_style_t *style;
    if (!style) {
        style = (lv_style_t *)lv_malloc(sizeof(lv_style_t));
        lv_style_init(style);
        init_style_energy_arc_INDICATOR_PRESSED(style);
    }
    return style;
};

void init_style_energy_arc_INDICATOR_DISABLED(lv_style_t *style) {
    lv_style_set_arc_color(style, lv_color_hex(theme_colors[active_theme_index][5]));
    lv_style_set_arc_width(style, 7);
    lv_style_set_arc_opa(style, 0);
    lv_style_set_arc_rounded(style, true);
};

lv_style_t *get_style_energy_arc_INDICATOR_DISABLED() {
    static lv_style_t *style;
    if (!style) {
        style = (lv_style_t *)lv_malloc(sizeof(lv_style_t));
        lv_style_init(style);
        init_style_energy_arc_INDICATOR_DISABLED(style);
    }
    return style;
};

void init_style_energy_arc_KNOB_DEFAULT(lv_style_t *style) {
    lv_style_set_bg_opa(style, 0);
    lv_style_set_pad_top(style, 0);
    lv_style_set_pad_bottom(style, 0);
    lv_style_set_pad_left(style, 0);
    lv_style_set_pad_right(style, 0);
};

lv_style_t *get_style_energy_arc_KNOB_DEFAULT() {
    static lv_style_t *style;
    if (!style) {
        style = (lv_style_t *)lv_malloc(sizeof(lv_style_t));
        lv_style_init(style);
        init_style_energy_arc_KNOB_DEFAULT(style);
    }
    return style;
};

void add_style_energy_arc(lv_obj_t *obj) {
    (void)obj;
    lv_obj_add_style(obj, get_style_energy_arc_MAIN_DEFAULT(), LV_PART_MAIN | LV_STATE_DEFAULT);
    lv_obj_add_style(obj, get_style_energy_arc_INDICATOR_DEFAULT(), LV_PART_INDICATOR | LV_STATE_DEFAULT);
    lv_obj_add_style(obj, get_style_energy_arc_INDICATOR_CHECKED(), LV_PART_INDICATOR | LV_STATE_CHECKED);
    lv_obj_add_style(obj, get_style_energy_arc_INDICATOR_PRESSED(), LV_PART_INDICATOR | LV_STATE_PRESSED);
    lv_obj_add_style(obj, get_style_energy_arc_INDICATOR_DISABLED(), LV_PART_INDICATOR | LV_STATE_DISABLED);
    lv_obj_add_style(obj, get_style_energy_arc_KNOB_DEFAULT(), LV_PART_KNOB | LV_STATE_DEFAULT);
};

void remove_style_energy_arc(lv_obj_t *obj) {
    (void)obj;
    lv_obj_remove_style(obj, get_style_energy_arc_MAIN_DEFAULT(), LV_PART_MAIN | LV_STATE_DEFAULT);
    lv_obj_remove_style(obj, get_style_energy_arc_INDICATOR_DEFAULT(), LV_PART_INDICATOR | LV_STATE_DEFAULT);
    lv_obj_remove_style(obj, get_style_energy_arc_INDICATOR_CHECKED(), LV_PART_INDICATOR | LV_STATE_CHECKED);
    lv_obj_remove_style(obj, get_style_energy_arc_INDICATOR_PRESSED(), LV_PART_INDICATOR | LV_STATE_PRESSED);
    lv_obj_remove_style(obj, get_style_energy_arc_INDICATOR_DISABLED(), LV_PART_INDICATOR | LV_STATE_DISABLED);
    lv_obj_remove_style(obj, get_style_energy_arc_KNOB_DEFAULT(), LV_PART_KNOB | LV_STATE_DEFAULT);
};

//
// Style: EnergyHead
//

void init_style_energy_head_MAIN_DEFAULT(lv_style_t *style) {
    lv_style_set_text_color(style, lv_color_hex(theme_colors[active_theme_index][28]));
    lv_style_set_text_font(style, &ui_font_rr13);
    lv_style_set_text_letter_space(style, 1);
};

lv_style_t *get_style_energy_head_MAIN_DEFAULT() {
    static lv_style_t *style;
    if (!style) {
        style = (lv_style_t *)lv_malloc(sizeof(lv_style_t));
        lv_style_init(style);
        init_style_energy_head_MAIN_DEFAULT(style);
    }
    return style;
};

void init_style_energy_head_MAIN_CHECKED(lv_style_t *style) {
    lv_style_set_text_color(style, lv_color_hex(theme_colors[active_theme_index][29]));
};

lv_style_t *get_style_energy_head_MAIN_CHECKED() {
    static lv_style_t *style;
    if (!style) {
        style = (lv_style_t *)lv_malloc(sizeof(lv_style_t));
        lv_style_init(style);
        init_style_energy_head_MAIN_CHECKED(style);
    }
    return style;
};

void init_style_energy_head_MAIN_PRESSED(lv_style_t *style) {
    lv_style_set_text_color(style, lv_color_hex(theme_colors[active_theme_index][30]));
};

lv_style_t *get_style_energy_head_MAIN_PRESSED() {
    static lv_style_t *style;
    if (!style) {
        style = (lv_style_t *)lv_malloc(sizeof(lv_style_t));
        lv_style_init(style);
        init_style_energy_head_MAIN_PRESSED(style);
    }
    return style;
};

void add_style_energy_head(lv_obj_t *obj) {
    (void)obj;
    lv_obj_add_style(obj, get_style_energy_head_MAIN_DEFAULT(), LV_PART_MAIN | LV_STATE_DEFAULT);
    lv_obj_add_style(obj, get_style_energy_head_MAIN_CHECKED(), LV_PART_MAIN | LV_STATE_CHECKED);
    lv_obj_add_style(obj, get_style_energy_head_MAIN_PRESSED(), LV_PART_MAIN | LV_STATE_PRESSED);
};

void remove_style_energy_head(lv_obj_t *obj) {
    (void)obj;
    lv_obj_remove_style(obj, get_style_energy_head_MAIN_DEFAULT(), LV_PART_MAIN | LV_STATE_DEFAULT);
    lv_obj_remove_style(obj, get_style_energy_head_MAIN_CHECKED(), LV_PART_MAIN | LV_STATE_CHECKED);
    lv_obj_remove_style(obj, get_style_energy_head_MAIN_PRESSED(), LV_PART_MAIN | LV_STATE_PRESSED);
};

//
// Style: EnergyHeadIcon
//

void init_style_energy_head_icon_MAIN_DEFAULT(lv_style_t *style) {
    lv_style_set_text_color(style, lv_color_hex(theme_colors[active_theme_index][28]));
    lv_style_set_text_font(style, &ui_font_fa13);
};

lv_style_t *get_style_energy_head_icon_MAIN_DEFAULT() {
    static lv_style_t *style;
    if (!style) {
        style = (lv_style_t *)lv_malloc(sizeof(lv_style_t));
        lv_style_init(style);
        init_style_energy_head_icon_MAIN_DEFAULT(style);
    }
    return style;
};

void init_style_energy_head_icon_MAIN_CHECKED(lv_style_t *style) {
    lv_style_set_text_color(style, lv_color_hex(theme_colors[active_theme_index][29]));
};

lv_style_t *get_style_energy_head_icon_MAIN_CHECKED() {
    static lv_style_t *style;
    if (!style) {
        style = (lv_style_t *)lv_malloc(sizeof(lv_style_t));
        lv_style_init(style);
        init_style_energy_head_icon_MAIN_CHECKED(style);
    }
    return style;
};

void init_style_energy_head_icon_MAIN_PRESSED(lv_style_t *style) {
    lv_style_set_text_color(style, lv_color_hex(theme_colors[active_theme_index][30]));
};

lv_style_t *get_style_energy_head_icon_MAIN_PRESSED() {
    static lv_style_t *style;
    if (!style) {
        style = (lv_style_t *)lv_malloc(sizeof(lv_style_t));
        lv_style_init(style);
        init_style_energy_head_icon_MAIN_PRESSED(style);
    }
    return style;
};

void add_style_energy_head_icon(lv_obj_t *obj) {
    (void)obj;
    lv_obj_add_style(obj, get_style_energy_head_icon_MAIN_DEFAULT(), LV_PART_MAIN | LV_STATE_DEFAULT);
    lv_obj_add_style(obj, get_style_energy_head_icon_MAIN_CHECKED(), LV_PART_MAIN | LV_STATE_CHECKED);
    lv_obj_add_style(obj, get_style_energy_head_icon_MAIN_PRESSED(), LV_PART_MAIN | LV_STATE_PRESSED);
};

void remove_style_energy_head_icon(lv_obj_t *obj) {
    (void)obj;
    lv_obj_remove_style(obj, get_style_energy_head_icon_MAIN_DEFAULT(), LV_PART_MAIN | LV_STATE_DEFAULT);
    lv_obj_remove_style(obj, get_style_energy_head_icon_MAIN_CHECKED(), LV_PART_MAIN | LV_STATE_CHECKED);
    lv_obj_remove_style(obj, get_style_energy_head_icon_MAIN_PRESSED(), LV_PART_MAIN | LV_STATE_PRESSED);
};

//
// Style: EnergyUnit
//

void init_style_energy_unit_MAIN_DEFAULT(lv_style_t *style) {
    lv_style_set_text_color(style, lv_color_hex(theme_colors[active_theme_index][7]));
    lv_style_set_text_font(style, &ui_font_rr15);
    lv_style_set_translate_y(style, 3);
};

lv_style_t *get_style_energy_unit_MAIN_DEFAULT() {
    static lv_style_t *style;
    if (!style) {
        style = (lv_style_t *)lv_malloc(sizeof(lv_style_t));
        lv_style_init(style);
        init_style_energy_unit_MAIN_DEFAULT(style);
    }
    return style;
};

void add_style_energy_unit(lv_obj_t *obj) {
    (void)obj;
    lv_obj_add_style(obj, get_style_energy_unit_MAIN_DEFAULT(), LV_PART_MAIN | LV_STATE_DEFAULT);
};

void remove_style_energy_unit(lv_obj_t *obj) {
    (void)obj;
    lv_obj_remove_style(obj, get_style_energy_unit_MAIN_DEFAULT(), LV_PART_MAIN | LV_STATE_DEFAULT);
};

//
// Style: SettingsTile
//

void init_style_settings_tile_MAIN_DEFAULT(lv_style_t *style) {
    lv_style_set_bg_color(style, lv_color_hex(theme_colors[active_theme_index][2]));
    lv_style_set_bg_opa(style, 255);
    lv_style_set_border_color(style, lv_color_hex(theme_colors[active_theme_index][9]));
    lv_style_set_border_width(style, 2);
    lv_style_set_border_opa(style, 255);
    lv_style_set_shadow_color(style, lv_color_hex(theme_colors[active_theme_index][9]));
    lv_style_set_shadow_opa(style, 128);
    lv_style_set_shadow_width(style, 10);
    lv_style_set_shadow_spread(style, 0);
    lv_style_set_radius(style, 1000);
    lv_style_set_pad_top(style, 0);
    lv_style_set_pad_bottom(style, 0);
    lv_style_set_pad_left(style, 0);
    lv_style_set_pad_right(style, 0);
};

lv_style_t *get_style_settings_tile_MAIN_DEFAULT() {
    static lv_style_t *style;
    if (!style) {
        style = (lv_style_t *)lv_malloc(sizeof(lv_style_t));
        lv_style_init(style);
        init_style_settings_tile_MAIN_DEFAULT(style);
    }
    return style;
};

void init_style_settings_tile_MAIN_CHECKED(lv_style_t *style) {
    lv_style_set_border_color(style, lv_color_hex(theme_colors[active_theme_index][14]));
    lv_style_set_shadow_color(style, lv_color_hex(theme_colors[active_theme_index][14]));
};

lv_style_t *get_style_settings_tile_MAIN_CHECKED() {
    static lv_style_t *style;
    if (!style) {
        style = (lv_style_t *)lv_malloc(sizeof(lv_style_t));
        lv_style_init(style);
        init_style_settings_tile_MAIN_CHECKED(style);
    }
    return style;
};

void add_style_settings_tile(lv_obj_t *obj) {
    (void)obj;
    lv_obj_add_style(obj, get_style_settings_tile_MAIN_DEFAULT(), LV_PART_MAIN | LV_STATE_DEFAULT);
    lv_obj_add_style(obj, get_style_settings_tile_MAIN_CHECKED(), LV_PART_MAIN | LV_STATE_CHECKED);
};

void remove_style_settings_tile(lv_obj_t *obj) {
    (void)obj;
    lv_obj_remove_style(obj, get_style_settings_tile_MAIN_DEFAULT(), LV_PART_MAIN | LV_STATE_DEFAULT);
    lv_obj_remove_style(obj, get_style_settings_tile_MAIN_CHECKED(), LV_PART_MAIN | LV_STATE_CHECKED);
};

//
// Style: SettingsIcon
//

void init_style_settings_icon_MAIN_DEFAULT(lv_style_t *style) {
    lv_style_set_text_color(style, lv_color_hex(theme_colors[active_theme_index][9]));
    lv_style_set_text_font(style, &ui_font_fa30);
    lv_style_set_text_align(style, LV_TEXT_ALIGN_CENTER);
};

lv_style_t *get_style_settings_icon_MAIN_DEFAULT() {
    static lv_style_t *style;
    if (!style) {
        style = (lv_style_t *)lv_malloc(sizeof(lv_style_t));
        lv_style_init(style);
        init_style_settings_icon_MAIN_DEFAULT(style);
    }
    return style;
};

void init_style_settings_icon_MAIN_CHECKED(lv_style_t *style) {
    lv_style_set_text_color(style, lv_color_hex(theme_colors[active_theme_index][14]));
};

lv_style_t *get_style_settings_icon_MAIN_CHECKED() {
    static lv_style_t *style;
    if (!style) {
        style = (lv_style_t *)lv_malloc(sizeof(lv_style_t));
        lv_style_init(style);
        init_style_settings_icon_MAIN_CHECKED(style);
    }
    return style;
};

void add_style_settings_icon(lv_obj_t *obj) {
    (void)obj;
    lv_obj_add_style(obj, get_style_settings_icon_MAIN_DEFAULT(), LV_PART_MAIN | LV_STATE_DEFAULT);
    lv_obj_add_style(obj, get_style_settings_icon_MAIN_CHECKED(), LV_PART_MAIN | LV_STATE_CHECKED);
};

void remove_style_settings_icon(lv_obj_t *obj) {
    (void)obj;
    lv_obj_remove_style(obj, get_style_settings_icon_MAIN_DEFAULT(), LV_PART_MAIN | LV_STATE_DEFAULT);
    lv_obj_remove_style(obj, get_style_settings_icon_MAIN_CHECKED(), LV_PART_MAIN | LV_STATE_CHECKED);
};

//
// Style: SettingsValue
//

void init_style_settings_value_MAIN_DEFAULT(lv_style_t *style) {
    lv_style_set_text_color(style, lv_color_hex(theme_colors[active_theme_index][7]));
    lv_style_set_text_font(style, &ui_font_rr13);
};

lv_style_t *get_style_settings_value_MAIN_DEFAULT() {
    static lv_style_t *style;
    if (!style) {
        style = (lv_style_t *)lv_malloc(sizeof(lv_style_t));
        lv_style_init(style);
        init_style_settings_value_MAIN_DEFAULT(style);
    }
    return style;
};

void init_style_settings_value_MAIN_CHECKED(lv_style_t *style) {
    lv_style_set_text_color(style, lv_color_hex(theme_colors[active_theme_index][28]));
};

lv_style_t *get_style_settings_value_MAIN_CHECKED() {
    static lv_style_t *style;
    if (!style) {
        style = (lv_style_t *)lv_malloc(sizeof(lv_style_t));
        lv_style_init(style);
        init_style_settings_value_MAIN_CHECKED(style);
    }
    return style;
};

void init_style_settings_value_MAIN_PRESSED(lv_style_t *style) {
    lv_style_set_text_color(style, lv_color_hex(theme_colors[active_theme_index][29]));
};

lv_style_t *get_style_settings_value_MAIN_PRESSED() {
    static lv_style_t *style;
    if (!style) {
        style = (lv_style_t *)lv_malloc(sizeof(lv_style_t));
        lv_style_init(style);
        init_style_settings_value_MAIN_PRESSED(style);
    }
    return style;
};

void init_style_settings_value_MAIN_DISABLED(lv_style_t *style) {
    lv_style_set_text_color(style, lv_color_hex(theme_colors[active_theme_index][31]));
};

lv_style_t *get_style_settings_value_MAIN_DISABLED() {
    static lv_style_t *style;
    if (!style) {
        style = (lv_style_t *)lv_malloc(sizeof(lv_style_t));
        lv_style_init(style);
        init_style_settings_value_MAIN_DISABLED(style);
    }
    return style;
};

void add_style_settings_value(lv_obj_t *obj) {
    (void)obj;
    lv_obj_add_style(obj, get_style_settings_value_MAIN_DEFAULT(), LV_PART_MAIN | LV_STATE_DEFAULT);
    lv_obj_add_style(obj, get_style_settings_value_MAIN_CHECKED(), LV_PART_MAIN | LV_STATE_CHECKED);
    lv_obj_add_style(obj, get_style_settings_value_MAIN_PRESSED(), LV_PART_MAIN | LV_STATE_PRESSED);
    lv_obj_add_style(obj, get_style_settings_value_MAIN_DISABLED(), LV_PART_MAIN | LV_STATE_DISABLED);
};

void remove_style_settings_value(lv_obj_t *obj) {
    (void)obj;
    lv_obj_remove_style(obj, get_style_settings_value_MAIN_DEFAULT(), LV_PART_MAIN | LV_STATE_DEFAULT);
    lv_obj_remove_style(obj, get_style_settings_value_MAIN_CHECKED(), LV_PART_MAIN | LV_STATE_CHECKED);
    lv_obj_remove_style(obj, get_style_settings_value_MAIN_PRESSED(), LV_PART_MAIN | LV_STATE_PRESSED);
    lv_obj_remove_style(obj, get_style_settings_value_MAIN_DISABLED(), LV_PART_MAIN | LV_STATE_DISABLED);
};

//
// Style: ListRow
//

void init_style_list_row_MAIN_DEFAULT(lv_style_t *style) {
    lv_style_set_bg_opa(style, 0);
    lv_style_set_border_color(style, lv_color_hex(theme_colors[active_theme_index][5]));
    lv_style_set_border_width(style, 2);
    lv_style_set_border_opa(style, 255);
    lv_style_set_radius(style, 6);
    lv_style_set_text_color(style, lv_color_hex(theme_colors[active_theme_index][7]));
    lv_style_set_pad_top(style, 0);
    lv_style_set_pad_bottom(style, 0);
    lv_style_set_pad_left(style, 0);
    lv_style_set_pad_right(style, 0);
};

lv_style_t *get_style_list_row_MAIN_DEFAULT() {
    static lv_style_t *style;
    if (!style) {
        style = (lv_style_t *)lv_malloc(sizeof(lv_style_t));
        lv_style_init(style);
        init_style_list_row_MAIN_DEFAULT(style);
    }
    return style;
};

void init_style_list_row_MAIN_CHECKED(lv_style_t *style) {
    lv_style_set_bg_color(style, lv_color_hex(theme_colors[active_theme_index][2]));
    lv_style_set_bg_opa(style, 255);
    lv_style_set_border_color(style, lv_color_hex(theme_colors[active_theme_index][9]));
    lv_style_set_text_color(style, lv_color_hex(theme_colors[active_theme_index][6]));
};

lv_style_t *get_style_list_row_MAIN_CHECKED() {
    static lv_style_t *style;
    if (!style) {
        style = (lv_style_t *)lv_malloc(sizeof(lv_style_t));
        lv_style_init(style);
        init_style_list_row_MAIN_CHECKED(style);
    }
    return style;
};

void add_style_list_row(lv_obj_t *obj) {
    (void)obj;
    lv_obj_add_style(obj, get_style_list_row_MAIN_DEFAULT(), LV_PART_MAIN | LV_STATE_DEFAULT);
    lv_obj_add_style(obj, get_style_list_row_MAIN_CHECKED(), LV_PART_MAIN | LV_STATE_CHECKED);
};

void remove_style_list_row(lv_obj_t *obj) {
    (void)obj;
    lv_obj_remove_style(obj, get_style_list_row_MAIN_DEFAULT(), LV_PART_MAIN | LV_STATE_DEFAULT);
    lv_obj_remove_style(obj, get_style_list_row_MAIN_CHECKED(), LV_PART_MAIN | LV_STATE_CHECKED);
};

//
// Style: GuideTile
//

void init_style_guide_tile_MAIN_DEFAULT(lv_style_t *style) {
    lv_style_set_bg_color(style, lv_color_hex(theme_colors[active_theme_index][10]));
    lv_style_set_bg_opa(style, 255);
    lv_style_set_border_color(style, lv_color_hex(theme_colors[active_theme_index][9]));
    lv_style_set_border_width(style, 2);
    lv_style_set_border_opa(style, 255);
    lv_style_set_radius(style, 1000);
    lv_style_set_pad_top(style, 0);
    lv_style_set_pad_bottom(style, 0);
    lv_style_set_pad_left(style, 0);
    lv_style_set_pad_right(style, 0);
};

lv_style_t *get_style_guide_tile_MAIN_DEFAULT() {
    static lv_style_t *style;
    if (!style) {
        style = (lv_style_t *)lv_malloc(sizeof(lv_style_t));
        lv_style_init(style);
        init_style_guide_tile_MAIN_DEFAULT(style);
    }
    return style;
};

void add_style_guide_tile(lv_obj_t *obj) {
    (void)obj;
    lv_obj_add_style(obj, get_style_guide_tile_MAIN_DEFAULT(), LV_PART_MAIN | LV_STATE_DEFAULT);
};

void remove_style_guide_tile(lv_obj_t *obj) {
    (void)obj;
    lv_obj_remove_style(obj, get_style_guide_tile_MAIN_DEFAULT(), LV_PART_MAIN | LV_STATE_DEFAULT);
};

//
// Style: GuideIcon
//

void init_style_guide_icon_MAIN_DEFAULT(lv_style_t *style) {
    lv_style_set_text_color(style, lv_color_hex(theme_colors[active_theme_index][9]));
    lv_style_set_text_font(style, &ui_font_fa30);
    lv_style_set_text_align(style, LV_TEXT_ALIGN_CENTER);
};

lv_style_t *get_style_guide_icon_MAIN_DEFAULT() {
    static lv_style_t *style;
    if (!style) {
        style = (lv_style_t *)lv_malloc(sizeof(lv_style_t));
        lv_style_init(style);
        init_style_guide_icon_MAIN_DEFAULT(style);
    }
    return style;
};

void add_style_guide_icon(lv_obj_t *obj) {
    (void)obj;
    lv_obj_add_style(obj, get_style_guide_icon_MAIN_DEFAULT(), LV_PART_MAIN | LV_STATE_DEFAULT);
};

void remove_style_guide_icon(lv_obj_t *obj) {
    (void)obj;
    lv_obj_remove_style(obj, get_style_guide_icon_MAIN_DEFAULT(), LV_PART_MAIN | LV_STATE_DEFAULT);
};

//
// Style: GuideTitle
//

void init_style_guide_title_MAIN_DEFAULT(lv_style_t *style) {
    lv_style_set_text_color(style, lv_color_hex(theme_colors[active_theme_index][6]));
    lv_style_set_text_font(style, &ui_font_rm15);
    lv_style_set_text_align(style, LV_TEXT_ALIGN_CENTER);
};

lv_style_t *get_style_guide_title_MAIN_DEFAULT() {
    static lv_style_t *style;
    if (!style) {
        style = (lv_style_t *)lv_malloc(sizeof(lv_style_t));
        lv_style_init(style);
        init_style_guide_title_MAIN_DEFAULT(style);
    }
    return style;
};

void add_style_guide_title(lv_obj_t *obj) {
    (void)obj;
    lv_obj_add_style(obj, get_style_guide_title_MAIN_DEFAULT(), LV_PART_MAIN | LV_STATE_DEFAULT);
};

void remove_style_guide_title(lv_obj_t *obj) {
    (void)obj;
    lv_obj_remove_style(obj, get_style_guide_title_MAIN_DEFAULT(), LV_PART_MAIN | LV_STATE_DEFAULT);
};

//
// Style: GuideBody
//

void init_style_guide_body_MAIN_DEFAULT(lv_style_t *style) {
    lv_style_set_text_color(style, lv_color_hex(theme_colors[active_theme_index][7]));
    lv_style_set_text_font(style, &ui_font_rr11);
    lv_style_set_text_align(style, LV_TEXT_ALIGN_CENTER);
    lv_style_set_text_line_space(style, 0);
};

lv_style_t *get_style_guide_body_MAIN_DEFAULT() {
    static lv_style_t *style;
    if (!style) {
        style = (lv_style_t *)lv_malloc(sizeof(lv_style_t));
        lv_style_init(style);
        init_style_guide_body_MAIN_DEFAULT(style);
    }
    return style;
};

void add_style_guide_body(lv_obj_t *obj) {
    (void)obj;
    lv_obj_add_style(obj, get_style_guide_body_MAIN_DEFAULT(), LV_PART_MAIN | LV_STATE_DEFAULT);
};

void remove_style_guide_body(lv_obj_t *obj) {
    (void)obj;
    lv_obj_remove_style(obj, get_style_guide_body_MAIN_DEFAULT(), LV_PART_MAIN | LV_STATE_DEFAULT);
};

//
// Style: GuideHint
//

void init_style_guide_hint_MAIN_DEFAULT(lv_style_t *style) {
    lv_style_set_text_color(style, lv_color_hex(theme_colors[active_theme_index][28]));
    lv_style_set_text_font(style, &ui_font_rr11);
};

lv_style_t *get_style_guide_hint_MAIN_DEFAULT() {
    static lv_style_t *style;
    if (!style) {
        style = (lv_style_t *)lv_malloc(sizeof(lv_style_t));
        lv_style_init(style);
        init_style_guide_hint_MAIN_DEFAULT(style);
    }
    return style;
};

void add_style_guide_hint(lv_obj_t *obj) {
    (void)obj;
    lv_obj_add_style(obj, get_style_guide_hint_MAIN_DEFAULT(), LV_PART_MAIN | LV_STATE_DEFAULT);
};

void remove_style_guide_hint(lv_obj_t *obj) {
    (void)obj;
    lv_obj_remove_style(obj, get_style_guide_hint_MAIN_DEFAULT(), LV_PART_MAIN | LV_STATE_DEFAULT);
};

//
// Style: GuideHintIcon
//

void init_style_guide_hint_icon_MAIN_DEFAULT(lv_style_t *style) {
    lv_style_set_text_color(style, lv_color_hex(theme_colors[active_theme_index][28]));
    lv_style_set_text_font(style, &ui_font_fa13);
};

lv_style_t *get_style_guide_hint_icon_MAIN_DEFAULT() {
    static lv_style_t *style;
    if (!style) {
        style = (lv_style_t *)lv_malloc(sizeof(lv_style_t));
        lv_style_init(style);
        init_style_guide_hint_icon_MAIN_DEFAULT(style);
    }
    return style;
};

void add_style_guide_hint_icon(lv_obj_t *obj) {
    (void)obj;
    lv_obj_add_style(obj, get_style_guide_hint_icon_MAIN_DEFAULT(), LV_PART_MAIN | LV_STATE_DEFAULT);
};

void remove_style_guide_hint_icon(lv_obj_t *obj) {
    (void)obj;
    lv_obj_remove_style(obj, get_style_guide_hint_icon_MAIN_DEFAULT(), LV_PART_MAIN | LV_STATE_DEFAULT);
};

//
// Style: GuideDot
//

void init_style_guide_dot_MAIN_DEFAULT(lv_style_t *style) {
    lv_style_set_bg_color(style, lv_color_hex(theme_colors[active_theme_index][5]));
    lv_style_set_bg_opa(style, 255);
    lv_style_set_border_width(style, 0);
    lv_style_set_radius(style, 1000);
    lv_style_set_pad_top(style, 0);
    lv_style_set_pad_bottom(style, 0);
    lv_style_set_pad_left(style, 0);
    lv_style_set_pad_right(style, 0);
};

lv_style_t *get_style_guide_dot_MAIN_DEFAULT() {
    static lv_style_t *style;
    if (!style) {
        style = (lv_style_t *)lv_malloc(sizeof(lv_style_t));
        lv_style_init(style);
        init_style_guide_dot_MAIN_DEFAULT(style);
    }
    return style;
};

void init_style_guide_dot_MAIN_DISABLED(lv_style_t *style) {
    lv_style_set_bg_color(style, lv_color_hex(theme_colors[active_theme_index][9]));
    lv_style_set_bg_opa(style, 255);
};

lv_style_t *get_style_guide_dot_MAIN_DISABLED() {
    static lv_style_t *style;
    if (!style) {
        style = (lv_style_t *)lv_malloc(sizeof(lv_style_t));
        lv_style_init(style);
        init_style_guide_dot_MAIN_DISABLED(style);
    }
    return style;
};

void init_style_guide_dot_MAIN_CHECKED(lv_style_t *style) {
    lv_style_set_bg_color(style, lv_color_hex(theme_colors[active_theme_index][9]));
    lv_style_set_bg_opa(style, 255);
    lv_style_set_transform_width(style, 1);
    lv_style_set_transform_height(style, 1);
};

lv_style_t *get_style_guide_dot_MAIN_CHECKED() {
    static lv_style_t *style;
    if (!style) {
        style = (lv_style_t *)lv_malloc(sizeof(lv_style_t));
        lv_style_init(style);
        init_style_guide_dot_MAIN_CHECKED(style);
    }
    return style;
};

void add_style_guide_dot(lv_obj_t *obj) {
    (void)obj;
    lv_obj_add_style(obj, get_style_guide_dot_MAIN_DEFAULT(), LV_PART_MAIN | LV_STATE_DEFAULT);
    lv_obj_add_style(obj, get_style_guide_dot_MAIN_DISABLED(), LV_PART_MAIN | LV_STATE_DISABLED);
    lv_obj_add_style(obj, get_style_guide_dot_MAIN_CHECKED(), LV_PART_MAIN | LV_STATE_CHECKED);
};

void remove_style_guide_dot(lv_obj_t *obj) {
    (void)obj;
    lv_obj_remove_style(obj, get_style_guide_dot_MAIN_DEFAULT(), LV_PART_MAIN | LV_STATE_DEFAULT);
    lv_obj_remove_style(obj, get_style_guide_dot_MAIN_DISABLED(), LV_PART_MAIN | LV_STATE_DISABLED);
    lv_obj_remove_style(obj, get_style_guide_dot_MAIN_CHECKED(), LV_PART_MAIN | LV_STATE_CHECKED);
};

//
// Style: FaceTicks
//

void init_style_face_ticks_MAIN_DEFAULT(lv_style_t *style) {
    lv_style_set_arc_width(style, 0);
    lv_style_set_arc_opa(style, 0);
    lv_style_set_line_width(style, 0);
    lv_style_set_line_opa(style, 0);
    lv_style_set_bg_opa(style, 0);
    lv_style_set_border_width(style, 0);
    lv_style_set_pad_top(style, 0);
    lv_style_set_pad_bottom(style, 0);
    lv_style_set_pad_left(style, 0);
    lv_style_set_pad_right(style, 0);
};

lv_style_t *get_style_face_ticks_MAIN_DEFAULT() {
    static lv_style_t *style;
    if (!style) {
        style = (lv_style_t *)lv_malloc(sizeof(lv_style_t));
        lv_style_init(style);
        init_style_face_ticks_MAIN_DEFAULT(style);
    }
    return style;
};

void init_style_face_ticks_ITEMS_DEFAULT(lv_style_t *style) {
    lv_style_set_line_color(style, lv_color_hex(theme_colors[active_theme_index][5]));
    lv_style_set_line_width(style, 1);
    lv_style_set_line_opa(style, 255);
    lv_style_set_line_rounded(style, true);
    lv_style_set_length(style, 5);
};

lv_style_t *get_style_face_ticks_ITEMS_DEFAULT() {
    static lv_style_t *style;
    if (!style) {
        style = (lv_style_t *)lv_malloc(sizeof(lv_style_t));
        lv_style_init(style);
        init_style_face_ticks_ITEMS_DEFAULT(style);
    }
    return style;
};

void init_style_face_ticks_INDICATOR_DEFAULT(lv_style_t *style) {
    lv_style_set_line_color(style, lv_color_hex(theme_colors[active_theme_index][8]));
    lv_style_set_line_width(style, 2);
    lv_style_set_line_opa(style, 255);
    lv_style_set_line_rounded(style, true);
    lv_style_set_length(style, 13);
};

lv_style_t *get_style_face_ticks_INDICATOR_DEFAULT() {
    static lv_style_t *style;
    if (!style) {
        style = (lv_style_t *)lv_malloc(sizeof(lv_style_t));
        lv_style_init(style);
        init_style_face_ticks_INDICATOR_DEFAULT(style);
    }
    return style;
};

void add_style_face_ticks(lv_obj_t *obj) {
    (void)obj;
    lv_obj_add_style(obj, get_style_face_ticks_MAIN_DEFAULT(), LV_PART_MAIN | LV_STATE_DEFAULT);
    lv_obj_add_style(obj, get_style_face_ticks_ITEMS_DEFAULT(), LV_PART_ITEMS | LV_STATE_DEFAULT);
    lv_obj_add_style(obj, get_style_face_ticks_INDICATOR_DEFAULT(), LV_PART_INDICATOR | LV_STATE_DEFAULT);
};

void remove_style_face_ticks(lv_obj_t *obj) {
    (void)obj;
    lv_obj_remove_style(obj, get_style_face_ticks_MAIN_DEFAULT(), LV_PART_MAIN | LV_STATE_DEFAULT);
    lv_obj_remove_style(obj, get_style_face_ticks_ITEMS_DEFAULT(), LV_PART_ITEMS | LV_STATE_DEFAULT);
    lv_obj_remove_style(obj, get_style_face_ticks_INDICATOR_DEFAULT(), LV_PART_INDICATOR | LV_STATE_DEFAULT);
};

//
// Style: FaceSecTicks
//

void init_style_face_sec_ticks_MAIN_DEFAULT(lv_style_t *style) {
    lv_style_set_arc_width(style, 0);
    lv_style_set_arc_opa(style, 0);
    lv_style_set_line_width(style, 0);
    lv_style_set_line_opa(style, 0);
    lv_style_set_bg_opa(style, 0);
    lv_style_set_border_width(style, 0);
    lv_style_set_pad_top(style, 0);
    lv_style_set_pad_bottom(style, 0);
    lv_style_set_pad_left(style, 0);
    lv_style_set_pad_right(style, 0);
};

lv_style_t *get_style_face_sec_ticks_MAIN_DEFAULT() {
    static lv_style_t *style;
    if (!style) {
        style = (lv_style_t *)lv_malloc(sizeof(lv_style_t));
        lv_style_init(style);
        init_style_face_sec_ticks_MAIN_DEFAULT(style);
    }
    return style;
};

void init_style_face_sec_ticks_ITEMS_DEFAULT(lv_style_t *style) {
    lv_style_set_line_color(style, lv_color_hex(theme_colors[active_theme_index][5]));
    lv_style_set_line_width(style, 2);
    lv_style_set_line_opa(style, 255);
    lv_style_set_line_rounded(style, true);
    lv_style_set_length(style, 5);
};

lv_style_t *get_style_face_sec_ticks_ITEMS_DEFAULT() {
    static lv_style_t *style;
    if (!style) {
        style = (lv_style_t *)lv_malloc(sizeof(lv_style_t));
        lv_style_init(style);
        init_style_face_sec_ticks_ITEMS_DEFAULT(style);
    }
    return style;
};

void init_style_face_sec_ticks_INDICATOR_DEFAULT(lv_style_t *style) {
    lv_style_set_line_color(style, lv_color_hex(theme_colors[active_theme_index][5]));
    lv_style_set_line_width(style, 2);
    lv_style_set_line_opa(style, 255);
    lv_style_set_line_rounded(style, true);
    lv_style_set_length(style, 9);
};

lv_style_t *get_style_face_sec_ticks_INDICATOR_DEFAULT() {
    static lv_style_t *style;
    if (!style) {
        style = (lv_style_t *)lv_malloc(sizeof(lv_style_t));
        lv_style_init(style);
        init_style_face_sec_ticks_INDICATOR_DEFAULT(style);
    }
    return style;
};

void add_style_face_sec_ticks(lv_obj_t *obj) {
    (void)obj;
    lv_obj_add_style(obj, get_style_face_sec_ticks_MAIN_DEFAULT(), LV_PART_MAIN | LV_STATE_DEFAULT);
    lv_obj_add_style(obj, get_style_face_sec_ticks_ITEMS_DEFAULT(), LV_PART_ITEMS | LV_STATE_DEFAULT);
    lv_obj_add_style(obj, get_style_face_sec_ticks_INDICATOR_DEFAULT(), LV_PART_INDICATOR | LV_STATE_DEFAULT);
};

void remove_style_face_sec_ticks(lv_obj_t *obj) {
    (void)obj;
    lv_obj_remove_style(obj, get_style_face_sec_ticks_MAIN_DEFAULT(), LV_PART_MAIN | LV_STATE_DEFAULT);
    lv_obj_remove_style(obj, get_style_face_sec_ticks_ITEMS_DEFAULT(), LV_PART_ITEMS | LV_STATE_DEFAULT);
    lv_obj_remove_style(obj, get_style_face_sec_ticks_INDICATOR_DEFAULT(), LV_PART_INDICATOR | LV_STATE_DEFAULT);
};

//
// Style: FaceSecOn
//

void init_style_face_sec_on_MAIN_DEFAULT(lv_style_t *style) {
};

lv_style_t *get_style_face_sec_on_MAIN_DEFAULT() {
    static lv_style_t *style;
    if (!style) {
        style = (lv_style_t *)lv_malloc(sizeof(lv_style_t));
        lv_style_init(style);
        init_style_face_sec_on_MAIN_DEFAULT(style);
    }
    return style;
};

void init_style_face_sec_on_ITEMS_DEFAULT(lv_style_t *style) {
    lv_style_set_line_color(style, lv_color_hex(theme_colors[active_theme_index][9]));
    lv_style_set_line_width(style, 2);
    lv_style_set_line_opa(style, 255);
};

lv_style_t *get_style_face_sec_on_ITEMS_DEFAULT() {
    static lv_style_t *style;
    if (!style) {
        style = (lv_style_t *)lv_malloc(sizeof(lv_style_t));
        lv_style_init(style);
        init_style_face_sec_on_ITEMS_DEFAULT(style);
    }
    return style;
};

void init_style_face_sec_on_INDICATOR_DEFAULT(lv_style_t *style) {
    lv_style_set_line_color(style, lv_color_hex(theme_colors[active_theme_index][9]));
    lv_style_set_line_width(style, 2);
    lv_style_set_line_opa(style, 255);
};

lv_style_t *get_style_face_sec_on_INDICATOR_DEFAULT() {
    static lv_style_t *style;
    if (!style) {
        style = (lv_style_t *)lv_malloc(sizeof(lv_style_t));
        lv_style_init(style);
        init_style_face_sec_on_INDICATOR_DEFAULT(style);
    }
    return style;
};

void add_style_face_sec_on(lv_obj_t *obj) {
    (void)obj;
    lv_obj_add_style(obj, get_style_face_sec_on_MAIN_DEFAULT(), LV_PART_MAIN | LV_STATE_DEFAULT);
    lv_obj_add_style(obj, get_style_face_sec_on_ITEMS_DEFAULT(), LV_PART_ITEMS | LV_STATE_DEFAULT);
    lv_obj_add_style(obj, get_style_face_sec_on_INDICATOR_DEFAULT(), LV_PART_INDICATOR | LV_STATE_DEFAULT);
};

void remove_style_face_sec_on(lv_obj_t *obj) {
    (void)obj;
    lv_obj_remove_style(obj, get_style_face_sec_on_MAIN_DEFAULT(), LV_PART_MAIN | LV_STATE_DEFAULT);
    lv_obj_remove_style(obj, get_style_face_sec_on_ITEMS_DEFAULT(), LV_PART_ITEMS | LV_STATE_DEFAULT);
    lv_obj_remove_style(obj, get_style_face_sec_on_INDICATOR_DEFAULT(), LV_PART_INDICATOR | LV_STATE_DEFAULT);
};

//
// Style: FaceHandH
//

void init_style_face_hand_h_MAIN_DEFAULT(lv_style_t *style) {
    lv_style_set_line_color(style, lv_color_hex(theme_colors[active_theme_index][7]));
    lv_style_set_line_width(style, 5);
    lv_style_set_line_opa(style, 255);
    lv_style_set_line_rounded(style, true);
};

lv_style_t *get_style_face_hand_h_MAIN_DEFAULT() {
    static lv_style_t *style;
    if (!style) {
        style = (lv_style_t *)lv_malloc(sizeof(lv_style_t));
        lv_style_init(style);
        init_style_face_hand_h_MAIN_DEFAULT(style);
    }
    return style;
};

void add_style_face_hand_h(lv_obj_t *obj) {
    (void)obj;
    lv_obj_add_style(obj, get_style_face_hand_h_MAIN_DEFAULT(), LV_PART_MAIN | LV_STATE_DEFAULT);
};

void remove_style_face_hand_h(lv_obj_t *obj) {
    (void)obj;
    lv_obj_remove_style(obj, get_style_face_hand_h_MAIN_DEFAULT(), LV_PART_MAIN | LV_STATE_DEFAULT);
};

//
// Style: FaceHandM
//

void init_style_face_hand_m_MAIN_DEFAULT(lv_style_t *style) {
    lv_style_set_line_color(style, lv_color_hex(theme_colors[active_theme_index][7]));
    lv_style_set_line_width(style, 3);
    lv_style_set_line_opa(style, 255);
    lv_style_set_line_rounded(style, true);
};

lv_style_t *get_style_face_hand_m_MAIN_DEFAULT() {
    static lv_style_t *style;
    if (!style) {
        style = (lv_style_t *)lv_malloc(sizeof(lv_style_t));
        lv_style_init(style);
        init_style_face_hand_m_MAIN_DEFAULT(style);
    }
    return style;
};

void add_style_face_hand_m(lv_obj_t *obj) {
    (void)obj;
    lv_obj_add_style(obj, get_style_face_hand_m_MAIN_DEFAULT(), LV_PART_MAIN | LV_STATE_DEFAULT);
};

void remove_style_face_hand_m(lv_obj_t *obj) {
    (void)obj;
    lv_obj_remove_style(obj, get_style_face_hand_m_MAIN_DEFAULT(), LV_PART_MAIN | LV_STATE_DEFAULT);
};

//
// Style: FaceHandS
//

void init_style_face_hand_s_MAIN_DEFAULT(lv_style_t *style) {
    lv_style_set_line_color(style, lv_color_hex(theme_colors[active_theme_index][9]));
    lv_style_set_line_width(style, 1);
    lv_style_set_line_opa(style, 255);
    lv_style_set_line_rounded(style, true);
};

lv_style_t *get_style_face_hand_s_MAIN_DEFAULT() {
    static lv_style_t *style;
    if (!style) {
        style = (lv_style_t *)lv_malloc(sizeof(lv_style_t));
        lv_style_init(style);
        init_style_face_hand_s_MAIN_DEFAULT(style);
    }
    return style;
};

void add_style_face_hand_s(lv_obj_t *obj) {
    (void)obj;
    lv_obj_add_style(obj, get_style_face_hand_s_MAIN_DEFAULT(), LV_PART_MAIN | LV_STATE_DEFAULT);
};

void remove_style_face_hand_s(lv_obj_t *obj) {
    (void)obj;
    lv_obj_remove_style(obj, get_style_face_hand_s_MAIN_DEFAULT(), LV_PART_MAIN | LV_STATE_DEFAULT);
};

//
// Style: FaceCap
//

void init_style_face_cap_MAIN_DEFAULT(lv_style_t *style) {
    lv_style_set_bg_color(style, lv_color_hex(theme_colors[active_theme_index][9]));
    lv_style_set_bg_opa(style, 255);
    lv_style_set_border_width(style, 0);
    lv_style_set_radius(style, 1000);
    lv_style_set_pad_top(style, 0);
    lv_style_set_pad_bottom(style, 0);
    lv_style_set_pad_left(style, 0);
    lv_style_set_pad_right(style, 0);
};

lv_style_t *get_style_face_cap_MAIN_DEFAULT() {
    static lv_style_t *style;
    if (!style) {
        style = (lv_style_t *)lv_malloc(sizeof(lv_style_t));
        lv_style_init(style);
        init_style_face_cap_MAIN_DEFAULT(style);
    }
    return style;
};

void add_style_face_cap(lv_obj_t *obj) {
    (void)obj;
    lv_obj_add_style(obj, get_style_face_cap_MAIN_DEFAULT(), LV_PART_MAIN | LV_STATE_DEFAULT);
};

void remove_style_face_cap(lv_obj_t *obj) {
    (void)obj;
    lv_obj_remove_style(obj, get_style_face_cap_MAIN_DEFAULT(), LV_PART_MAIN | LV_STATE_DEFAULT);
};

//
// Style: FaceCapIn
//

void init_style_face_cap_in_MAIN_DEFAULT(lv_style_t *style) {
    lv_style_set_bg_color(style, lv_color_hex(theme_colors[active_theme_index][1]));
    lv_style_set_bg_opa(style, 255);
    lv_style_set_border_width(style, 0);
    lv_style_set_radius(style, 1000);
    lv_style_set_pad_top(style, 0);
    lv_style_set_pad_bottom(style, 0);
    lv_style_set_pad_left(style, 0);
    lv_style_set_pad_right(style, 0);
};

lv_style_t *get_style_face_cap_in_MAIN_DEFAULT() {
    static lv_style_t *style;
    if (!style) {
        style = (lv_style_t *)lv_malloc(sizeof(lv_style_t));
        lv_style_init(style);
        init_style_face_cap_in_MAIN_DEFAULT(style);
    }
    return style;
};

void add_style_face_cap_in(lv_obj_t *obj) {
    (void)obj;
    lv_obj_add_style(obj, get_style_face_cap_in_MAIN_DEFAULT(), LV_PART_MAIN | LV_STATE_DEFAULT);
};

void remove_style_face_cap_in(lv_obj_t *obj) {
    (void)obj;
    lv_obj_remove_style(obj, get_style_face_cap_in_MAIN_DEFAULT(), LV_PART_MAIN | LV_STATE_DEFAULT);
};

//
// Style: FaceMinArc
//

void init_style_face_min_arc_MAIN_DEFAULT(lv_style_t *style) {
    lv_style_set_arc_color(style, lv_color_hex(theme_colors[active_theme_index][5]));
    lv_style_set_arc_width(style, 2);
    lv_style_set_arc_opa(style, 255);
    lv_style_set_arc_rounded(style, false);
    lv_style_set_bg_opa(style, 0);
    lv_style_set_border_width(style, 0);
    lv_style_set_pad_top(style, 0);
    lv_style_set_pad_bottom(style, 0);
    lv_style_set_pad_left(style, 0);
    lv_style_set_pad_right(style, 0);
};

lv_style_t *get_style_face_min_arc_MAIN_DEFAULT() {
    static lv_style_t *style;
    if (!style) {
        style = (lv_style_t *)lv_malloc(sizeof(lv_style_t));
        lv_style_init(style);
        init_style_face_min_arc_MAIN_DEFAULT(style);
    }
    return style;
};

void init_style_face_min_arc_INDICATOR_DEFAULT(lv_style_t *style) {
    lv_style_set_arc_color(style, lv_color_hex(theme_colors[active_theme_index][9]));
    lv_style_set_arc_width(style, 2);
    lv_style_set_arc_opa(style, 255);
    lv_style_set_arc_rounded(style, true);
};

lv_style_t *get_style_face_min_arc_INDICATOR_DEFAULT() {
    static lv_style_t *style;
    if (!style) {
        style = (lv_style_t *)lv_malloc(sizeof(lv_style_t));
        lv_style_init(style);
        init_style_face_min_arc_INDICATOR_DEFAULT(style);
    }
    return style;
};

void init_style_face_min_arc_KNOB_DEFAULT(lv_style_t *style) {
    lv_style_set_bg_color(style, lv_color_hex(theme_colors[active_theme_index][9]));
    lv_style_set_bg_opa(style, 255);
    lv_style_set_border_width(style, 0);
    lv_style_set_pad_top(style, 2);
    lv_style_set_pad_bottom(style, 2);
    lv_style_set_pad_left(style, 2);
    lv_style_set_pad_right(style, 2);
};

lv_style_t *get_style_face_min_arc_KNOB_DEFAULT() {
    static lv_style_t *style;
    if (!style) {
        style = (lv_style_t *)lv_malloc(sizeof(lv_style_t));
        lv_style_init(style);
        init_style_face_min_arc_KNOB_DEFAULT(style);
    }
    return style;
};

void add_style_face_min_arc(lv_obj_t *obj) {
    (void)obj;
    lv_obj_add_style(obj, get_style_face_min_arc_MAIN_DEFAULT(), LV_PART_MAIN | LV_STATE_DEFAULT);
    lv_obj_add_style(obj, get_style_face_min_arc_INDICATOR_DEFAULT(), LV_PART_INDICATOR | LV_STATE_DEFAULT);
    lv_obj_add_style(obj, get_style_face_min_arc_KNOB_DEFAULT(), LV_PART_KNOB | LV_STATE_DEFAULT);
};

void remove_style_face_min_arc(lv_obj_t *obj) {
    (void)obj;
    lv_obj_remove_style(obj, get_style_face_min_arc_MAIN_DEFAULT(), LV_PART_MAIN | LV_STATE_DEFAULT);
    lv_obj_remove_style(obj, get_style_face_min_arc_INDICATOR_DEFAULT(), LV_PART_INDICATOR | LV_STATE_DEFAULT);
    lv_obj_remove_style(obj, get_style_face_min_arc_KNOB_DEFAULT(), LV_PART_KNOB | LV_STATE_DEFAULT);
};

//
// Style: FaceRingArc
//

void init_style_face_ring_arc_MAIN_DEFAULT(lv_style_t *style) {
    lv_style_set_arc_color(style, lv_color_hex(theme_colors[active_theme_index][5]));
    lv_style_set_arc_width(style, 2);
    lv_style_set_arc_opa(style, 255);
    lv_style_set_arc_rounded(style, false);
    lv_style_set_bg_opa(style, 0);
    lv_style_set_border_width(style, 0);
    lv_style_set_pad_top(style, 0);
    lv_style_set_pad_bottom(style, 0);
    lv_style_set_pad_left(style, 0);
    lv_style_set_pad_right(style, 0);
};

lv_style_t *get_style_face_ring_arc_MAIN_DEFAULT() {
    static lv_style_t *style;
    if (!style) {
        style = (lv_style_t *)lv_malloc(sizeof(lv_style_t));
        lv_style_init(style);
        init_style_face_ring_arc_MAIN_DEFAULT(style);
    }
    return style;
};

void init_style_face_ring_arc_INDICATOR_DEFAULT(lv_style_t *style) {
    lv_style_set_arc_color(style, lv_color_hex(theme_colors[active_theme_index][9]));
    lv_style_set_arc_width(style, 4);
    lv_style_set_arc_opa(style, 255);
    lv_style_set_arc_rounded(style, true);
};

lv_style_t *get_style_face_ring_arc_INDICATOR_DEFAULT() {
    static lv_style_t *style;
    if (!style) {
        style = (lv_style_t *)lv_malloc(sizeof(lv_style_t));
        lv_style_init(style);
        init_style_face_ring_arc_INDICATOR_DEFAULT(style);
    }
    return style;
};

void init_style_face_ring_arc_KNOB_DEFAULT(lv_style_t *style) {
    lv_style_set_bg_color(style, lv_color_hex(theme_colors[active_theme_index][1]));
    lv_style_set_bg_opa(style, 255);
    lv_style_set_border_color(style, lv_color_hex(theme_colors[active_theme_index][9]));
    lv_style_set_border_width(style, 3);
    lv_style_set_border_opa(style, 255);
    lv_style_set_pad_top(style, 3);
    lv_style_set_pad_bottom(style, 3);
    lv_style_set_pad_left(style, 3);
    lv_style_set_pad_right(style, 3);
};

lv_style_t *get_style_face_ring_arc_KNOB_DEFAULT() {
    static lv_style_t *style;
    if (!style) {
        style = (lv_style_t *)lv_malloc(sizeof(lv_style_t));
        lv_style_init(style);
        init_style_face_ring_arc_KNOB_DEFAULT(style);
    }
    return style;
};

void add_style_face_ring_arc(lv_obj_t *obj) {
    (void)obj;
    lv_obj_add_style(obj, get_style_face_ring_arc_MAIN_DEFAULT(), LV_PART_MAIN | LV_STATE_DEFAULT);
    lv_obj_add_style(obj, get_style_face_ring_arc_INDICATOR_DEFAULT(), LV_PART_INDICATOR | LV_STATE_DEFAULT);
    lv_obj_add_style(obj, get_style_face_ring_arc_KNOB_DEFAULT(), LV_PART_KNOB | LV_STATE_DEFAULT);
};

void remove_style_face_ring_arc(lv_obj_t *obj) {
    (void)obj;
    lv_obj_remove_style(obj, get_style_face_ring_arc_MAIN_DEFAULT(), LV_PART_MAIN | LV_STATE_DEFAULT);
    lv_obj_remove_style(obj, get_style_face_ring_arc_INDICATOR_DEFAULT(), LV_PART_INDICATOR | LV_STATE_DEFAULT);
    lv_obj_remove_style(obj, get_style_face_ring_arc_KNOB_DEFAULT(), LV_PART_KNOB | LV_STATE_DEFAULT);
};

//
// Style: FaceTextLg
//

void init_style_face_text_lg_MAIN_DEFAULT(lv_style_t *style) {
    lv_style_set_text_color(style, lv_color_hex(theme_colors[active_theme_index][7]));
    lv_style_set_text_font(style, &ui_font_rr13);
};

lv_style_t *get_style_face_text_lg_MAIN_DEFAULT() {
    static lv_style_t *style;
    if (!style) {
        style = (lv_style_t *)lv_malloc(sizeof(lv_style_t));
        lv_style_init(style);
        init_style_face_text_lg_MAIN_DEFAULT(style);
    }
    return style;
};

void add_style_face_text_lg(lv_obj_t *obj) {
    (void)obj;
    lv_obj_add_style(obj, get_style_face_text_lg_MAIN_DEFAULT(), LV_PART_MAIN | LV_STATE_DEFAULT);
};

void remove_style_face_text_lg(lv_obj_t *obj) {
    (void)obj;
    lv_obj_remove_style(obj, get_style_face_text_lg_MAIN_DEFAULT(), LV_PART_MAIN | LV_STATE_DEFAULT);
};

//
// Style: FaceTextMd
//

void init_style_face_text_md_MAIN_DEFAULT(lv_style_t *style) {
    lv_style_set_text_color(style, lv_color_hex(theme_colors[active_theme_index][7]));
    lv_style_set_text_font(style, &ui_font_rr11);
};

lv_style_t *get_style_face_text_md_MAIN_DEFAULT() {
    static lv_style_t *style;
    if (!style) {
        style = (lv_style_t *)lv_malloc(sizeof(lv_style_t));
        lv_style_init(style);
        init_style_face_text_md_MAIN_DEFAULT(style);
    }
    return style;
};

void add_style_face_text_md(lv_obj_t *obj) {
    (void)obj;
    lv_obj_add_style(obj, get_style_face_text_md_MAIN_DEFAULT(), LV_PART_MAIN | LV_STATE_DEFAULT);
};

void remove_style_face_text_md(lv_obj_t *obj) {
    (void)obj;
    lv_obj_remove_style(obj, get_style_face_text_md_MAIN_DEFAULT(), LV_PART_MAIN | LV_STATE_DEFAULT);
};

//
// Style: FaceTextMuted
//

void init_style_face_text_muted_MAIN_DEFAULT(lv_style_t *style) {
    lv_style_set_text_color(style, lv_color_hex(theme_colors[active_theme_index][8]));
    lv_style_set_text_font(style, &ui_font_rr11);
};

lv_style_t *get_style_face_text_muted_MAIN_DEFAULT() {
    static lv_style_t *style;
    if (!style) {
        style = (lv_style_t *)lv_malloc(sizeof(lv_style_t));
        lv_style_init(style);
        init_style_face_text_muted_MAIN_DEFAULT(style);
    }
    return style;
};

void add_style_face_text_muted(lv_obj_t *obj) {
    (void)obj;
    lv_obj_add_style(obj, get_style_face_text_muted_MAIN_DEFAULT(), LV_PART_MAIN | LV_STATE_DEFAULT);
};

void remove_style_face_text_muted(lv_obj_t *obj) {
    (void)obj;
    lv_obj_remove_style(obj, get_style_face_text_muted_MAIN_DEFAULT(), LV_PART_MAIN | LV_STATE_DEFAULT);
};

//
// Style: FaceStat
//

void init_style_face_stat_MAIN_DEFAULT(lv_style_t *style) {
    lv_style_set_text_color(style, lv_color_hex(theme_colors[active_theme_index][8]));
    lv_style_set_text_font(style, &ui_font_rr13);
};

lv_style_t *get_style_face_stat_MAIN_DEFAULT() {
    static lv_style_t *style;
    if (!style) {
        style = (lv_style_t *)lv_malloc(sizeof(lv_style_t));
        lv_style_init(style);
        init_style_face_stat_MAIN_DEFAULT(style);
    }
    return style;
};

void add_style_face_stat(lv_obj_t *obj) {
    (void)obj;
    lv_obj_add_style(obj, get_style_face_stat_MAIN_DEFAULT(), LV_PART_MAIN | LV_STATE_DEFAULT);
};

void remove_style_face_stat(lv_obj_t *obj) {
    (void)obj;
    lv_obj_remove_style(obj, get_style_face_stat_MAIN_DEFAULT(), LV_PART_MAIN | LV_STATE_DEFAULT);
};

//
// Style: FaceStatIcon
//

void init_style_face_stat_icon_MAIN_DEFAULT(lv_style_t *style) {
    lv_style_set_text_color(style, lv_color_hex(theme_colors[active_theme_index][8]));
    lv_style_set_text_font(style, &ui_font_fa13);
};

lv_style_t *get_style_face_stat_icon_MAIN_DEFAULT() {
    static lv_style_t *style;
    if (!style) {
        style = (lv_style_t *)lv_malloc(sizeof(lv_style_t));
        lv_style_init(style);
        init_style_face_stat_icon_MAIN_DEFAULT(style);
    }
    return style;
};

void add_style_face_stat_icon(lv_obj_t *obj) {
    (void)obj;
    lv_obj_add_style(obj, get_style_face_stat_icon_MAIN_DEFAULT(), LV_PART_MAIN | LV_STATE_DEFAULT);
};

void remove_style_face_stat_icon(lv_obj_t *obj) {
    (void)obj;
    lv_obj_remove_style(obj, get_style_face_stat_icon_MAIN_DEFAULT(), LV_PART_MAIN | LV_STATE_DEFAULT);
};

//
// Style: FaceBrandName
//

void init_style_face_brand_name_MAIN_DEFAULT(lv_style_t *style) {
    lv_style_set_text_color(style, lv_color_hex(theme_colors[active_theme_index][7]));
    lv_style_set_text_font(style, &ui_font_rr13);
    lv_style_set_text_letter_space(style, 1);
};

lv_style_t *get_style_face_brand_name_MAIN_DEFAULT() {
    static lv_style_t *style;
    if (!style) {
        style = (lv_style_t *)lv_malloc(sizeof(lv_style_t));
        lv_style_init(style);
        init_style_face_brand_name_MAIN_DEFAULT(style);
    }
    return style;
};

void add_style_face_brand_name(lv_obj_t *obj) {
    (void)obj;
    lv_obj_add_style(obj, get_style_face_brand_name_MAIN_DEFAULT(), LV_PART_MAIN | LV_STATE_DEFAULT);
};

void remove_style_face_brand_name(lv_obj_t *obj) {
    (void)obj;
    lv_obj_remove_style(obj, get_style_face_brand_name_MAIN_DEFAULT(), LV_PART_MAIN | LV_STATE_DEFAULT);
};

//
// Style: FaceTime
//

void init_style_face_time_MAIN_DEFAULT(lv_style_t *style) {
    lv_style_set_text_color(style, lv_color_hex(theme_colors[active_theme_index][6]));
    lv_style_set_text_font(style, &ui_font_rn75);
    lv_style_set_text_letter_space(style, -2);
};

lv_style_t *get_style_face_time_MAIN_DEFAULT() {
    static lv_style_t *style;
    if (!style) {
        style = (lv_style_t *)lv_malloc(sizeof(lv_style_t));
        lv_style_init(style);
        init_style_face_time_MAIN_DEFAULT(style);
    }
    return style;
};

void add_style_face_time(lv_obj_t *obj) {
    (void)obj;
    lv_obj_add_style(obj, get_style_face_time_MAIN_DEFAULT(), LV_PART_MAIN | LV_STATE_DEFAULT);
};

void remove_style_face_time(lv_obj_t *obj) {
    (void)obj;
    lv_obj_remove_style(obj, get_style_face_time_MAIN_DEFAULT(), LV_PART_MAIN | LV_STATE_DEFAULT);
};

//
// Style: FaceTimeSm
//

void init_style_face_time_sm_MAIN_DEFAULT(lv_style_t *style) {
    lv_style_set_text_color(style, lv_color_hex(theme_colors[active_theme_index][6]));
    lv_style_set_text_font(style, &ui_font_rn60);
    lv_style_set_text_letter_space(style, -2);
};

lv_style_t *get_style_face_time_sm_MAIN_DEFAULT() {
    static lv_style_t *style;
    if (!style) {
        style = (lv_style_t *)lv_malloc(sizeof(lv_style_t));
        lv_style_init(style);
        init_style_face_time_sm_MAIN_DEFAULT(style);
    }
    return style;
};

void add_style_face_time_sm(lv_obj_t *obj) {
    (void)obj;
    lv_obj_add_style(obj, get_style_face_time_sm_MAIN_DEFAULT(), LV_PART_MAIN | LV_STATE_DEFAULT);
};

void remove_style_face_time_sm(lv_obj_t *obj) {
    (void)obj;
    lv_obj_remove_style(obj, get_style_face_time_sm_MAIN_DEFAULT(), LV_PART_MAIN | LV_STATE_DEFAULT);
};

//
// Style: FaceAmPm
//

void init_style_face_am_pm_MAIN_DEFAULT(lv_style_t *style) {
    lv_style_set_text_color(style, lv_color_hex(theme_colors[active_theme_index][8]));
    lv_style_set_text_font(style, &ui_font_rr13);
    lv_style_set_pad_top(style, 11);
};

lv_style_t *get_style_face_am_pm_MAIN_DEFAULT() {
    static lv_style_t *style;
    if (!style) {
        style = (lv_style_t *)lv_malloc(sizeof(lv_style_t));
        lv_style_init(style);
        init_style_face_am_pm_MAIN_DEFAULT(style);
    }
    return style;
};

void add_style_face_am_pm(lv_obj_t *obj) {
    (void)obj;
    lv_obj_add_style(obj, get_style_face_am_pm_MAIN_DEFAULT(), LV_PART_MAIN | LV_STATE_DEFAULT);
};

void remove_style_face_am_pm(lv_obj_t *obj) {
    (void)obj;
    lv_obj_remove_style(obj, get_style_face_am_pm_MAIN_DEFAULT(), LV_PART_MAIN | LV_STATE_DEFAULT);
};

//
// Style: FaceAmPmSm
//

void init_style_face_am_pm_sm_MAIN_DEFAULT(lv_style_t *style) {
    lv_style_set_text_color(style, lv_color_hex(theme_colors[active_theme_index][8]));
    lv_style_set_text_font(style, &ui_font_rr13);
    lv_style_set_pad_top(style, 8);
};

lv_style_t *get_style_face_am_pm_sm_MAIN_DEFAULT() {
    static lv_style_t *style;
    if (!style) {
        style = (lv_style_t *)lv_malloc(sizeof(lv_style_t));
        lv_style_init(style);
        init_style_face_am_pm_sm_MAIN_DEFAULT(style);
    }
    return style;
};

void add_style_face_am_pm_sm(lv_obj_t *obj) {
    (void)obj;
    lv_obj_add_style(obj, get_style_face_am_pm_sm_MAIN_DEFAULT(), LV_PART_MAIN | LV_STATE_DEFAULT);
};

void remove_style_face_am_pm_sm(lv_obj_t *obj) {
    (void)obj;
    lv_obj_remove_style(obj, get_style_face_am_pm_sm_MAIN_DEFAULT(), LV_PART_MAIN | LV_STATE_DEFAULT);
};

//
// Style: FaceRingTime
//

void init_style_face_ring_time_MAIN_DEFAULT(lv_style_t *style) {
    lv_style_set_text_color(style, lv_color_hex(theme_colors[active_theme_index][7]));
    lv_style_set_text_font(style, &ui_font_rr13);
};

lv_style_t *get_style_face_ring_time_MAIN_DEFAULT() {
    static lv_style_t *style;
    if (!style) {
        style = (lv_style_t *)lv_malloc(sizeof(lv_style_t));
        lv_style_init(style);
        init_style_face_ring_time_MAIN_DEFAULT(style);
    }
    return style;
};

void add_style_face_ring_time(lv_obj_t *obj) {
    (void)obj;
    lv_obj_add_style(obj, get_style_face_ring_time_MAIN_DEFAULT(), LV_PART_MAIN | LV_STATE_DEFAULT);
};

void remove_style_face_ring_time(lv_obj_t *obj) {
    (void)obj;
    lv_obj_remove_style(obj, get_style_face_ring_time_MAIN_DEFAULT(), LV_PART_MAIN | LV_STATE_DEFAULT);
};

//
// Style: FaceMode
//

void init_style_face_mode_MAIN_DEFAULT(lv_style_t *style) {
    lv_style_set_text_color(style, lv_color_hex(theme_colors[active_theme_index][28]));
    lv_style_set_text_font(style, &ui_font_rr13);
};

lv_style_t *get_style_face_mode_MAIN_DEFAULT() {
    static lv_style_t *style;
    if (!style) {
        style = (lv_style_t *)lv_malloc(sizeof(lv_style_t));
        lv_style_init(style);
        init_style_face_mode_MAIN_DEFAULT(style);
    }
    return style;
};

void init_style_face_mode_MAIN_CHECKED(lv_style_t *style) {
    lv_style_set_text_color(style, lv_color_hex(theme_colors[active_theme_index][31]));
};

lv_style_t *get_style_face_mode_MAIN_CHECKED() {
    static lv_style_t *style;
    if (!style) {
        style = (lv_style_t *)lv_malloc(sizeof(lv_style_t));
        lv_style_init(style);
        init_style_face_mode_MAIN_CHECKED(style);
    }
    return style;
};

void init_style_face_mode_MAIN_PRESSED(lv_style_t *style) {
    lv_style_set_text_color(style, lv_color_hex(theme_colors[active_theme_index][30]));
};

lv_style_t *get_style_face_mode_MAIN_PRESSED() {
    static lv_style_t *style;
    if (!style) {
        style = (lv_style_t *)lv_malloc(sizeof(lv_style_t));
        lv_style_init(style);
        init_style_face_mode_MAIN_PRESSED(style);
    }
    return style;
};

void init_style_face_mode_MAIN_DISABLED(lv_style_t *style) {
    lv_style_set_text_color(style, lv_color_hex(theme_colors[active_theme_index][8]));
};

lv_style_t *get_style_face_mode_MAIN_DISABLED() {
    static lv_style_t *style;
    if (!style) {
        style = (lv_style_t *)lv_malloc(sizeof(lv_style_t));
        lv_style_init(style);
        init_style_face_mode_MAIN_DISABLED(style);
    }
    return style;
};

void add_style_face_mode(lv_obj_t *obj) {
    (void)obj;
    lv_obj_add_style(obj, get_style_face_mode_MAIN_DEFAULT(), LV_PART_MAIN | LV_STATE_DEFAULT);
    lv_obj_add_style(obj, get_style_face_mode_MAIN_CHECKED(), LV_PART_MAIN | LV_STATE_CHECKED);
    lv_obj_add_style(obj, get_style_face_mode_MAIN_PRESSED(), LV_PART_MAIN | LV_STATE_PRESSED);
    lv_obj_add_style(obj, get_style_face_mode_MAIN_DISABLED(), LV_PART_MAIN | LV_STATE_DISABLED);
};

void remove_style_face_mode(lv_obj_t *obj) {
    (void)obj;
    lv_obj_remove_style(obj, get_style_face_mode_MAIN_DEFAULT(), LV_PART_MAIN | LV_STATE_DEFAULT);
    lv_obj_remove_style(obj, get_style_face_mode_MAIN_CHECKED(), LV_PART_MAIN | LV_STATE_CHECKED);
    lv_obj_remove_style(obj, get_style_face_mode_MAIN_PRESSED(), LV_PART_MAIN | LV_STATE_PRESSED);
    lv_obj_remove_style(obj, get_style_face_mode_MAIN_DISABLED(), LV_PART_MAIN | LV_STATE_DISABLED);
};

//
// Style: FaceModeIcon
//

void init_style_face_mode_icon_MAIN_DEFAULT(lv_style_t *style) {
    lv_style_set_text_color(style, lv_color_hex(theme_colors[active_theme_index][28]));
    lv_style_set_text_font(style, &ui_font_fa13);
};

lv_style_t *get_style_face_mode_icon_MAIN_DEFAULT() {
    static lv_style_t *style;
    if (!style) {
        style = (lv_style_t *)lv_malloc(sizeof(lv_style_t));
        lv_style_init(style);
        init_style_face_mode_icon_MAIN_DEFAULT(style);
    }
    return style;
};

void init_style_face_mode_icon_MAIN_CHECKED(lv_style_t *style) {
    lv_style_set_text_color(style, lv_color_hex(theme_colors[active_theme_index][31]));
};

lv_style_t *get_style_face_mode_icon_MAIN_CHECKED() {
    static lv_style_t *style;
    if (!style) {
        style = (lv_style_t *)lv_malloc(sizeof(lv_style_t));
        lv_style_init(style);
        init_style_face_mode_icon_MAIN_CHECKED(style);
    }
    return style;
};

void init_style_face_mode_icon_MAIN_PRESSED(lv_style_t *style) {
    lv_style_set_text_color(style, lv_color_hex(theme_colors[active_theme_index][30]));
};

lv_style_t *get_style_face_mode_icon_MAIN_PRESSED() {
    static lv_style_t *style;
    if (!style) {
        style = (lv_style_t *)lv_malloc(sizeof(lv_style_t));
        lv_style_init(style);
        init_style_face_mode_icon_MAIN_PRESSED(style);
    }
    return style;
};

void init_style_face_mode_icon_MAIN_DISABLED(lv_style_t *style) {
    lv_style_set_text_color(style, lv_color_hex(theme_colors[active_theme_index][8]));
};

lv_style_t *get_style_face_mode_icon_MAIN_DISABLED() {
    static lv_style_t *style;
    if (!style) {
        style = (lv_style_t *)lv_malloc(sizeof(lv_style_t));
        lv_style_init(style);
        init_style_face_mode_icon_MAIN_DISABLED(style);
    }
    return style;
};

void add_style_face_mode_icon(lv_obj_t *obj) {
    (void)obj;
    lv_obj_add_style(obj, get_style_face_mode_icon_MAIN_DEFAULT(), LV_PART_MAIN | LV_STATE_DEFAULT);
    lv_obj_add_style(obj, get_style_face_mode_icon_MAIN_CHECKED(), LV_PART_MAIN | LV_STATE_CHECKED);
    lv_obj_add_style(obj, get_style_face_mode_icon_MAIN_PRESSED(), LV_PART_MAIN | LV_STATE_PRESSED);
    lv_obj_add_style(obj, get_style_face_mode_icon_MAIN_DISABLED(), LV_PART_MAIN | LV_STATE_DISABLED);
};

void remove_style_face_mode_icon(lv_obj_t *obj) {
    (void)obj;
    lv_obj_remove_style(obj, get_style_face_mode_icon_MAIN_DEFAULT(), LV_PART_MAIN | LV_STATE_DEFAULT);
    lv_obj_remove_style(obj, get_style_face_mode_icon_MAIN_CHECKED(), LV_PART_MAIN | LV_STATE_CHECKED);
    lv_obj_remove_style(obj, get_style_face_mode_icon_MAIN_PRESSED(), LV_PART_MAIN | LV_STATE_PRESSED);
    lv_obj_remove_style(obj, get_style_face_mode_icon_MAIN_DISABLED(), LV_PART_MAIN | LV_STATE_DISABLED);
};

//
// Style: FaceHourNum
//

void init_style_face_hour_num_MAIN_DEFAULT(lv_style_t *style) {
    lv_style_set_text_color(style, lv_color_hex(theme_colors[active_theme_index][8]));
    lv_style_set_text_font(style, &ui_font_rr13);
    lv_style_set_text_align(style, LV_TEXT_ALIGN_CENTER);
};

lv_style_t *get_style_face_hour_num_MAIN_DEFAULT() {
    static lv_style_t *style;
    if (!style) {
        style = (lv_style_t *)lv_malloc(sizeof(lv_style_t));
        lv_style_init(style);
        init_style_face_hour_num_MAIN_DEFAULT(style);
    }
    return style;
};

void init_style_face_hour_num_MAIN_CHECKED(lv_style_t *style) {
    lv_style_set_text_color(style, lv_color_hex(theme_colors[active_theme_index][6]));
    lv_style_set_text_font(style, &ui_font_rm15);
};

lv_style_t *get_style_face_hour_num_MAIN_CHECKED() {
    static lv_style_t *style;
    if (!style) {
        style = (lv_style_t *)lv_malloc(sizeof(lv_style_t));
        lv_style_init(style);
        init_style_face_hour_num_MAIN_CHECKED(style);
    }
    return style;
};

void add_style_face_hour_num(lv_obj_t *obj) {
    (void)obj;
    lv_obj_add_style(obj, get_style_face_hour_num_MAIN_DEFAULT(), LV_PART_MAIN | LV_STATE_DEFAULT);
    lv_obj_add_style(obj, get_style_face_hour_num_MAIN_CHECKED(), LV_PART_MAIN | LV_STATE_CHECKED);
};

void remove_style_face_hour_num(lv_obj_t *obj) {
    (void)obj;
    lv_obj_remove_style(obj, get_style_face_hour_num_MAIN_DEFAULT(), LV_PART_MAIN | LV_STATE_DEFAULT);
    lv_obj_remove_style(obj, get_style_face_hour_num_MAIN_CHECKED(), LV_PART_MAIN | LV_STATE_CHECKED);
};

//
// Style: FacePreview
//

void init_style_face_preview_MAIN_DEFAULT(lv_style_t *style) {
    lv_style_set_bg_color(style, lv_color_hex(theme_colors[active_theme_index][1]));
    lv_style_set_bg_opa(style, 255);
    lv_style_set_border_color(style, lv_color_hex(theme_colors[active_theme_index][5]));
    lv_style_set_border_width(style, 2);
    lv_style_set_border_opa(style, 255);
    lv_style_set_radius(style, 1000);
    lv_style_set_pad_top(style, 0);
    lv_style_set_pad_bottom(style, 0);
    lv_style_set_pad_left(style, 0);
    lv_style_set_pad_right(style, 0);
};

lv_style_t *get_style_face_preview_MAIN_DEFAULT() {
    static lv_style_t *style;
    if (!style) {
        style = (lv_style_t *)lv_malloc(sizeof(lv_style_t));
        lv_style_init(style);
        init_style_face_preview_MAIN_DEFAULT(style);
    }
    return style;
};

void add_style_face_preview(lv_obj_t *obj) {
    (void)obj;
    lv_obj_add_style(obj, get_style_face_preview_MAIN_DEFAULT(), LV_PART_MAIN | LV_STATE_DEFAULT);
};

void remove_style_face_preview(lv_obj_t *obj) {
    (void)obj;
    lv_obj_remove_style(obj, get_style_face_preview_MAIN_DEFAULT(), LV_PART_MAIN | LV_STATE_DEFAULT);
};

//
// Style: FaceScaled
//

void init_style_face_scaled_MAIN_DEFAULT(lv_style_t *style) {
    lv_style_set_bg_opa(style, 0);
    lv_style_set_border_width(style, 0);
    lv_style_set_pad_top(style, 0);
    lv_style_set_pad_bottom(style, 0);
    lv_style_set_pad_left(style, 0);
    lv_style_set_pad_right(style, 0);
    lv_style_set_transform_scale_x(style, 149);
    lv_style_set_transform_scale_y(style, 149);
    lv_style_set_transform_pivot_x(style, 0);
    lv_style_set_transform_pivot_y(style, 0);
};

lv_style_t *get_style_face_scaled_MAIN_DEFAULT() {
    static lv_style_t *style;
    if (!style) {
        style = (lv_style_t *)lv_malloc(sizeof(lv_style_t));
        lv_style_init(style);
        init_style_face_scaled_MAIN_DEFAULT(style);
    }
    return style;
};

void add_style_face_scaled(lv_obj_t *obj) {
    (void)obj;
    lv_obj_add_style(obj, get_style_face_scaled_MAIN_DEFAULT(), LV_PART_MAIN | LV_STATE_DEFAULT);
};

void remove_style_face_scaled(lv_obj_t *obj) {
    (void)obj;
    lv_obj_remove_style(obj, get_style_face_scaled_MAIN_DEFAULT(), LV_PART_MAIN | LV_STATE_DEFAULT);
};

//
// Style: FacePickSub
//

void init_style_face_pick_sub_MAIN_DEFAULT(lv_style_t *style) {
    lv_style_set_text_color(style, lv_color_hex(theme_colors[active_theme_index][8]));
    lv_style_set_text_font(style, &ui_font_rr13);
};

lv_style_t *get_style_face_pick_sub_MAIN_DEFAULT() {
    static lv_style_t *style;
    if (!style) {
        style = (lv_style_t *)lv_malloc(sizeof(lv_style_t));
        lv_style_init(style);
        init_style_face_pick_sub_MAIN_DEFAULT(style);
    }
    return style;
};

void init_style_face_pick_sub_MAIN_CHECKED(lv_style_t *style) {
    lv_style_set_text_color(style, lv_color_hex(theme_colors[active_theme_index][28]));
};

lv_style_t *get_style_face_pick_sub_MAIN_CHECKED() {
    static lv_style_t *style;
    if (!style) {
        style = (lv_style_t *)lv_malloc(sizeof(lv_style_t));
        lv_style_init(style);
        init_style_face_pick_sub_MAIN_CHECKED(style);
    }
    return style;
};

void add_style_face_pick_sub(lv_obj_t *obj) {
    (void)obj;
    lv_obj_add_style(obj, get_style_face_pick_sub_MAIN_DEFAULT(), LV_PART_MAIN | LV_STATE_DEFAULT);
    lv_obj_add_style(obj, get_style_face_pick_sub_MAIN_CHECKED(), LV_PART_MAIN | LV_STATE_CHECKED);
};

void remove_style_face_pick_sub(lv_obj_t *obj) {
    (void)obj;
    lv_obj_remove_style(obj, get_style_face_pick_sub_MAIN_DEFAULT(), LV_PART_MAIN | LV_STATE_DEFAULT);
    lv_obj_remove_style(obj, get_style_face_pick_sub_MAIN_CHECKED(), LV_PART_MAIN | LV_STATE_CHECKED);
};

//
// Style: MenuName
//

void init_style_menu_name_MAIN_DEFAULT(lv_style_t *style) {
    lv_style_set_text_color(style, lv_color_hex(theme_colors[active_theme_index][6]));
    lv_style_set_text_font(style, &ui_font_rm17);
};

lv_style_t *get_style_menu_name_MAIN_DEFAULT() {
    static lv_style_t *style;
    if (!style) {
        style = (lv_style_t *)lv_malloc(sizeof(lv_style_t));
        lv_style_init(style);
        init_style_menu_name_MAIN_DEFAULT(style);
    }
    return style;
};

void add_style_menu_name(lv_obj_t *obj) {
    (void)obj;
    lv_obj_add_style(obj, get_style_menu_name_MAIN_DEFAULT(), LV_PART_MAIN | LV_STATE_DEFAULT);
};

void remove_style_menu_name(lv_obj_t *obj) {
    (void)obj;
    lv_obj_remove_style(obj, get_style_menu_name_MAIN_DEFAULT(), LV_PART_MAIN | LV_STATE_DEFAULT);
};

//
// Style: MenuSummary
//

void init_style_menu_summary_MAIN_DEFAULT(lv_style_t *style) {
    lv_style_set_text_color(style, lv_color_hex(theme_colors[active_theme_index][7]));
    lv_style_set_text_font(style, &ui_font_rr13);
};

lv_style_t *get_style_menu_summary_MAIN_DEFAULT() {
    static lv_style_t *style;
    if (!style) {
        style = (lv_style_t *)lv_malloc(sizeof(lv_style_t));
        lv_style_init(style);
        init_style_menu_summary_MAIN_DEFAULT(style);
    }
    return style;
};

void add_style_menu_summary(lv_obj_t *obj) {
    (void)obj;
    lv_obj_add_style(obj, get_style_menu_summary_MAIN_DEFAULT(), LV_PART_MAIN | LV_STATE_DEFAULT);
};

void remove_style_menu_summary(lv_obj_t *obj) {
    (void)obj;
    lv_obj_remove_style(obj, get_style_menu_summary_MAIN_DEFAULT(), LV_PART_MAIN | LV_STATE_DEFAULT);
};

//
// Style: ModeRowHeat
//

void init_style_mode_row_heat_MAIN_DEFAULT(lv_style_t *style) {
    lv_style_set_bg_opa(style, 0);
    lv_style_set_border_color(style, lv_color_hex(theme_colors[active_theme_index][5]));
    lv_style_set_border_width(style, 2);
    lv_style_set_border_opa(style, 255);
    lv_style_set_radius(style, 6);
    lv_style_set_text_color(style, lv_color_hex(theme_colors[active_theme_index][8]));
    lv_style_set_pad_top(style, 0);
    lv_style_set_pad_bottom(style, 0);
    lv_style_set_pad_left(style, 0);
    lv_style_set_pad_right(style, 0);
};

lv_style_t *get_style_mode_row_heat_MAIN_DEFAULT() {
    static lv_style_t *style;
    if (!style) {
        style = (lv_style_t *)lv_malloc(sizeof(lv_style_t));
        lv_style_init(style);
        init_style_mode_row_heat_MAIN_DEFAULT(style);
    }
    return style;
};

void init_style_mode_row_heat_MAIN_CHECKED(lv_style_t *style) {
    lv_style_set_bg_color(style, lv_color_hex(theme_colors[active_theme_index][2]));
    lv_style_set_bg_opa(style, 255);
    lv_style_set_border_color(style, lv_color_hex(theme_colors[active_theme_index][14]));
    lv_style_set_text_color(style, lv_color_hex(theme_colors[active_theme_index][31]));
};

lv_style_t *get_style_mode_row_heat_MAIN_CHECKED() {
    static lv_style_t *style;
    if (!style) {
        style = (lv_style_t *)lv_malloc(sizeof(lv_style_t));
        lv_style_init(style);
        init_style_mode_row_heat_MAIN_CHECKED(style);
    }
    return style;
};

void add_style_mode_row_heat(lv_obj_t *obj) {
    (void)obj;
    lv_obj_add_style(obj, get_style_mode_row_heat_MAIN_DEFAULT(), LV_PART_MAIN | LV_STATE_DEFAULT);
    lv_obj_add_style(obj, get_style_mode_row_heat_MAIN_CHECKED(), LV_PART_MAIN | LV_STATE_CHECKED);
};

void remove_style_mode_row_heat(lv_obj_t *obj) {
    (void)obj;
    lv_obj_remove_style(obj, get_style_mode_row_heat_MAIN_DEFAULT(), LV_PART_MAIN | LV_STATE_DEFAULT);
    lv_obj_remove_style(obj, get_style_mode_row_heat_MAIN_CHECKED(), LV_PART_MAIN | LV_STATE_CHECKED);
};

//
// Style: ModeRowCool
//

void init_style_mode_row_cool_MAIN_DEFAULT(lv_style_t *style) {
    lv_style_set_bg_opa(style, 0);
    lv_style_set_border_color(style, lv_color_hex(theme_colors[active_theme_index][5]));
    lv_style_set_border_width(style, 2);
    lv_style_set_border_opa(style, 255);
    lv_style_set_radius(style, 6);
    lv_style_set_text_color(style, lv_color_hex(theme_colors[active_theme_index][8]));
    lv_style_set_pad_top(style, 0);
    lv_style_set_pad_bottom(style, 0);
    lv_style_set_pad_left(style, 0);
    lv_style_set_pad_right(style, 0);
};

lv_style_t *get_style_mode_row_cool_MAIN_DEFAULT() {
    static lv_style_t *style;
    if (!style) {
        style = (lv_style_t *)lv_malloc(sizeof(lv_style_t));
        lv_style_init(style);
        init_style_mode_row_cool_MAIN_DEFAULT(style);
    }
    return style;
};

void init_style_mode_row_cool_MAIN_CHECKED(lv_style_t *style) {
    lv_style_set_bg_color(style, lv_color_hex(theme_colors[active_theme_index][2]));
    lv_style_set_bg_opa(style, 255);
    lv_style_set_border_color(style, lv_color_hex(theme_colors[active_theme_index][13]));
    lv_style_set_text_color(style, lv_color_hex(theme_colors[active_theme_index][30]));
};

lv_style_t *get_style_mode_row_cool_MAIN_CHECKED() {
    static lv_style_t *style;
    if (!style) {
        style = (lv_style_t *)lv_malloc(sizeof(lv_style_t));
        lv_style_init(style);
        init_style_mode_row_cool_MAIN_CHECKED(style);
    }
    return style;
};

void add_style_mode_row_cool(lv_obj_t *obj) {
    (void)obj;
    lv_obj_add_style(obj, get_style_mode_row_cool_MAIN_DEFAULT(), LV_PART_MAIN | LV_STATE_DEFAULT);
    lv_obj_add_style(obj, get_style_mode_row_cool_MAIN_CHECKED(), LV_PART_MAIN | LV_STATE_CHECKED);
};

void remove_style_mode_row_cool(lv_obj_t *obj) {
    (void)obj;
    lv_obj_remove_style(obj, get_style_mode_row_cool_MAIN_DEFAULT(), LV_PART_MAIN | LV_STATE_DEFAULT);
    lv_obj_remove_style(obj, get_style_mode_row_cool_MAIN_CHECKED(), LV_PART_MAIN | LV_STATE_CHECKED);
};

//
// Style: ModeRowAuto
//

void init_style_mode_row_auto_MAIN_DEFAULT(lv_style_t *style) {
    lv_style_set_bg_opa(style, 0);
    lv_style_set_border_color(style, lv_color_hex(theme_colors[active_theme_index][5]));
    lv_style_set_border_width(style, 2);
    lv_style_set_border_opa(style, 255);
    lv_style_set_radius(style, 6);
    lv_style_set_text_color(style, lv_color_hex(theme_colors[active_theme_index][8]));
    lv_style_set_pad_top(style, 0);
    lv_style_set_pad_bottom(style, 0);
    lv_style_set_pad_left(style, 0);
    lv_style_set_pad_right(style, 0);
};

lv_style_t *get_style_mode_row_auto_MAIN_DEFAULT() {
    static lv_style_t *style;
    if (!style) {
        style = (lv_style_t *)lv_malloc(sizeof(lv_style_t));
        lv_style_init(style);
        init_style_mode_row_auto_MAIN_DEFAULT(style);
    }
    return style;
};

void init_style_mode_row_auto_MAIN_CHECKED(lv_style_t *style) {
    lv_style_set_bg_color(style, lv_color_hex(theme_colors[active_theme_index][2]));
    lv_style_set_bg_opa(style, 255);
    lv_style_set_border_color(style, lv_color_hex(theme_colors[active_theme_index][9]));
    lv_style_set_text_color(style, lv_color_hex(theme_colors[active_theme_index][28]));
};

lv_style_t *get_style_mode_row_auto_MAIN_CHECKED() {
    static lv_style_t *style;
    if (!style) {
        style = (lv_style_t *)lv_malloc(sizeof(lv_style_t));
        lv_style_init(style);
        init_style_mode_row_auto_MAIN_CHECKED(style);
    }
    return style;
};

void add_style_mode_row_auto(lv_obj_t *obj) {
    (void)obj;
    lv_obj_add_style(obj, get_style_mode_row_auto_MAIN_DEFAULT(), LV_PART_MAIN | LV_STATE_DEFAULT);
    lv_obj_add_style(obj, get_style_mode_row_auto_MAIN_CHECKED(), LV_PART_MAIN | LV_STATE_CHECKED);
};

void remove_style_mode_row_auto(lv_obj_t *obj) {
    (void)obj;
    lv_obj_remove_style(obj, get_style_mode_row_auto_MAIN_DEFAULT(), LV_PART_MAIN | LV_STATE_DEFAULT);
    lv_obj_remove_style(obj, get_style_mode_row_auto_MAIN_CHECKED(), LV_PART_MAIN | LV_STATE_CHECKED);
};

//
// Style: ModeRowOff
//

void init_style_mode_row_off_MAIN_DEFAULT(lv_style_t *style) {
    lv_style_set_bg_opa(style, 0);
    lv_style_set_border_color(style, lv_color_hex(theme_colors[active_theme_index][5]));
    lv_style_set_border_width(style, 2);
    lv_style_set_border_opa(style, 255);
    lv_style_set_radius(style, 6);
    lv_style_set_text_color(style, lv_color_hex(theme_colors[active_theme_index][8]));
    lv_style_set_pad_top(style, 0);
    lv_style_set_pad_bottom(style, 0);
    lv_style_set_pad_left(style, 0);
    lv_style_set_pad_right(style, 0);
};

lv_style_t *get_style_mode_row_off_MAIN_DEFAULT() {
    static lv_style_t *style;
    if (!style) {
        style = (lv_style_t *)lv_malloc(sizeof(lv_style_t));
        lv_style_init(style);
        init_style_mode_row_off_MAIN_DEFAULT(style);
    }
    return style;
};

void init_style_mode_row_off_MAIN_CHECKED(lv_style_t *style) {
    lv_style_set_bg_color(style, lv_color_hex(theme_colors[active_theme_index][2]));
    lv_style_set_bg_opa(style, 255);
    lv_style_set_border_color(style, lv_color_hex(theme_colors[active_theme_index][7]));
    lv_style_set_text_color(style, lv_color_hex(theme_colors[active_theme_index][7]));
};

lv_style_t *get_style_mode_row_off_MAIN_CHECKED() {
    static lv_style_t *style;
    if (!style) {
        style = (lv_style_t *)lv_malloc(sizeof(lv_style_t));
        lv_style_init(style);
        init_style_mode_row_off_MAIN_CHECKED(style);
    }
    return style;
};

void add_style_mode_row_off(lv_obj_t *obj) {
    (void)obj;
    lv_obj_add_style(obj, get_style_mode_row_off_MAIN_DEFAULT(), LV_PART_MAIN | LV_STATE_DEFAULT);
    lv_obj_add_style(obj, get_style_mode_row_off_MAIN_CHECKED(), LV_PART_MAIN | LV_STATE_CHECKED);
};

void remove_style_mode_row_off(lv_obj_t *obj) {
    (void)obj;
    lv_obj_remove_style(obj, get_style_mode_row_off_MAIN_DEFAULT(), LV_PART_MAIN | LV_STATE_DEFAULT);
    lv_obj_remove_style(obj, get_style_mode_row_off_MAIN_CHECKED(), LV_PART_MAIN | LV_STATE_CHECKED);
};

//
// Style: ModeRowIcon
//

void init_style_mode_row_icon_MAIN_DEFAULT(lv_style_t *style) {
    lv_style_set_text_font(style, &ui_font_fa16);
    lv_style_set_text_align(style, LV_TEXT_ALIGN_CENTER);
};

lv_style_t *get_style_mode_row_icon_MAIN_DEFAULT() {
    static lv_style_t *style;
    if (!style) {
        style = (lv_style_t *)lv_malloc(sizeof(lv_style_t));
        lv_style_init(style);
        init_style_mode_row_icon_MAIN_DEFAULT(style);
    }
    return style;
};

void add_style_mode_row_icon(lv_obj_t *obj) {
    (void)obj;
    lv_obj_add_style(obj, get_style_mode_row_icon_MAIN_DEFAULT(), LV_PART_MAIN | LV_STATE_DEFAULT);
};

void remove_style_mode_row_icon(lv_obj_t *obj) {
    (void)obj;
    lv_obj_remove_style(obj, get_style_mode_row_icon_MAIN_DEFAULT(), LV_PART_MAIN | LV_STATE_DEFAULT);
};

//
// Style: ModeRowText
//

void init_style_mode_row_text_MAIN_DEFAULT(lv_style_t *style) {
    lv_style_set_text_font(style, &ui_font_rr13);
};

lv_style_t *get_style_mode_row_text_MAIN_DEFAULT() {
    static lv_style_t *style;
    if (!style) {
        style = (lv_style_t *)lv_malloc(sizeof(lv_style_t));
        lv_style_init(style);
        init_style_mode_row_text_MAIN_DEFAULT(style);
    }
    return style;
};
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
