trailcurrentoss/TrailCurrentCapstan/main/ui/240/styles.h

#ifndef EEZ_LVGL_UI_STYLES_H
#define EEZ_LVGL_UI_STYLES_H

#include <lvgl.h>

#ifdef __cplusplus
extern "C" {
#endif

// Style: ScreenRoot
lv_style_t *get_style_screen_root_MAIN_DEFAULT();
void add_style_screen_root(lv_obj_t *obj);
void remove_style_screen_root(lv_obj_t *obj);

// Style: Card
lv_style_t *get_style_card_MAIN_DEFAULT();
lv_style_t *get_style_card_MAIN_CHECKED();
void add_style_card(lv_obj_t *obj);
void remove_style_card(lv_obj_t *obj);

// Style: CardSelected
lv_style_t *get_style_card_selected_MAIN_DEFAULT();
void add_style_card_selected(lv_obj_t *obj);
void remove_style_card_selected(lv_obj_t *obj);

// Style: LabelTitle
lv_style_t *get_style_label_title_MAIN_DEFAULT();
void add_style_label_title(lv_obj_t *obj);
void remove_style_label_title(lv_obj_t *obj);

// Style: LabelBody
lv_style_t *get_style_label_body_MAIN_DEFAULT();
void add_style_label_body(lv_obj_t *obj);
void remove_style_label_body(lv_obj_t *obj);

// Style: LabelMuted
lv_style_t *get_style_label_muted_MAIN_DEFAULT();
void add_style_label_muted(lv_obj_t *obj);
void remove_style_label_muted(lv_obj_t *obj);

// Style: LabelHero
lv_style_t *get_style_label_hero_MAIN_DEFAULT();
void add_style_label_hero(lv_obj_t *obj);
void remove_style_label_hero(lv_obj_t *obj);

// Style: ButtonPrimary
lv_style_t *get_style_button_primary_MAIN_DEFAULT();
void add_style_button_primary(lv_obj_t *obj);
void remove_style_button_primary(lv_obj_t *obj);

// Style: ButtonNeutral
lv_style_t *get_style_button_neutral_MAIN_DEFAULT();
void add_style_button_neutral(lv_obj_t *obj);
void remove_style_button_neutral(lv_obj_t *obj);

// Style: ScaleRing
lv_style_t *get_style_scale_ring_MAIN_DEFAULT();
lv_style_t *get_style_scale_ring_ITEMS_DEFAULT();
lv_style_t *get_style_scale_ring_INDICATOR_DEFAULT();
void add_style_scale_ring(lv_obj_t *obj);
void remove_style_scale_ring(lv_obj_t *obj);

// Style: LabelIcon
lv_style_t *get_style_label_icon_MAIN_DEFAULT();
void add_style_label_icon(lv_obj_t *obj);
void remove_style_label_icon(lv_obj_t *obj);

// Style: LabelIconSm
lv_style_t *get_style_label_icon_sm_MAIN_DEFAULT();
void add_style_label_icon_sm(lv_obj_t *obj);
void remove_style_label_icon_sm(lv_obj_t *obj);

// Style: HeroTile
lv_style_t *get_style_hero_tile_MAIN_DEFAULT();
void add_style_hero_tile(lv_obj_t *obj);
void remove_style_hero_tile(lv_obj_t *obj);

// Style: HeroIcon
lv_style_t *get_style_hero_icon_MAIN_DEFAULT();
void add_style_hero_icon(lv_obj_t *obj);
void remove_style_hero_icon(lv_obj_t *obj);

// Style: NeighbourIcon
lv_style_t *get_style_neighbour_icon_MAIN_DEFAULT();
void add_style_neighbour_icon(lv_obj_t *obj);
void remove_style_neighbour_icon(lv_obj_t *obj);

// Style: DeviceTile
lv_style_t *get_style_device_tile_MAIN_DEFAULT();
lv_style_t *get_style_device_tile_MAIN_CHECKED();
void add_style_device_tile(lv_obj_t *obj);
void remove_style_device_tile(lv_obj_t *obj);

// Style: DeviceIcon
lv_style_t *get_style_device_icon_MAIN_DEFAULT();
lv_style_t *get_style_device_icon_MAIN_CHECKED();
void add_style_device_icon(lv_obj_t *obj);
void remove_style_device_icon(lv_obj_t *obj);

// Style: DeviceNeighbourIcon
lv_style_t *get_style_device_neighbour_icon_MAIN_DEFAULT();
void add_style_device_neighbour_icon(lv_obj_t *obj);
void remove_style_device_neighbour_icon(lv_obj_t *obj);

// Style: AlertRing
lv_style_t *get_style_alert_ring_MAIN_DEFAULT();
void add_style_alert_ring(lv_obj_t *obj);
void remove_style_alert_ring(lv_obj_t *obj);

// Style: LevelWell
lv_style_t *get_style_level_well_MAIN_DEFAULT();
void add_style_level_well(lv_obj_t *obj);
void remove_style_level_well(lv_obj_t *obj);

// Style: LevelRing
lv_style_t *get_style_level_ring_MAIN_DEFAULT();
void add_style_level_ring(lv_obj_t *obj);
void remove_style_level_ring(lv_obj_t *obj);

// Style: LevelLine
lv_style_t *get_style_level_line_MAIN_DEFAULT();
void add_style_level_line(lv_obj_t *obj);
void remove_style_level_line(lv_obj_t *obj);

// Style: LevelBubble
lv_style_t *get_style_level_bubble_MAIN_DEFAULT();
void add_style_level_bubble(lv_obj_t *obj);
void remove_style_level_bubble(lv_obj_t *obj);

// Style: ClimateTicks
lv_style_t *get_style_climate_ticks_MAIN_DEFAULT();
lv_style_t *get_style_climate_ticks_INDICATOR_DEFAULT();
lv_style_t *get_style_climate_ticks_ITEMS_DEFAULT();
void add_style_climate_ticks(lv_obj_t *obj);
void remove_style_climate_ticks(lv_obj_t *obj);

// Style: ClimateSectionHeat
lv_style_t *get_style_climate_section_heat_MAIN_DEFAULT();
lv_style_t *get_style_climate_section_heat_INDICATOR_DEFAULT();
void add_style_climate_section_heat(lv_obj_t *obj);
void remove_style_climate_section_heat(lv_obj_t *obj);

// Style: ClimateSectionCool
lv_style_t *get_style_climate_section_cool_MAIN_DEFAULT();
lv_style_t *get_style_climate_section_cool_INDICATOR_DEFAULT();
void add_style_climate_section_cool(lv_obj_t *obj);
void remove_style_climate_section_cool(lv_obj_t *obj);

// Style: ClimateSectionHold
lv_style_t *get_style_climate_section_hold_MAIN_DEFAULT();
lv_style_t *get_style_climate_section_hold_INDICATOR_DEFAULT();
void add_style_climate_section_hold(lv_obj_t *obj);
void remove_style_climate_section_hold(lv_obj_t *obj);

// Style: ClimateNeedleInside
lv_style_t *get_style_climate_needle_inside_MAIN_DEFAULT();
void add_style_climate_needle_inside(lv_obj_t *obj);
void remove_style_climate_needle_inside(lv_obj_t *obj);

// Style: ClimateNeedleTarget
lv_style_t *get_style_climate_needle_target_MAIN_DEFAULT();
void add_style_climate_needle_target(lv_obj_t *obj);
void remove_style_climate_needle_target(lv_obj_t *obj);

// Style: ClimateNum
lv_style_t *get_style_climate_num_MAIN_DEFAULT();
void add_style_climate_num(lv_obj_t *obj);
void remove_style_climate_num(lv_obj_t *obj);

// Style: ClimateModeText
lv_style_t *get_style_climate_mode_text_MAIN_DEFAULT();
lv_style_t *get_style_climate_mode_text_MAIN_CHECKED();
lv_style_t *get_style_climate_mode_text_MAIN_PRESSED();
lv_style_t *get_style_climate_mode_text_MAIN_DISABLED();
void add_style_climate_mode_text(lv_obj_t *obj);
void remove_style_climate_mode_text(lv_obj_t *obj);

// Style: ClimateModeIcon
lv_style_t *get_style_climate_mode_icon_MAIN_DEFAULT();
lv_style_t *get_style_climate_mode_icon_MAIN_CHECKED();
lv_style_t *get_style_climate_mode_icon_MAIN_PRESSED();
lv_style_t *get_style_climate_mode_icon_MAIN_DISABLED();
void add_style_climate_mode_icon(lv_obj_t *obj);
void remove_style_climate_mode_icon(lv_obj_t *obj);

// Style: EnergyArc
lv_style_t *get_style_energy_arc_MAIN_DEFAULT();
lv_style_t *get_style_energy_arc_INDICATOR_DEFAULT();
lv_style_t *get_style_energy_arc_INDICATOR_CHECKED();
lv_style_t *get_style_energy_arc_INDICATOR_PRESSED();
lv_style_t *get_style_energy_arc_INDICATOR_DISABLED();
lv_style_t *get_style_energy_arc_KNOB_DEFAULT();
void add_style_energy_arc(lv_obj_t *obj);
void remove_style_energy_arc(lv_obj_t *obj);

// Style: EnergyHead
lv_style_t *get_style_energy_head_MAIN_DEFAULT();
lv_style_t *get_style_energy_head_MAIN_CHECKED();
lv_style_t *get_style_energy_head_MAIN_PRESSED();
void add_style_energy_head(lv_obj_t *obj);
void remove_style_energy_head(lv_obj_t *obj);

// Style: EnergyHeadIcon
lv_style_t *get_style_energy_head_icon_MAIN_DEFAULT();
lv_style_t *get_style_energy_head_icon_MAIN_CHECKED();
lv_style_t *get_style_energy_head_icon_MAIN_PRESSED();
void add_style_energy_head_icon(lv_obj_t *obj);
void remove_style_energy_head_icon(lv_obj_t *obj);

// Style: EnergyUnit
lv_style_t *get_style_energy_unit_MAIN_DEFAULT();
void add_style_energy_unit(lv_obj_t *obj);
void remove_style_energy_unit(lv_obj_t *obj);

// Style: SettingsTile
lv_style_t *get_style_settings_tile_MAIN_DEFAULT();
lv_style_t *get_style_settings_tile_MAIN_CHECKED();
void add_style_settings_tile(lv_obj_t *obj);
void remove_style_settings_tile(lv_obj_t *obj);

// Style: SettingsIcon
lv_style_t *get_style_settings_icon_MAIN_DEFAULT();
lv_style_t *get_style_settings_icon_MAIN_CHECKED();
void add_style_settings_icon(lv_obj_t *obj);
void remove_style_settings_icon(lv_obj_t *obj);

// Style: SettingsValue
lv_style_t *get_style_settings_value_MAIN_DEFAULT();
lv_style_t *get_style_settings_value_MAIN_CHECKED();
lv_style_t *get_style_settings_value_MAIN_PRESSED();
lv_style_t *get_style_settings_value_MAIN_DISABLED();
void add_style_settings_value(lv_obj_t *obj);
void remove_style_settings_value(lv_obj_t *obj);

// Style: ListRow
lv_style_t *get_style_list_row_MAIN_DEFAULT();
lv_style_t *get_style_list_row_MAIN_CHECKED();
void add_style_list_row(lv_obj_t *obj);
void remove_style_list_row(lv_obj_t *obj);

// Style: GuideTile
lv_style_t *get_style_guide_tile_MAIN_DEFAULT();
void add_style_guide_tile(lv_obj_t *obj);
void remove_style_guide_tile(lv_obj_t *obj);

// Style: GuideIcon
lv_style_t *get_style_guide_icon_MAIN_DEFAULT();
void add_style_guide_icon(lv_obj_t *obj);
void remove_style_guide_icon(lv_obj_t *obj);

// Style: GuideTitle
lv_style_t *get_style_guide_title_MAIN_DEFAULT();
void add_style_guide_title(lv_obj_t *obj);
void remove_style_guide_title(lv_obj_t *obj);

// Style: GuideBody
lv_style_t *get_style_guide_body_MAIN_DEFAULT();
void add_style_guide_body(lv_obj_t *obj);
void remove_style_guide_body(lv_obj_t *obj);

// Style: GuideHint
lv_style_t *get_style_guide_hint_MAIN_DEFAULT();
void add_style_guide_hint(lv_obj_t *obj);
void remove_style_guide_hint(lv_obj_t *obj);

// Style: GuideHintIcon
lv_style_t *get_style_guide_hint_icon_MAIN_DEFAULT();
void add_style_guide_hint_icon(lv_obj_t *obj);
void remove_style_guide_hint_icon(lv_obj_t *obj);

// Style: GuideDot
lv_style_t *get_style_guide_dot_MAIN_DEFAULT();
lv_style_t *get_style_guide_dot_MAIN_DISABLED();
lv_style_t *get_style_guide_dot_MAIN_CHECKED();
void add_style_guide_dot(lv_obj_t *obj);
void remove_style_guide_dot(lv_obj_t *obj);

// Style: FaceTicks
lv_style_t *get_style_face_ticks_MAIN_DEFAULT();
lv_style_t *get_style_face_ticks_ITEMS_DEFAULT();
lv_style_t *get_style_face_ticks_INDICATOR_DEFAULT();
void add_style_face_ticks(lv_obj_t *obj);
void remove_style_face_ticks(lv_obj_t *obj);

// Style: FaceSecTicks
lv_style_t *get_style_face_sec_ticks_MAIN_DEFAULT();
lv_style_t *get_style_face_sec_ticks_ITEMS_DEFAULT();
lv_style_t *get_style_face_sec_ticks_INDICATOR_DEFAULT();
void add_style_face_sec_ticks(lv_obj_t *obj);
void remove_style_face_sec_ticks(lv_obj_t *obj);

// Style: FaceSecOn
lv_style_t *get_style_face_sec_on_MAIN_DEFAULT();
lv_style_t *get_style_face_sec_on_ITEMS_DEFAULT();
lv_style_t *get_style_face_sec_on_INDICATOR_DEFAULT();
void add_style_face_sec_on(lv_obj_t *obj);
void remove_style_face_sec_on(lv_obj_t *obj);

// Style: FaceHandH
lv_style_t *get_style_face_hand_h_MAIN_DEFAULT();
void add_style_face_hand_h(lv_obj_t *obj);
void remove_style_face_hand_h(lv_obj_t *obj);

// Style: FaceHandM
lv_style_t *get_style_face_hand_m_MAIN_DEFAULT();
void add_style_face_hand_m(lv_obj_t *obj);
void remove_style_face_hand_m(lv_obj_t *obj);

// Style: FaceHandS
lv_style_t *get_style_face_hand_s_MAIN_DEFAULT();
void add_style_face_hand_s(lv_obj_t *obj);
void remove_style_face_hand_s(lv_obj_t *obj);

// Style: FaceCap
lv_style_t *get_style_face_cap_MAIN_DEFAULT();
void add_style_face_cap(lv_obj_t *obj);
void remove_style_face_cap(lv_obj_t *obj);

// Style: FaceCapIn
lv_style_t *get_style_face_cap_in_MAIN_DEFAULT();
void add_style_face_cap_in(lv_obj_t *obj);
void remove_style_face_cap_in(lv_obj_t *obj);

// Style: FaceMinArc
lv_style_t *get_style_face_min_arc_MAIN_DEFAULT();
lv_style_t *get_style_face_min_arc_INDICATOR_DEFAULT();
lv_style_t *get_style_face_min_arc_KNOB_DEFAULT();
void add_style_face_min_arc(lv_obj_t *obj);
void remove_style_face_min_arc(lv_obj_t *obj);

// Style: FaceRingArc
lv_style_t *get_style_face_ring_arc_MAIN_DEFAULT();
lv_style_t *get_style_face_ring_arc_INDICATOR_DEFAULT();
lv_style_t *get_style_face_ring_arc_KNOB_DEFAULT();
void add_style_face_ring_arc(lv_obj_t *obj);
void remove_style_face_ring_arc(lv_obj_t *obj);

// Style: FaceTextLg
lv_style_t *get_style_face_text_lg_MAIN_DEFAULT();
void add_style_face_text_lg(lv_obj_t *obj);
void remove_style_face_text_lg(lv_obj_t *obj);

// Style: FaceTextMd
lv_style_t *get_style_face_text_md_MAIN_DEFAULT();
void add_style_face_text_md(lv_obj_t *obj);
void remove_style_face_text_md(lv_obj_t *obj);

// Style: FaceTextMuted
lv_style_t *get_style_face_text_muted_MAIN_DEFAULT();
void add_style_face_text_muted(lv_obj_t *obj);
void remove_style_face_text_muted(lv_obj_t *obj);

// Style: FaceStat
lv_style_t *get_style_face_stat_MAIN_DEFAULT();
void add_style_face_stat(lv_obj_t *obj);
void remove_style_face_stat(lv_obj_t *obj);

// Style: FaceStatIcon
lv_style_t *get_style_face_stat_icon_MAIN_DEFAULT();
void add_style_face_stat_icon(lv_obj_t *obj);
void remove_style_face_stat_icon(lv_obj_t *obj);

// Style: FaceBrandName
lv_style_t *get_style_face_brand_name_MAIN_DEFAULT();
void add_style_face_brand_name(lv_obj_t *obj);
void remove_style_face_brand_name(lv_obj_t *obj);

// Style: FaceTime
lv_style_t *get_style_face_time_MAIN_DEFAULT();
void add_style_face_time(lv_obj_t *obj);
void remove_style_face_time(lv_obj_t *obj);

// Style: FaceTimeSm
lv_style_t *get_style_face_time_sm_MAIN_DEFAULT();
void add_style_face_time_sm(lv_obj_t *obj);
void remove_style_face_time_sm(lv_obj_t *obj);

// Style: FaceAmPm
lv_style_t *get_style_face_am_pm_MAIN_DEFAULT();
void add_style_face_am_pm(lv_obj_t *obj);
void remove_style_face_am_pm(lv_obj_t *obj);

// Style: FaceAmPmSm
lv_style_t *get_style_face_am_pm_sm_MAIN_DEFAULT();
void add_style_face_am_pm_sm(lv_obj_t *obj);
void remove_style_face_am_pm_sm(lv_obj_t *obj);

// Style: FaceRingTime
lv_style_t *get_style_face_ring_time_MAIN_DEFAULT();
void add_style_face_ring_time(lv_obj_t *obj);
void remove_style_face_ring_time(lv_obj_t *obj);

// Style: FaceMode
lv_style_t *get_style_face_mode_MAIN_DEFAULT();
lv_style_t *get_style_face_mode_MAIN_CHECKED();
lv_style_t *get_style_face_mode_MAIN_PRESSED();
lv_style_t *get_style_face_mode_MAIN_DISABLED();
void add_style_face_mode(lv_obj_t *obj);
void remove_style_face_mode(lv_obj_t *obj);

// Style: FaceModeIcon
lv_style_t *get_style_face_mode_icon_MAIN_DEFAULT();
lv_style_t *get_style_face_mode_icon_MAIN_CHECKED();
lv_style_t *get_style_face_mode_icon_MAIN_PRESSED();
lv_style_t *get_style_face_mode_icon_MAIN_DISABLED();
void add_style_face_mode_icon(lv_obj_t *obj);
void remove_style_face_mode_icon(lv_obj_t *obj);

// Style: FaceHourNum
lv_style_t *get_style_face_hour_num_MAIN_DEFAULT();
lv_style_t *get_style_face_hour_num_MAIN_CHECKED();
void add_style_face_hour_num(lv_obj_t *obj);
void remove_style_face_hour_num(lv_obj_t *obj);

// Style: FacePreview
lv_style_t *get_style_face_preview_MAIN_DEFAULT();
void add_style_face_preview(lv_obj_t *obj);
void remove_style_face_preview(lv_obj_t *obj);

// Style: FaceScaled
lv_style_t *get_style_face_scaled_MAIN_DEFAULT();
void add_style_face_scaled(lv_obj_t *obj);
void remove_style_face_scaled(lv_obj_t *obj);

// Style: FacePickSub
lv_style_t *get_style_face_pick_sub_MAIN_DEFAULT();
lv_style_t *get_style_face_pick_sub_MAIN_CHECKED();
void add_style_face_pick_sub(lv_obj_t *obj);
void remove_style_face_pick_sub(lv_obj_t *obj);

// Style: MenuName
lv_style_t *get_style_menu_name_MAIN_DEFAULT();
void add_style_menu_name(lv_obj_t *obj);
void remove_style_menu_name(lv_obj_t *obj);

// Style: MenuSummary
lv_style_t *get_style_menu_summary_MAIN_DEFAULT();
void add_style_menu_summary(lv_obj_t *obj);
void remove_style_menu_summary(lv_obj_t *obj);

// Style: ModeRowHeat
lv_style_t *get_style_mode_row_heat_MAIN_DEFAULT();
lv_style_t *get_style_mode_row_heat_MAIN_CHECKED();
void add_style_mode_row_heat(lv_obj_t *obj);
void remove_style_mode_row_heat(lv_obj_t *obj);
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
