trailcurrentoss/TrailCurrentCapstan/(commit log)

2026-09-28 Project started
    [00-irad-128.stp, 1.46_Rotary_Display_asm_1_asm.stp, makerfabs-matouch-2_1-case.FCStd, partitions.csv]
2026-09-28 WIP: First round of major bug fixes from user testing
    [actions.c, actions.h, main.c, screens.c, screens.h, ui_data.c, ui_data.h, ui_nav.c]
2026-09-28 Switching to carousel for app navigation, fixes for MQTT, fixes for device discovery
    [discovery.c, main.c, screens.c, screens.h]
2026-09-28 Bug fixes for MQTT across all boards. Device discovery implemented following Fireside pattern
    [discovery.c]
2026-09-28 More bug fixes around discovery mode and configuration of lights. Work done to make list of lights dynamic instead of fixed. Status of lights fixed. Discovery fixed for 1.46" screen. Devices moved to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
2026-09-28 Additional bug fixes related to previous commit
    [board_display.c, capstan_config.h]
2026-09-28 Previous commit did NOT have the device control carousel this build does
2026-09-28 Updated dots indicating how many devices are configured
    [makerfabs-matouch-2_1-case.FCStd]
2026-09-29 Bug fixes to level bubble. Design improvements. LEDS used on screens that have them when alarm status triggers
    [board_internal.h, board_leds.c, capstan_board.c, capstan_board.h, ui_alerts.c, ui_data.c]
2026-09-29 Climate fixes plus design changes. LED colors used in the climate UI and device UI for physcial devices that have them. Power screens updated design
    [actions.c, actions.h, screens.c, screens.h, styles.c]
2026-09-29 More design changes for devices app
2026-09-29 Updates to climate modes, implementation of theme switch logic
2026-09-29 Changed wifi to be status only since switching requires a factory reset.
    [screens.c, styles.c, ui_font_fa13.c, ui_font_rm15.c, ui_nav.c]
2026-09-29 Removing back button since it's not needed. Disabling touch all together so that it is 100% tactile experience. Dots relocated on settings now that the back button is gone.
2026-09-29 adding locale settings, changing leveling from degrees to either inches or mm's based on locale. Fixed wrapping of labels in the new locale screens.
    [capstan_config.h, screens.c, screens.h, styles.c]
2026-09-29 Adding getting started app for teaching new users. Also changing LED colors in climate to be visual indicators of which direction is warmer and which direction is cooler.
2026-09-29 Adding selectable watch faces. Fixing bug with watch face previews not aligning.
    [capstan_config.h, images.h, screens.c, screens.h, styles.c]
2026-09-29 More fixes for aligning clock face previews better
    [screens.c, styles.c]
2026-10-01 Updates to case design
    [makerfabs-matouch-2_1-case-desktop.FCStd, makerfabs-matouch-2_1-case.FCStd]
2026-10-01 Added ring led flashing for devices that have them to provide visual feedback to the user as they turn the dial when it is illuminated
    [elecrow-crowpanel-1_28-case.FCStd]
